EwoudVV/calculator/images/arithmetic-branch-gates.png

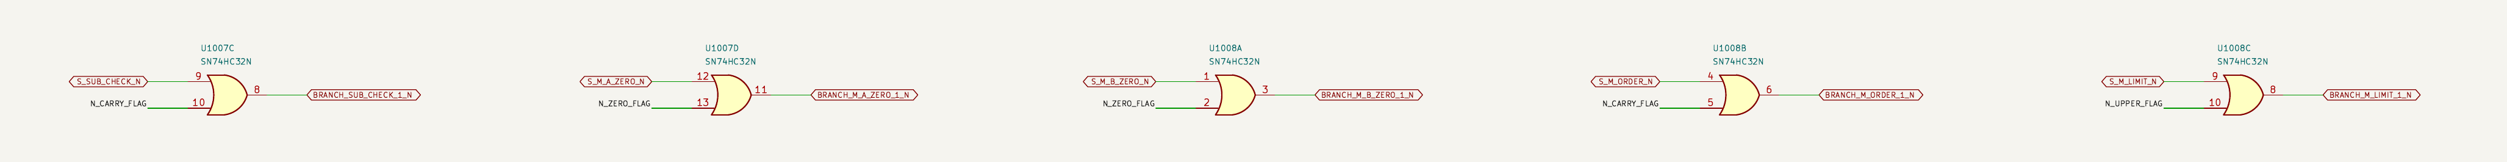
images/arithmetic-branch-gates.png
