EwoudVV/calculator/images/arithmetic-flags.png

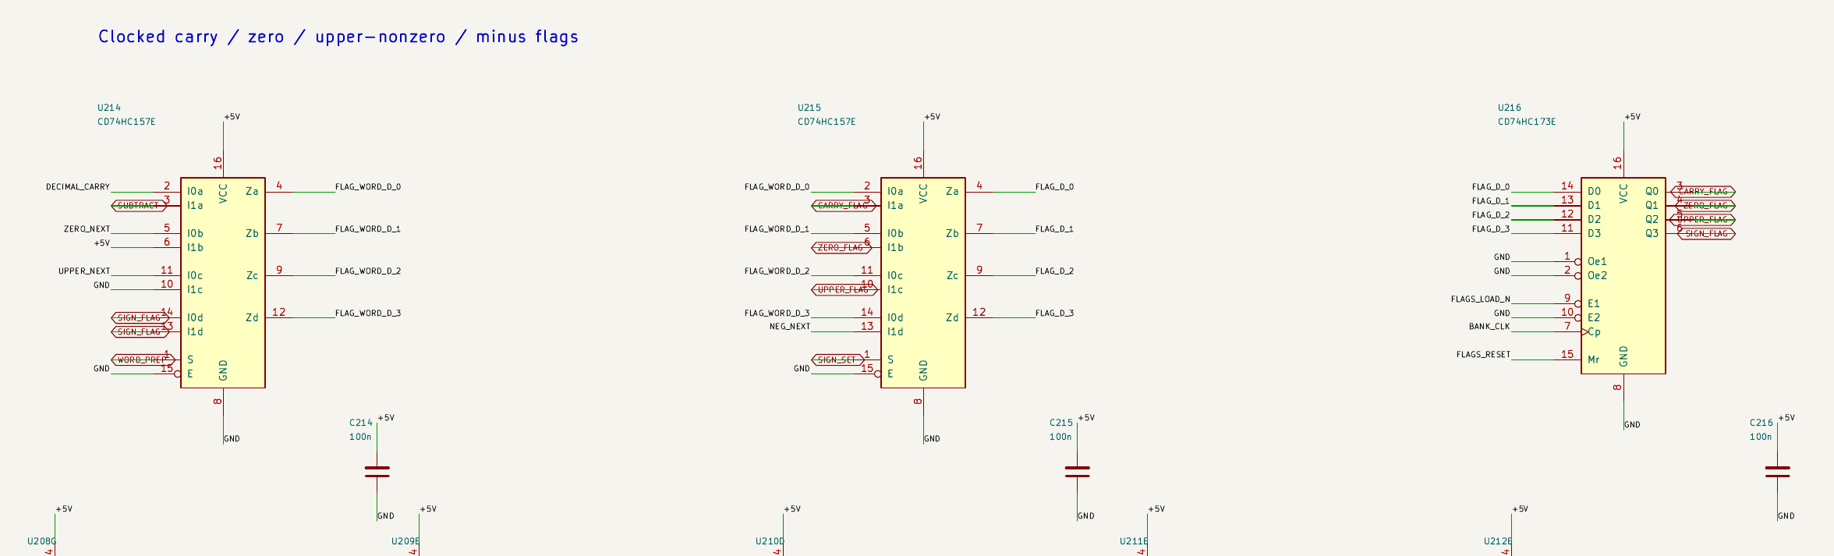
images/arithmetic-flags.png
