EwoudVV/calculator/images/clocked-bank-reset.png

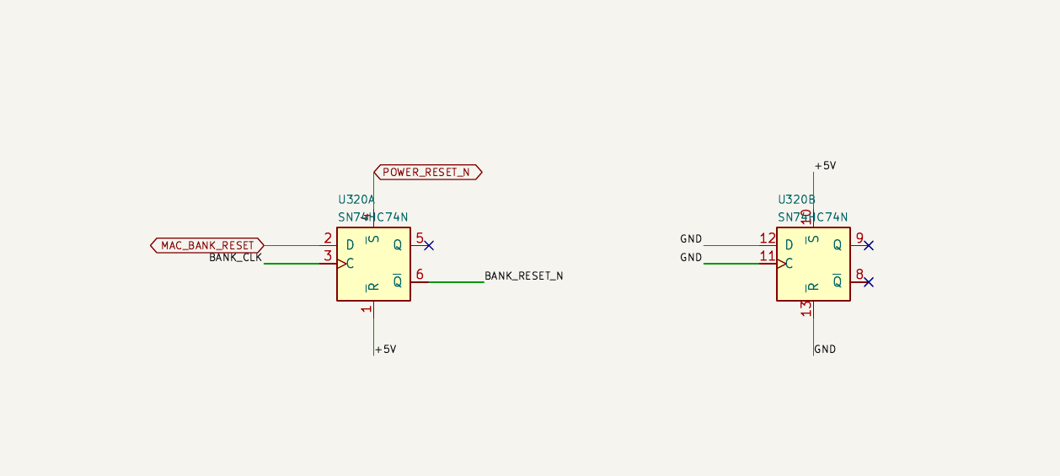
images/clocked-bank-reset.png
