EwoudVV/calculator/images/controller-branches.png

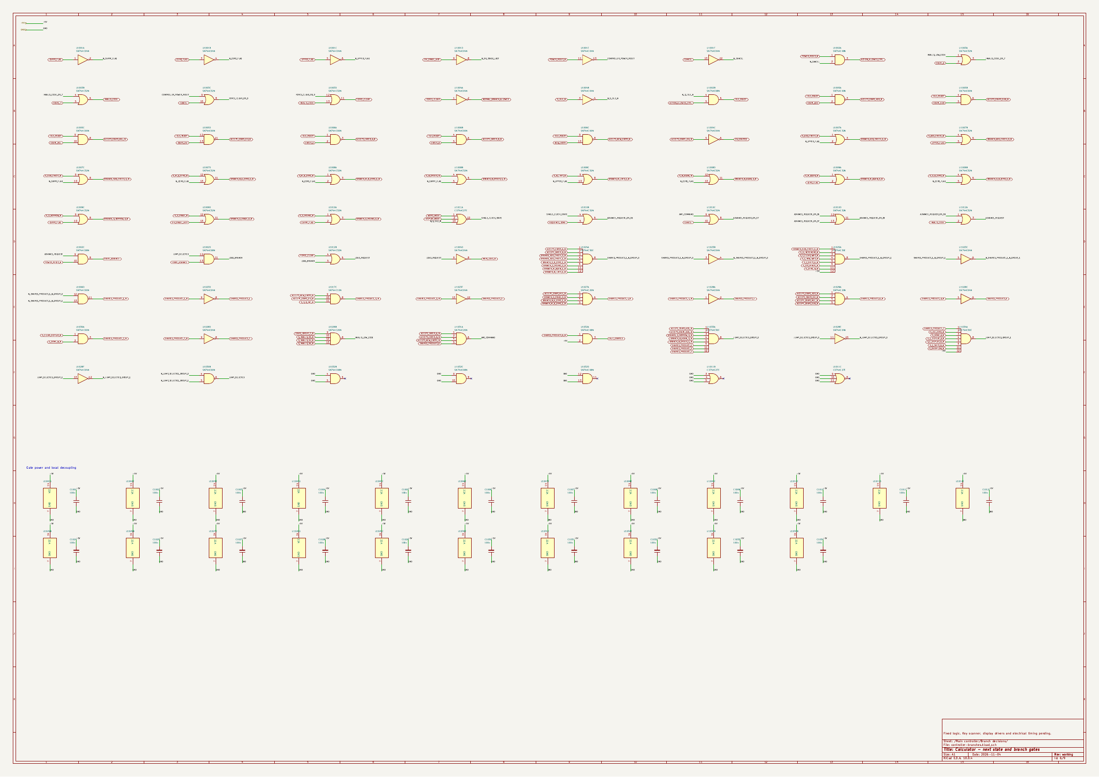
images/controller-branches.png
