EwoudVV/calculator/images/controller-outputs.png

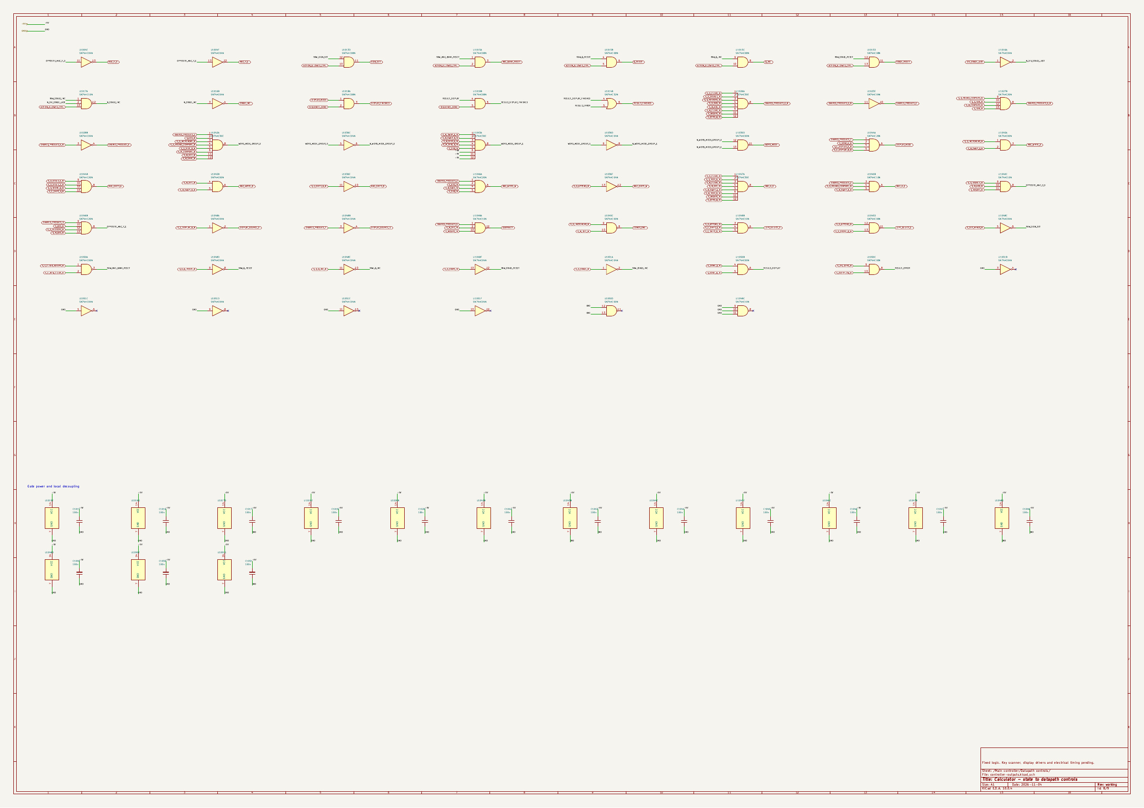
images/controller-outputs.png
