EwoudVV/calculator/images/controller-targets.png

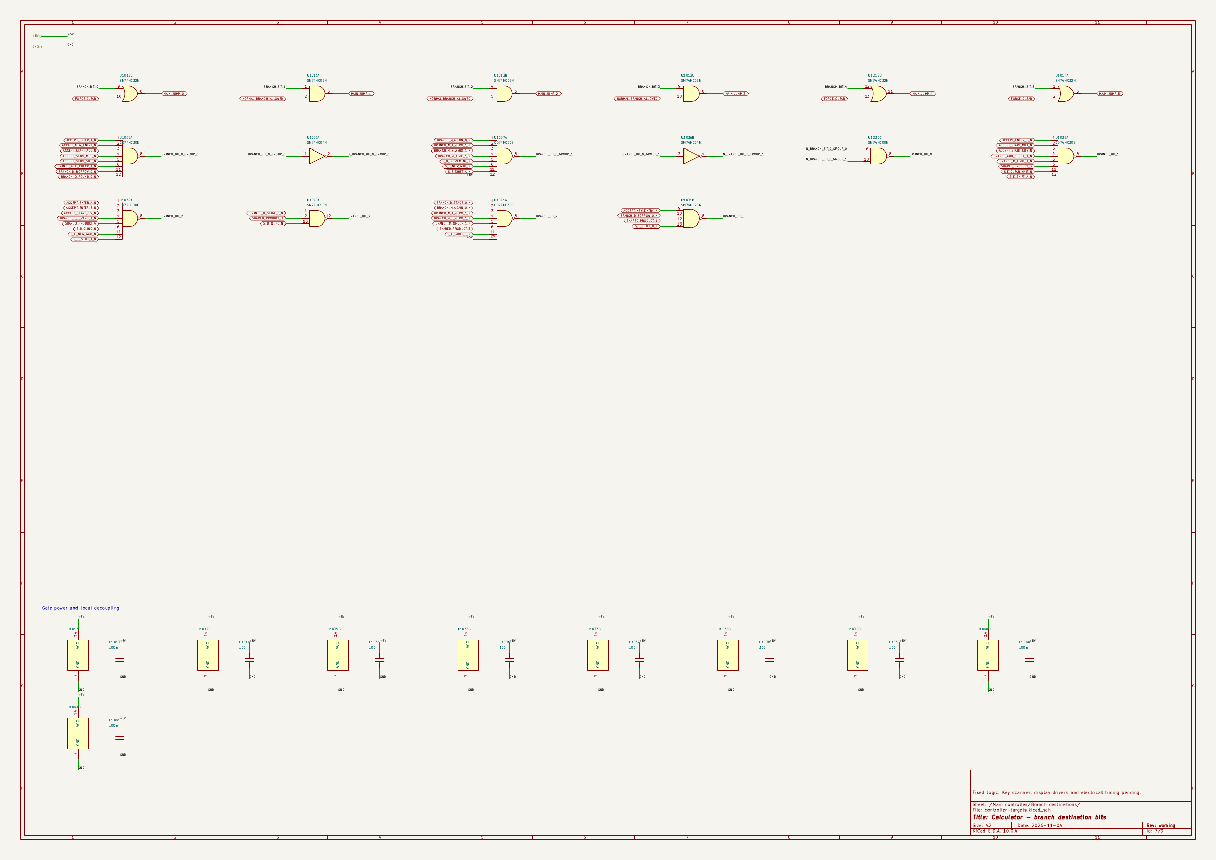
images/controller-targets.png
