EwoudVV/calculator/images/digit-input-selectors.png

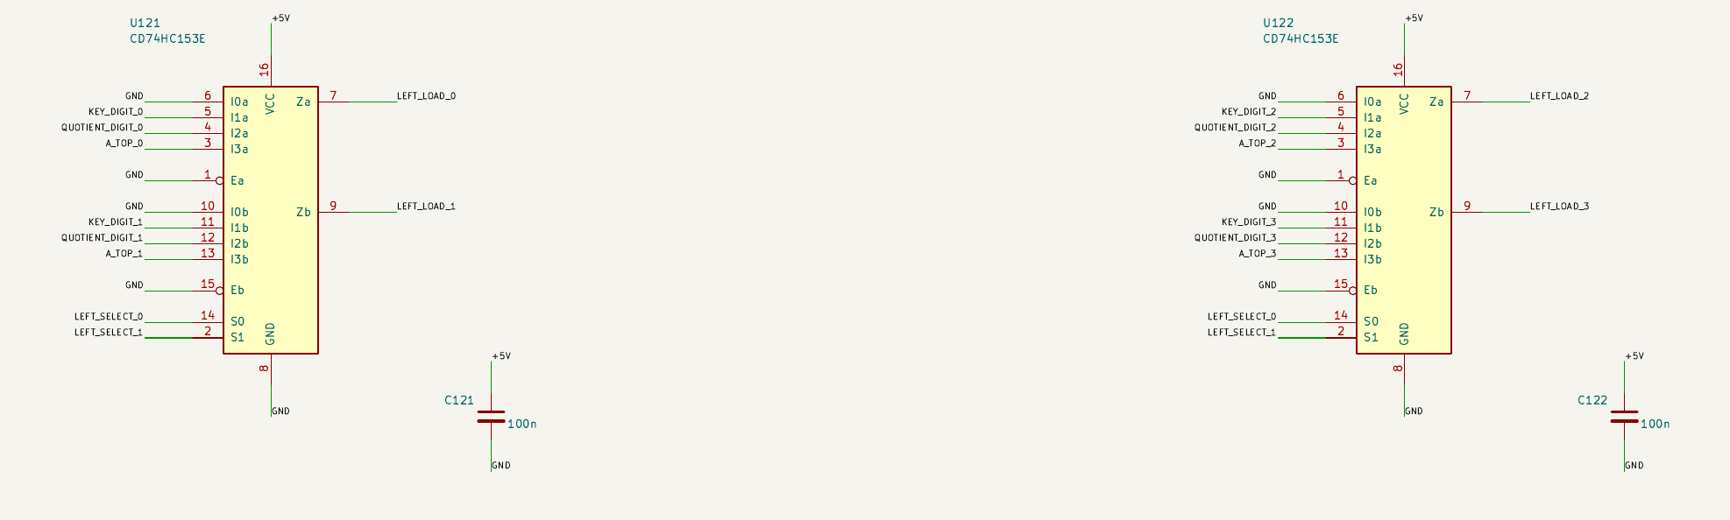
images/digit-input-selectors.png
