EwoudVV/calculator/images/display-latch-register.png

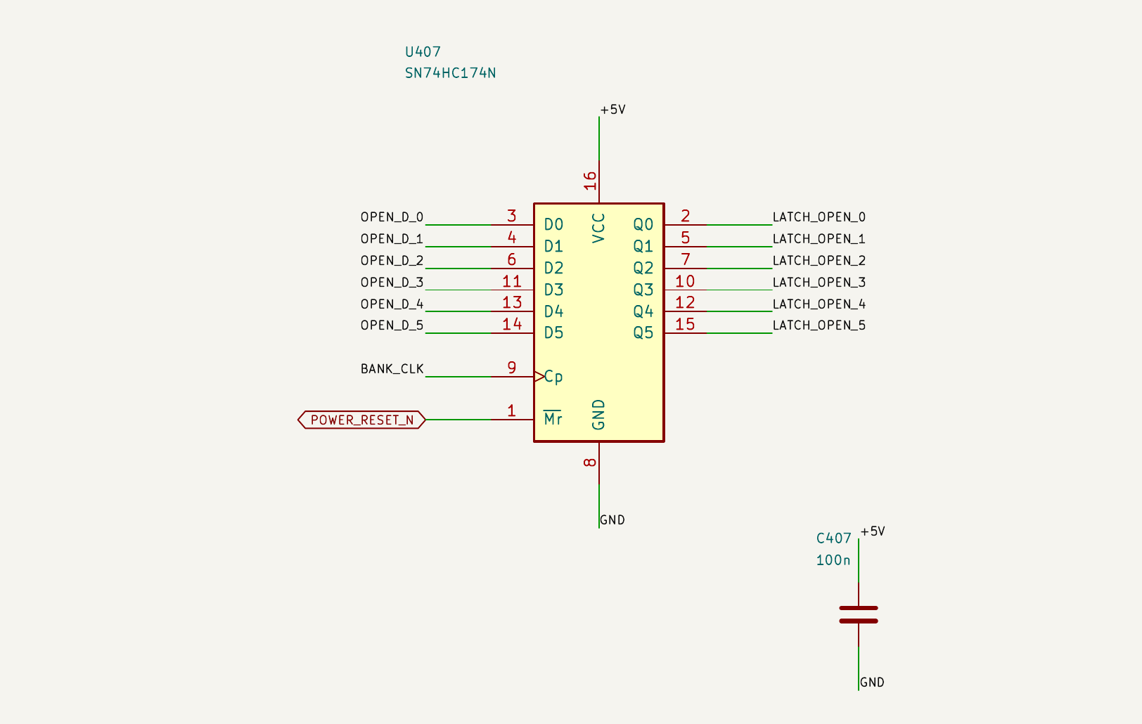
images/display-latch-register.png
