EwoudVV/calculator/images/display-transfer.png

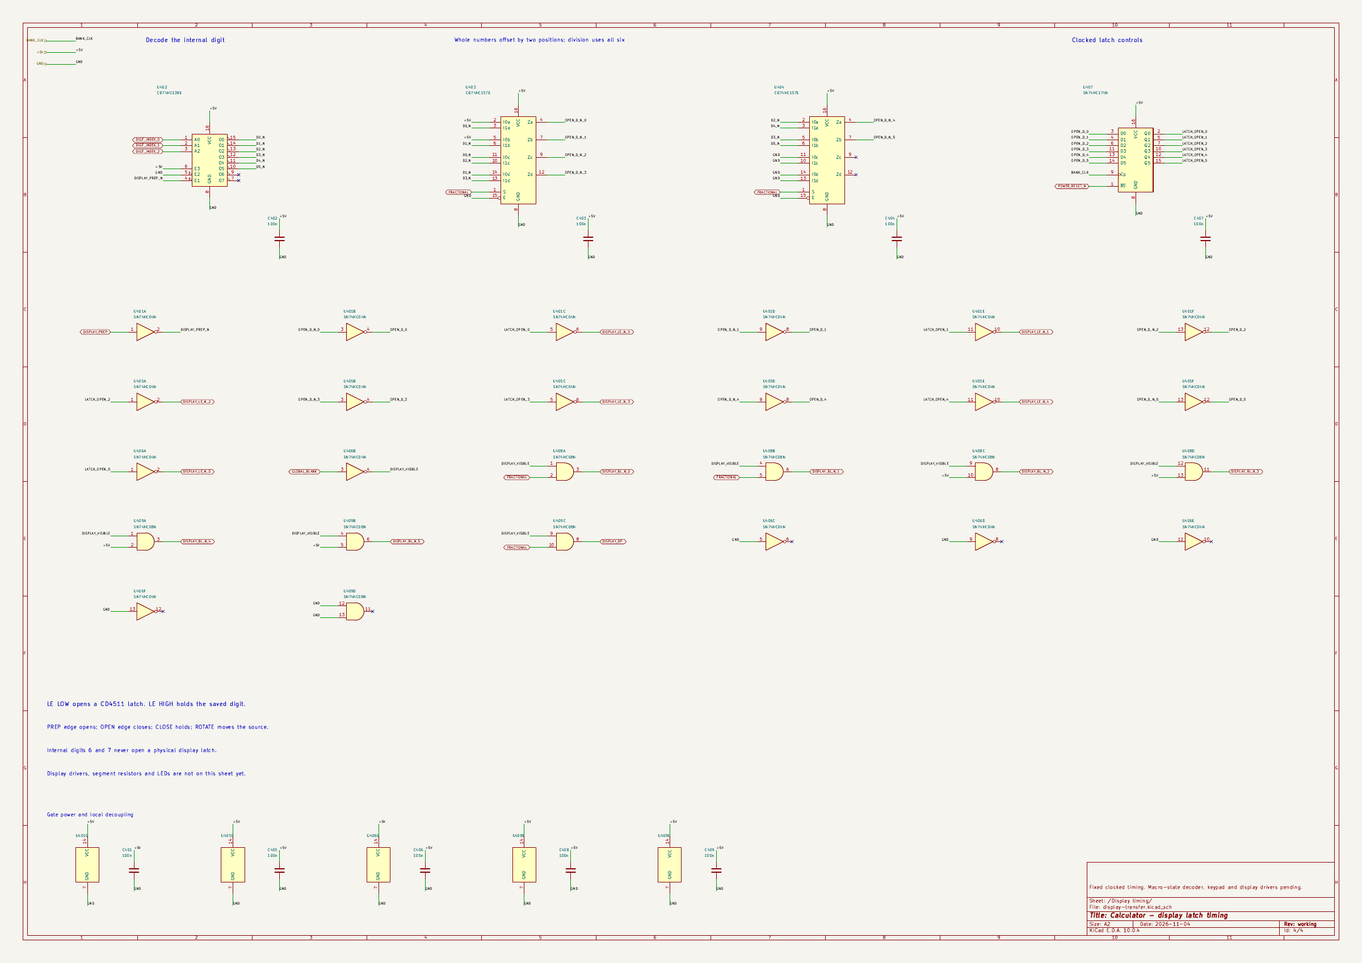
images/display-transfer.png
