EwoudVV/calculator/images/division-counters-status.png

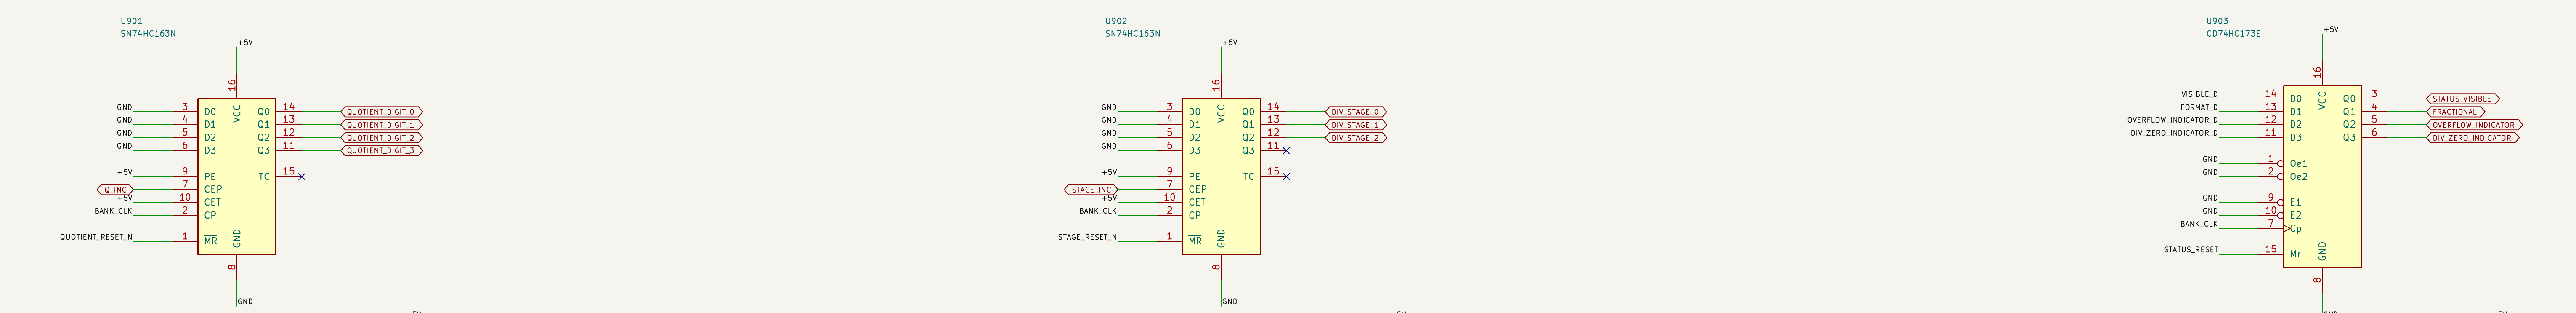
images/division-counters-status.png
