EwoudVV/calculator/images/division-status.png

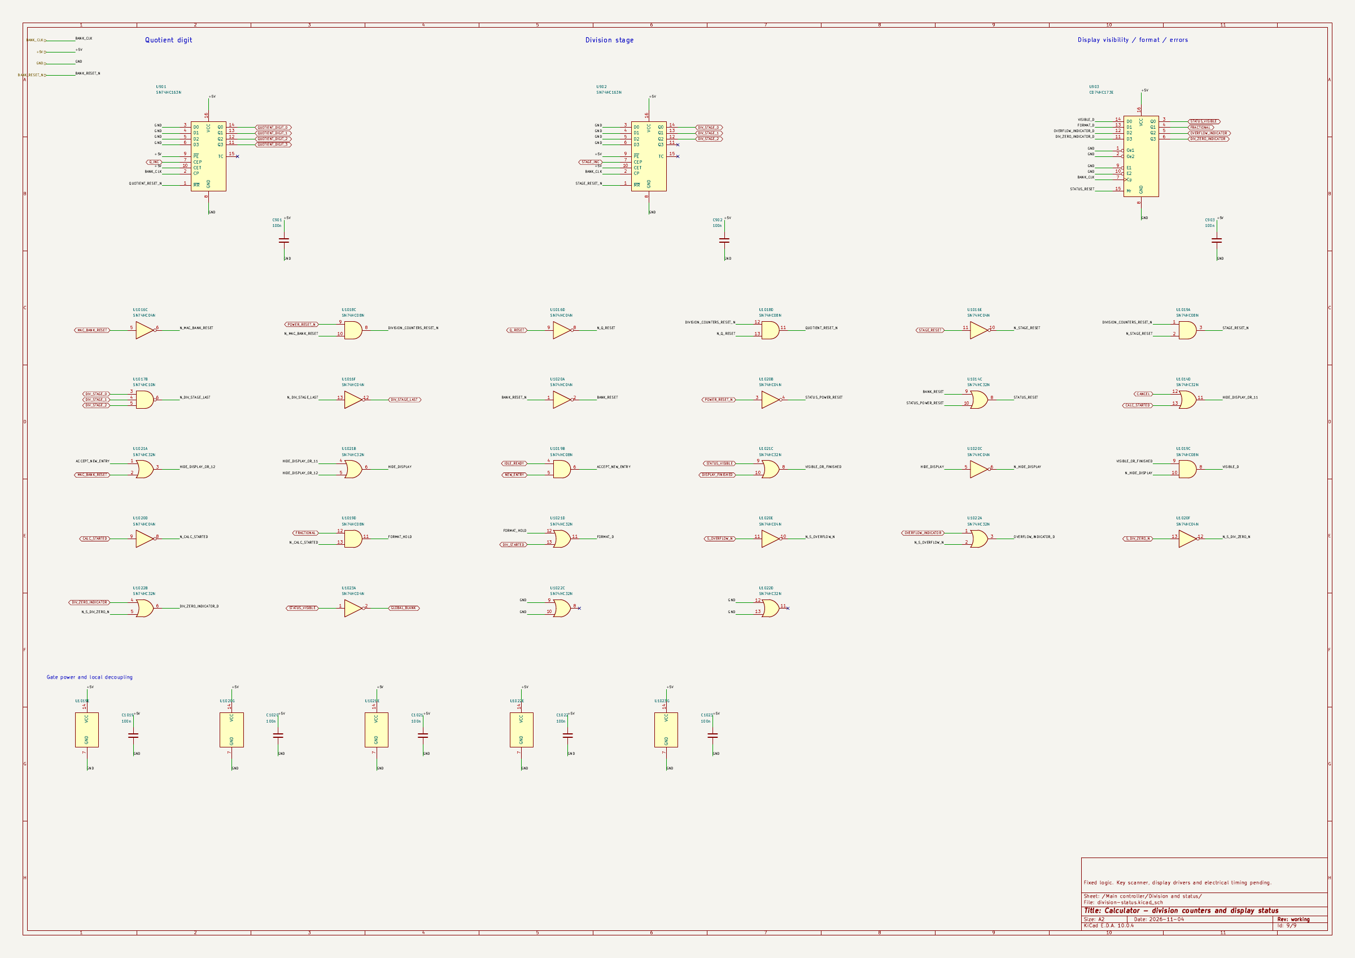
images/division-status.png
