EwoudVV/calculator/images/main-controller.png

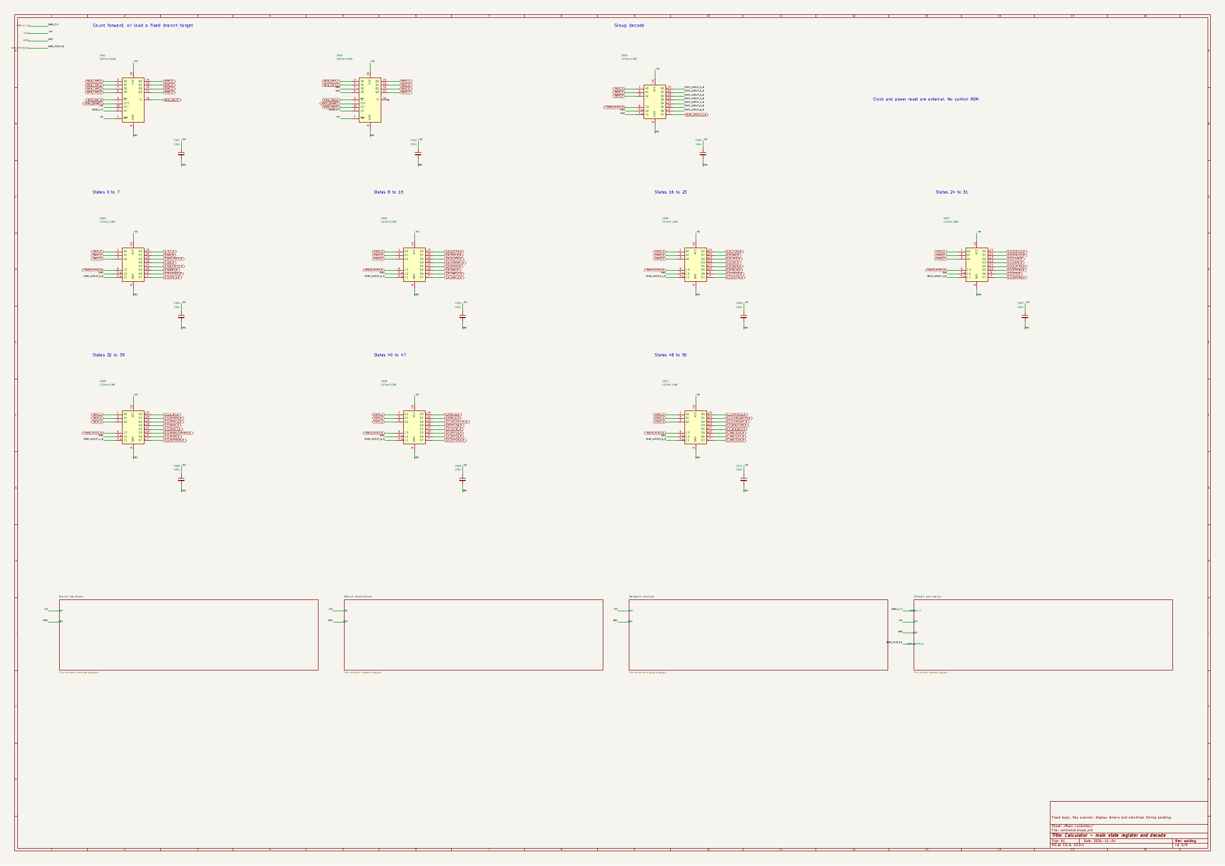
images/main-controller.png
