EwoudVV/calculator/images/main-state-counters.png

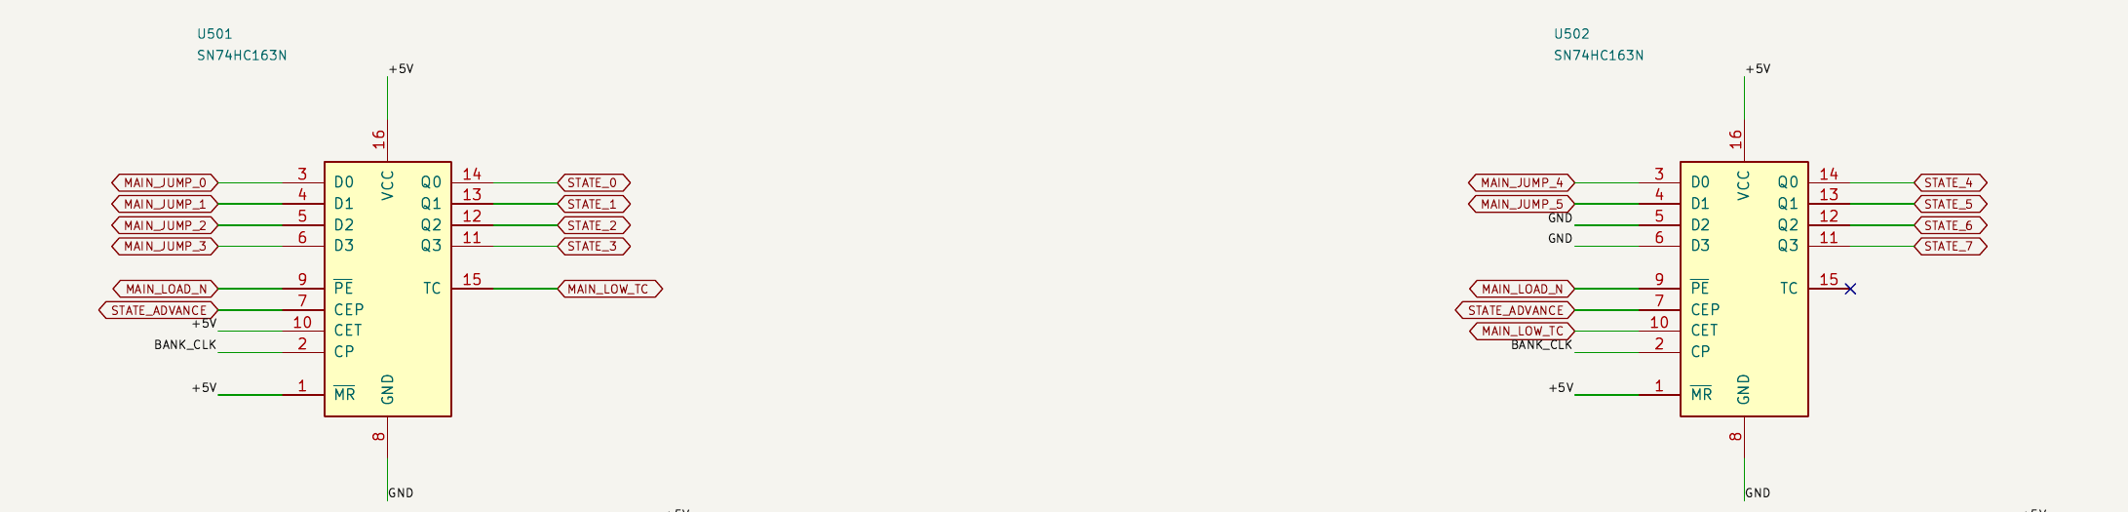
images/main-state-counters.png
