EwoudVV/calculator/images/number-register-bank.png

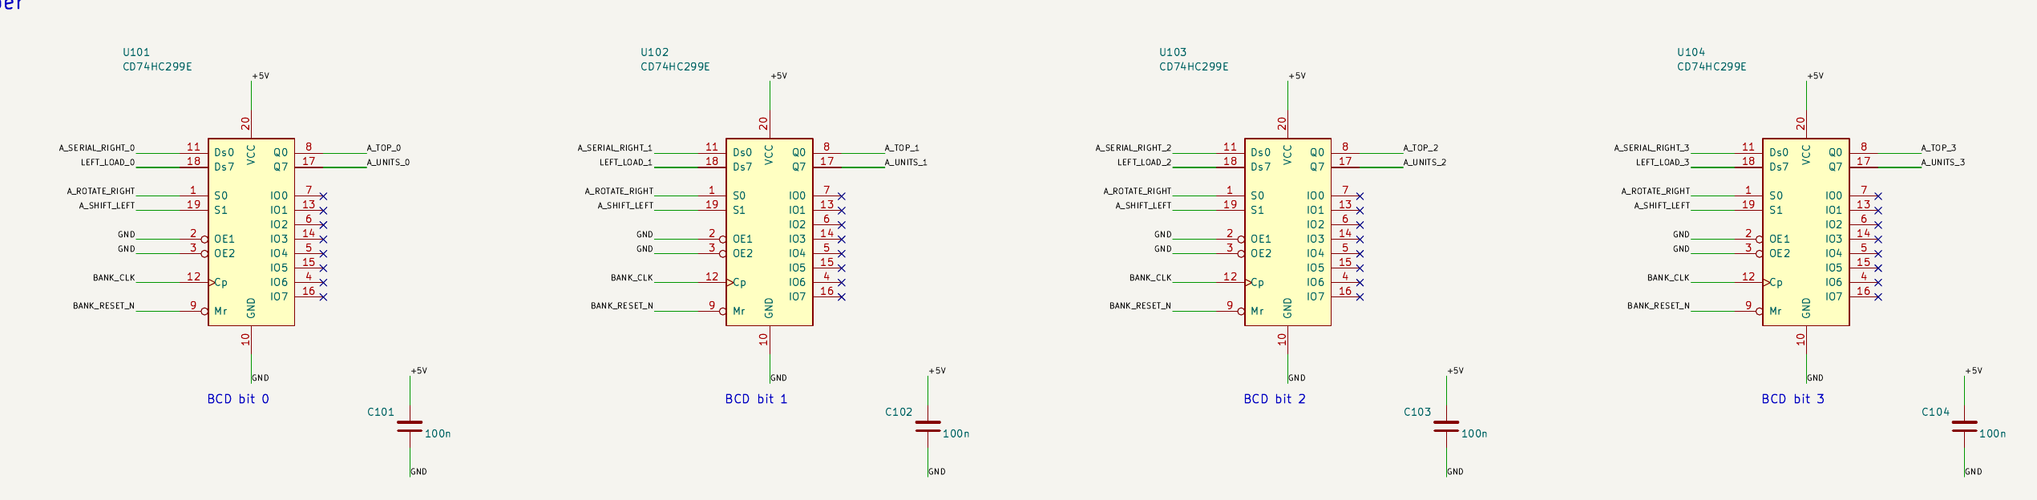
images/number-register-bank.png
