EwoudVV/calculator/images/number-registers.png

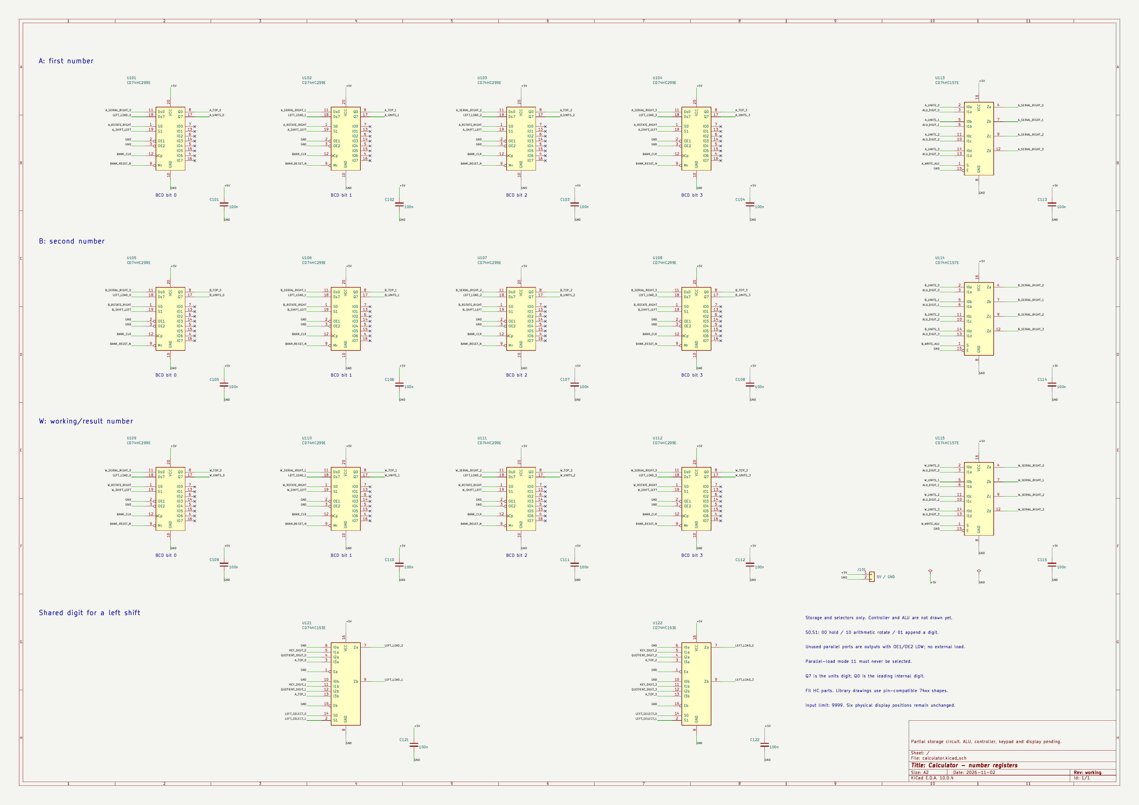
images/number-registers.png
