EwoudVV/calculator/images/pcb-3d-back.png

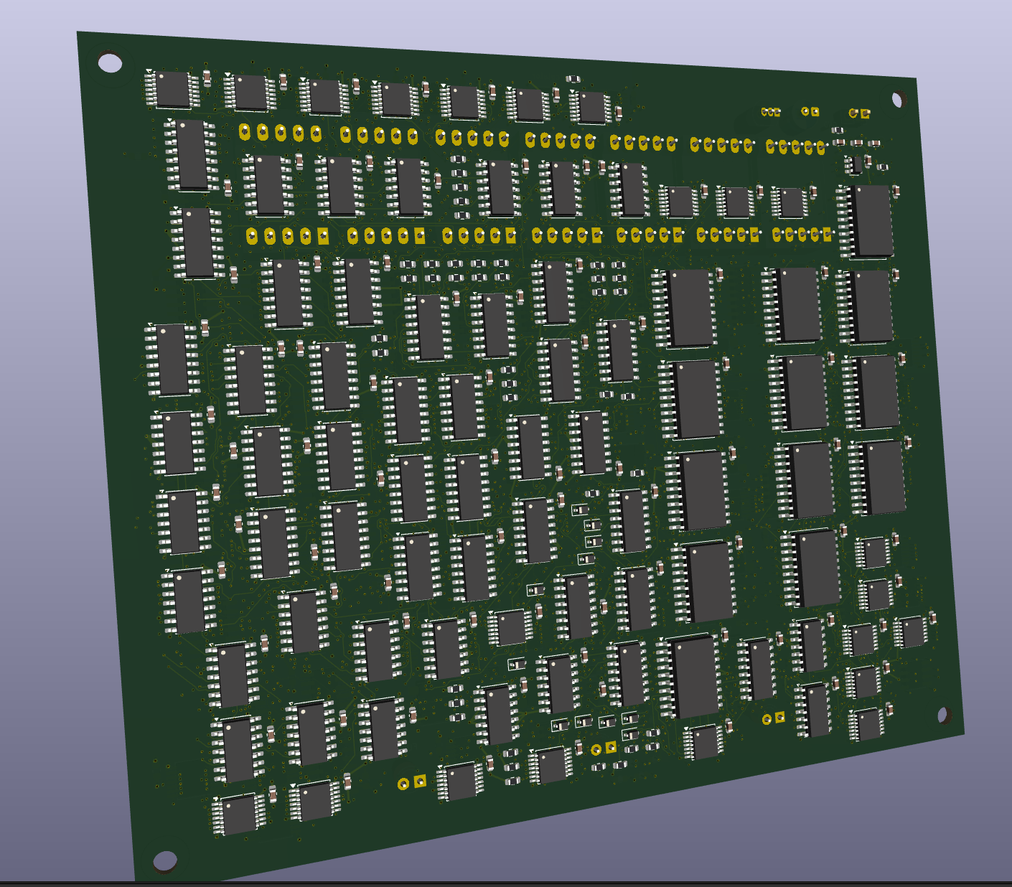
images/pcb-3d-back.png
