EwoudVV/calculator/images/pcb-3d-front.png

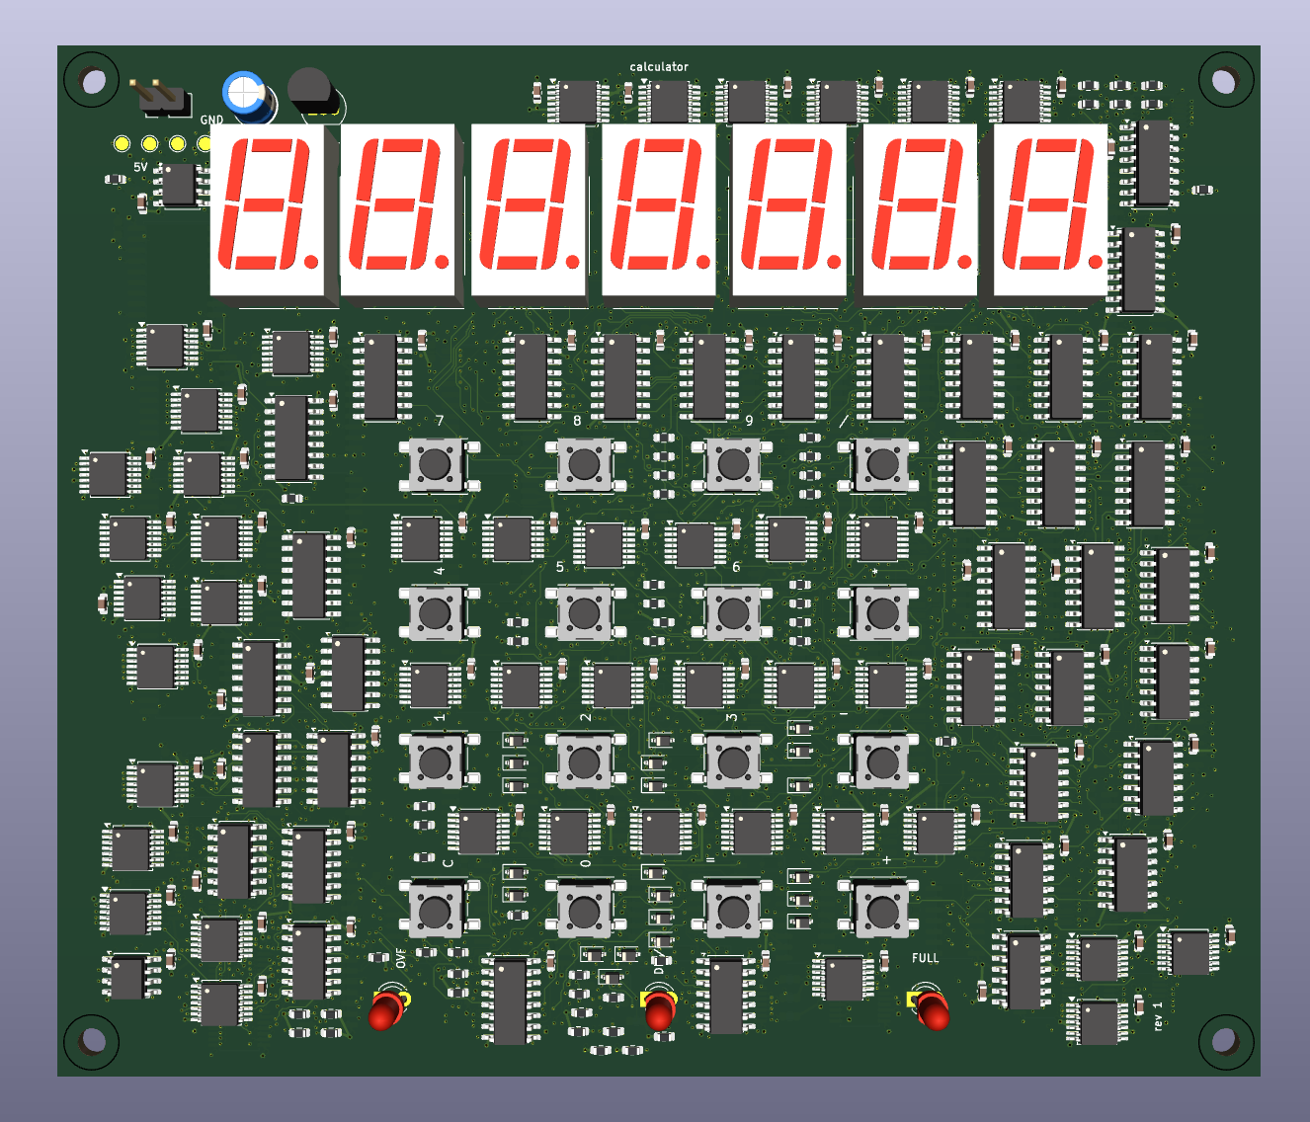
images/pcb-3d-front.png
