EwoudVV/calculator/images/pcb-back.png

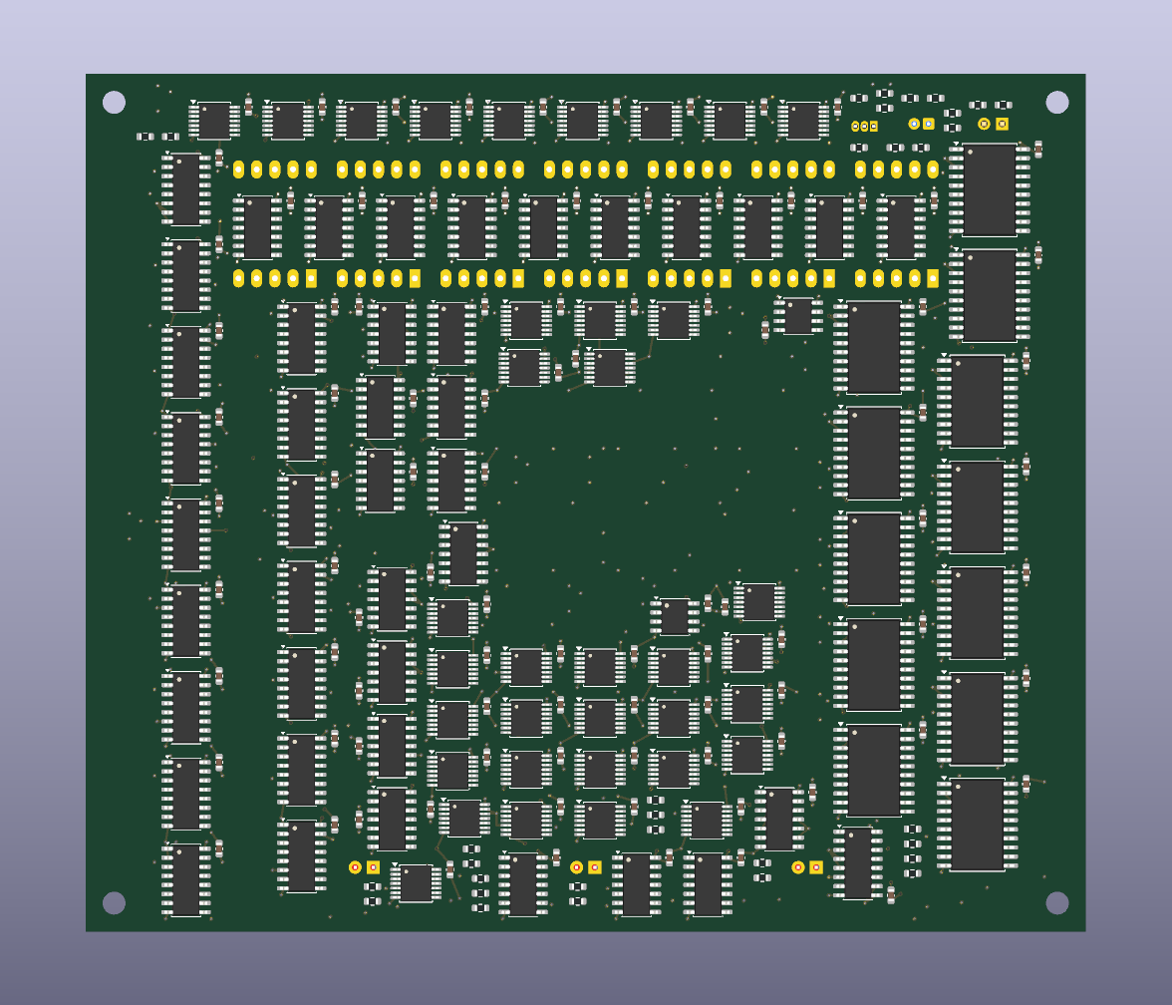
images/pcb-back.png
