EwoudVV/calculator/images/register-bit-lane.png

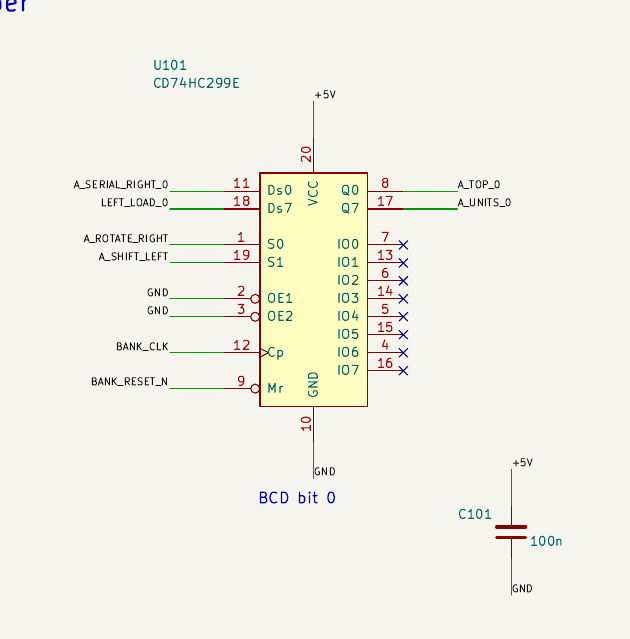
images/register-bit-lane.png
