EwoudVV/calculator/images/register-feedback-selector.png

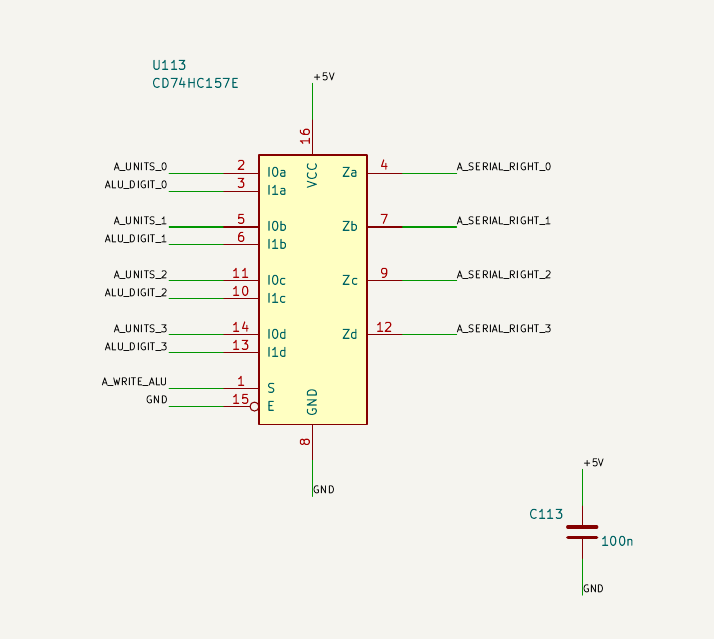
images/register-feedback-selector.png
