EwoudVV/calculator/images/registers-linked.png

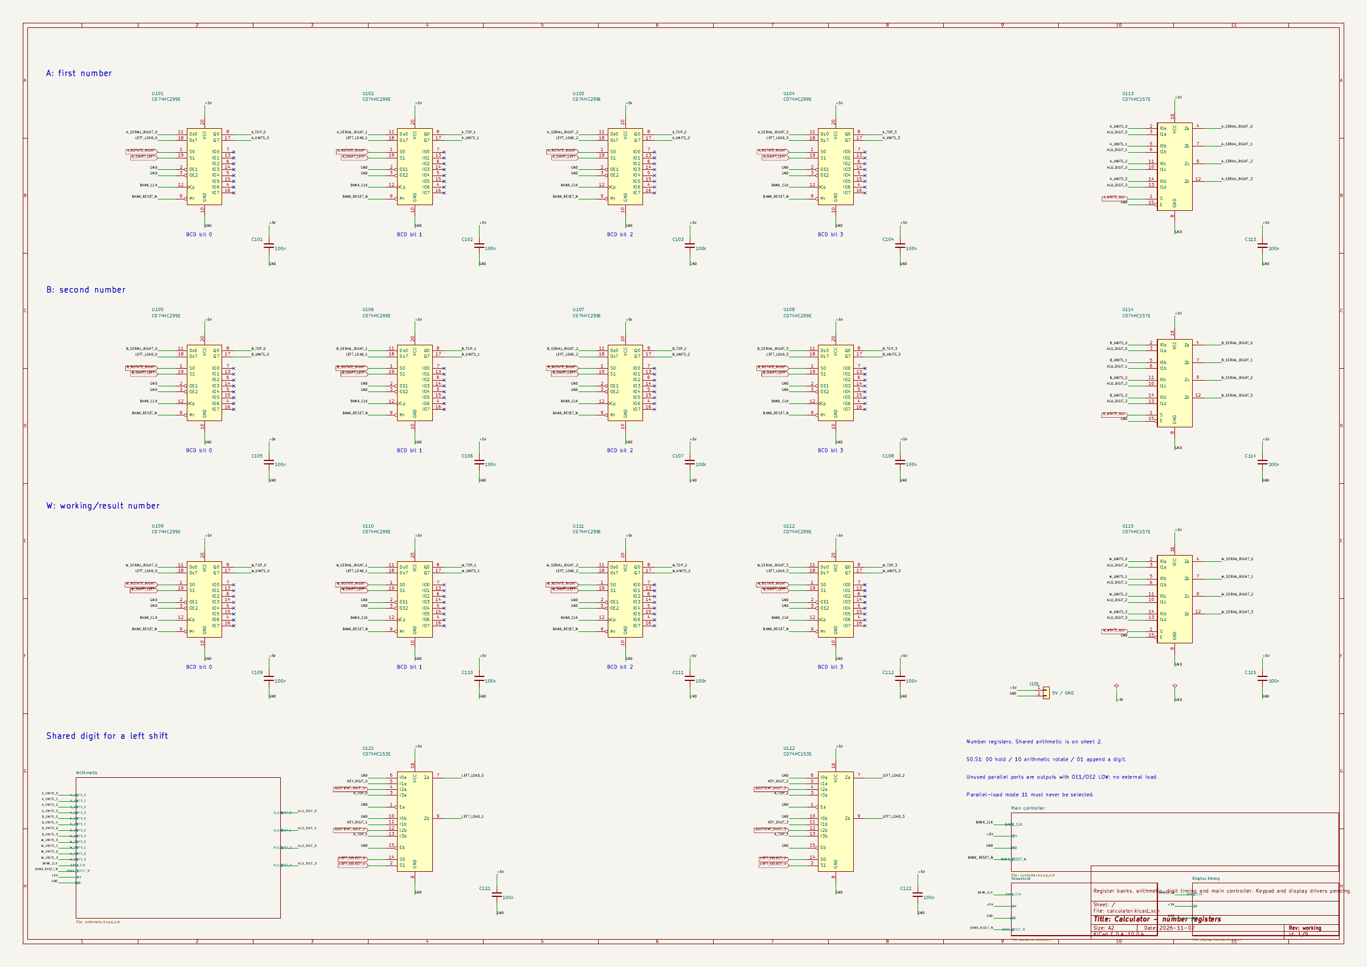
images/registers-linked.png
