EwoudVV/calculator/images/routed-back.png

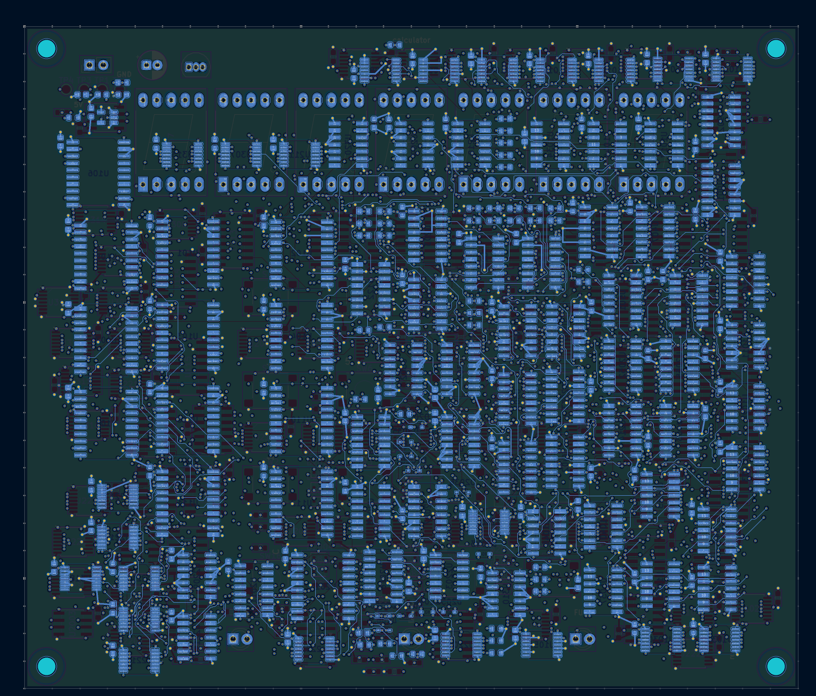
images/routed-back.png
