EwoudVV/calculator/images/routed-front.png

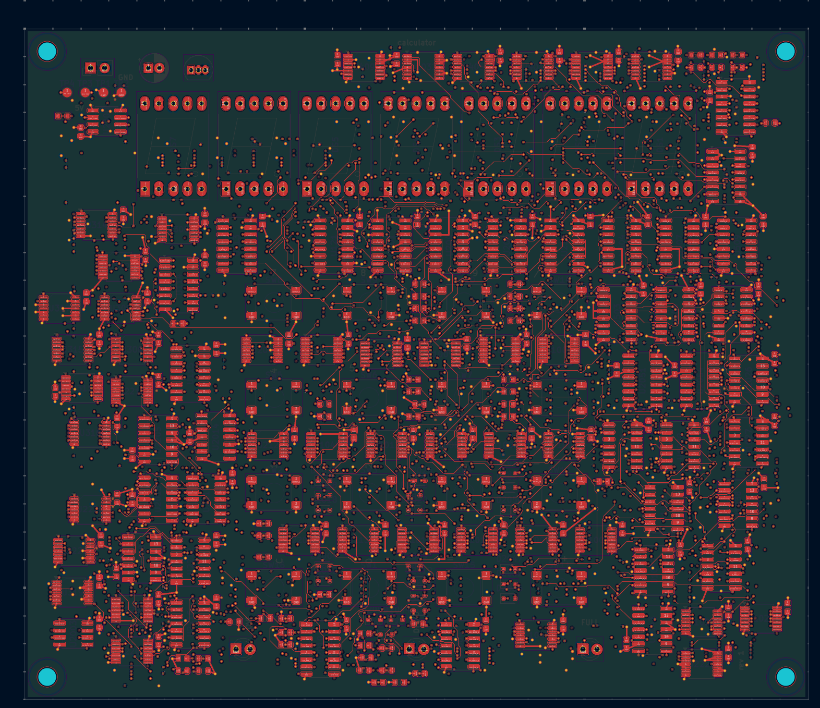
images/routed-front.png
