EwoudVV/calculator/images/routed-inner-1-ground.png

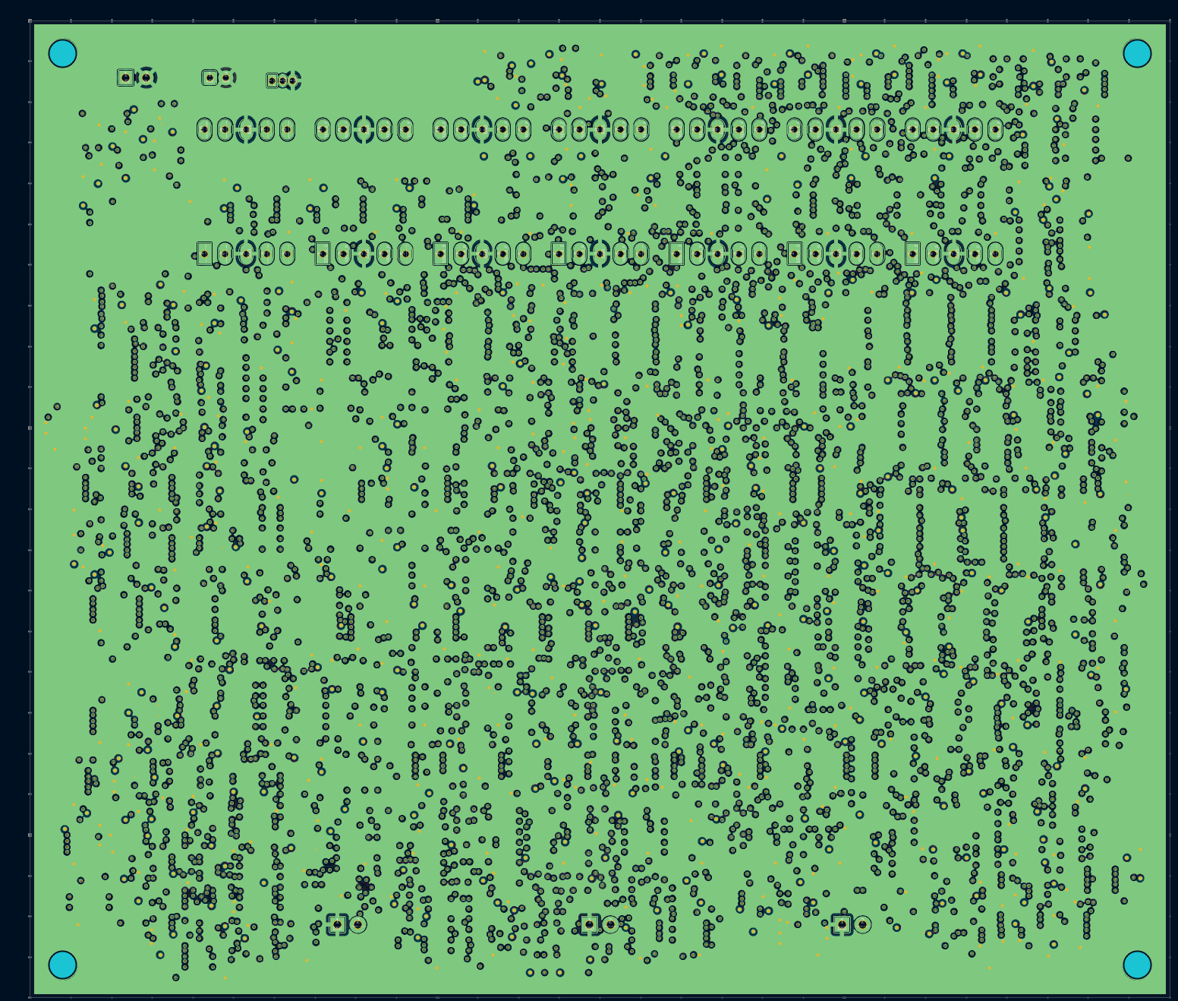
images/routed-inner-1-ground.png
