EwoudVV/calculator/images/routed-inner-2.png

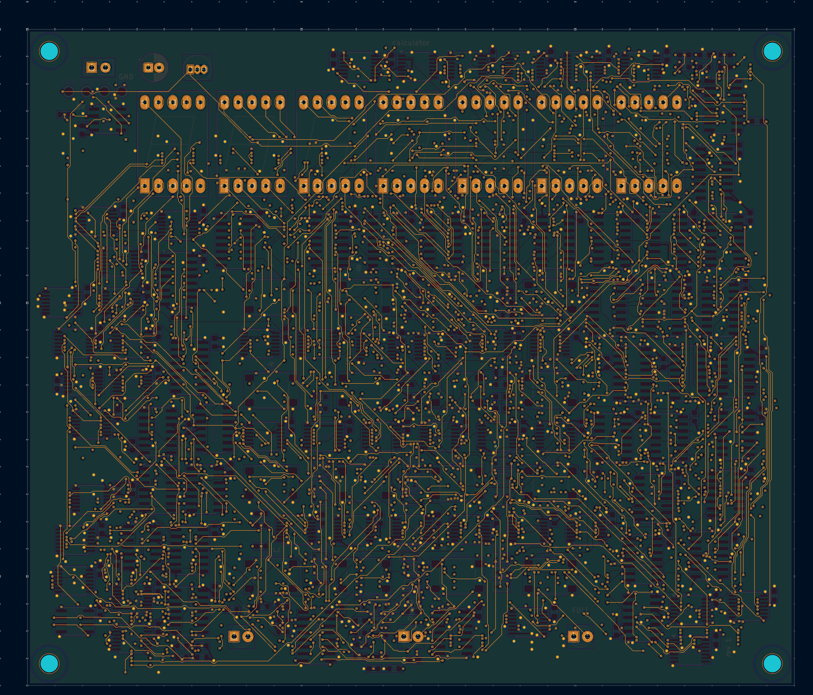
images/routed-inner-2.png
