EwoudVV/calculator/images/routed-inner-3.png

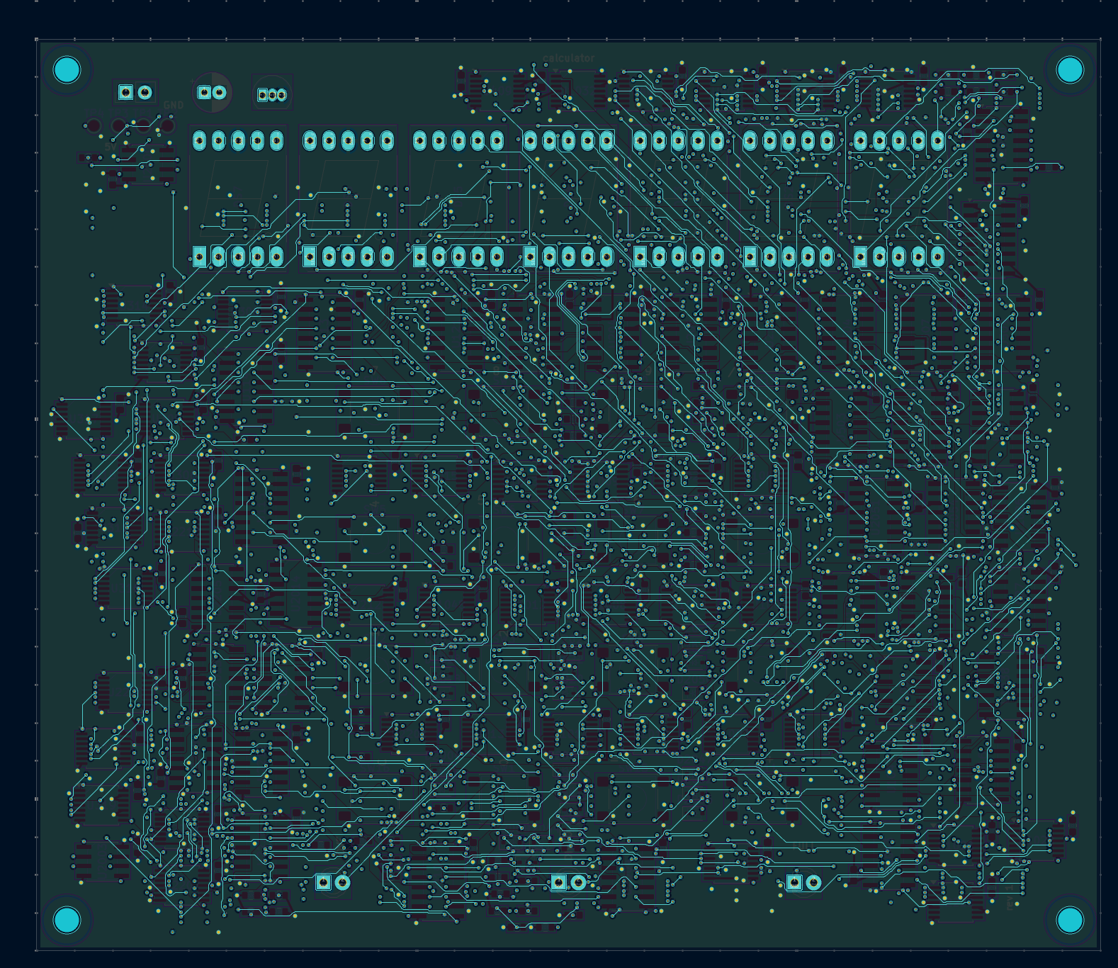
images/routed-inner-3.png
