EwoudVV/calculator/images/routed-inner-4.png

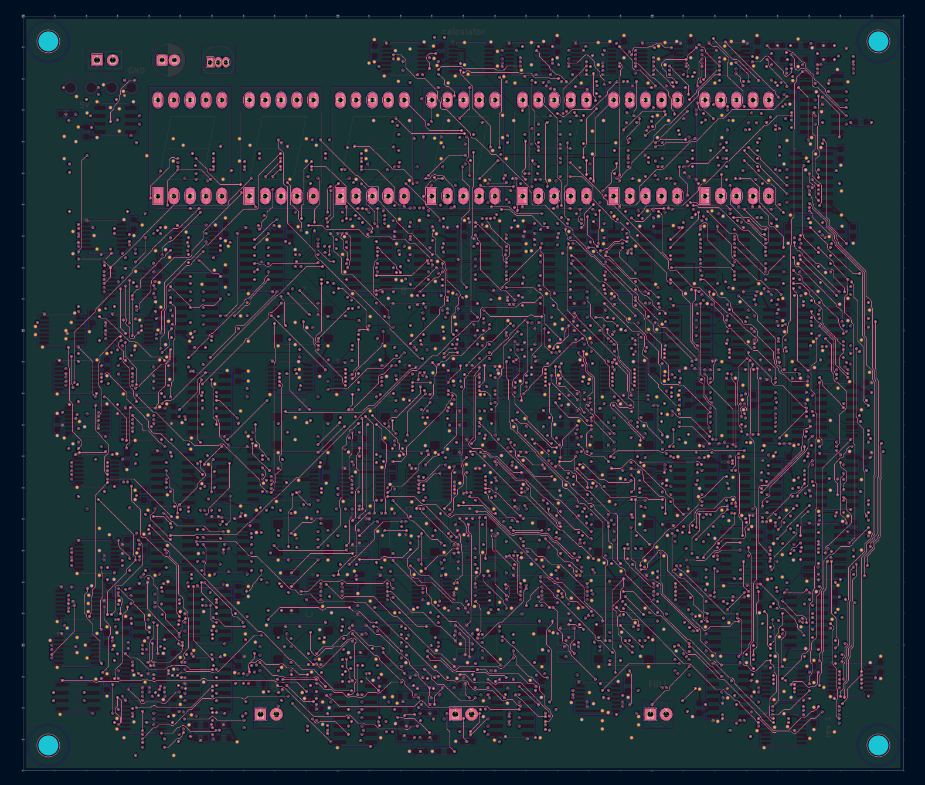
images/routed-inner-4.png
