EwoudVV/calculator/images/routed-inner-5.png

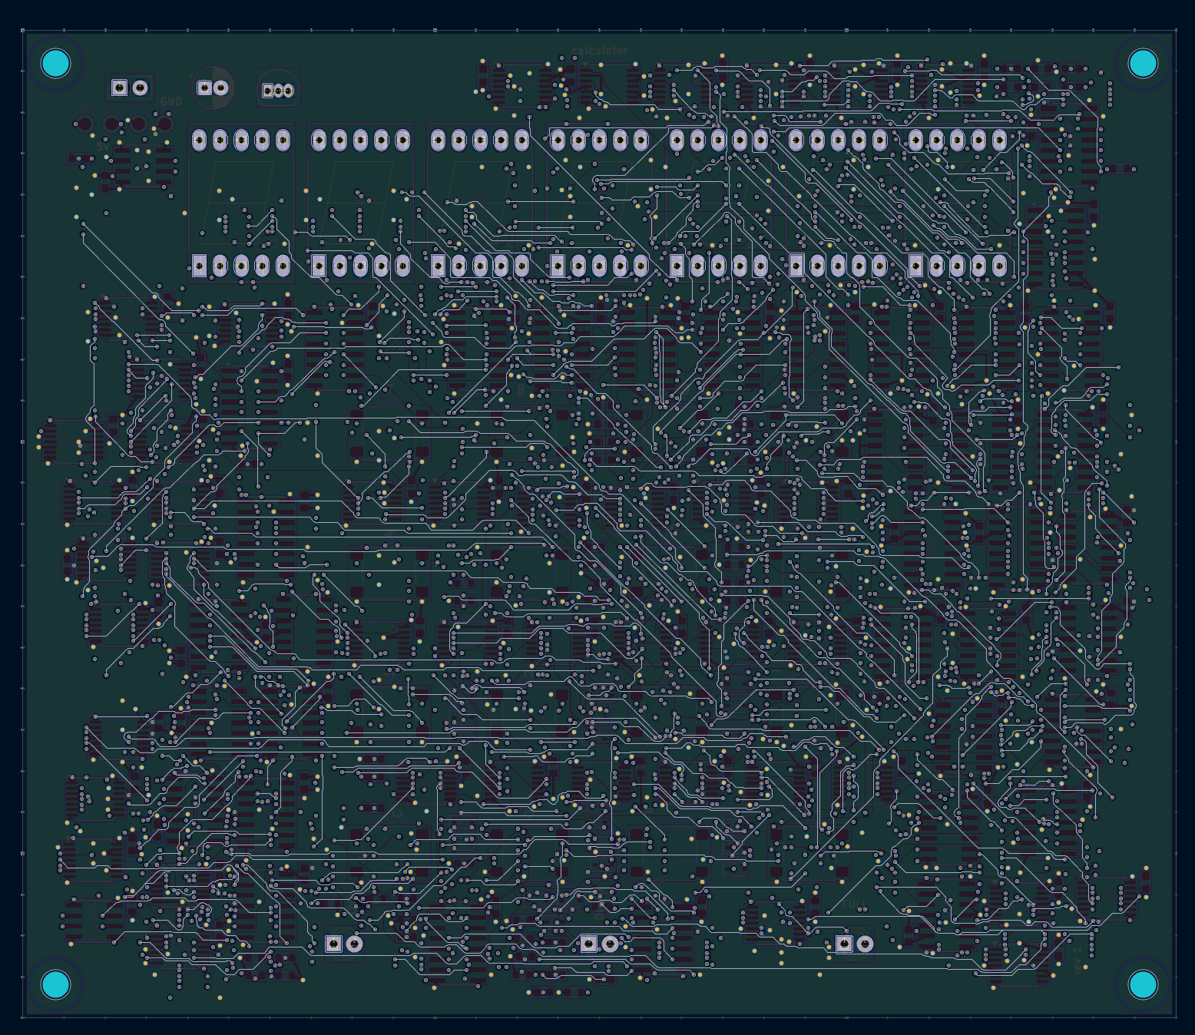
images/routed-inner-5.png
