EwoudVV/calculator/images/routed-inner-7.png

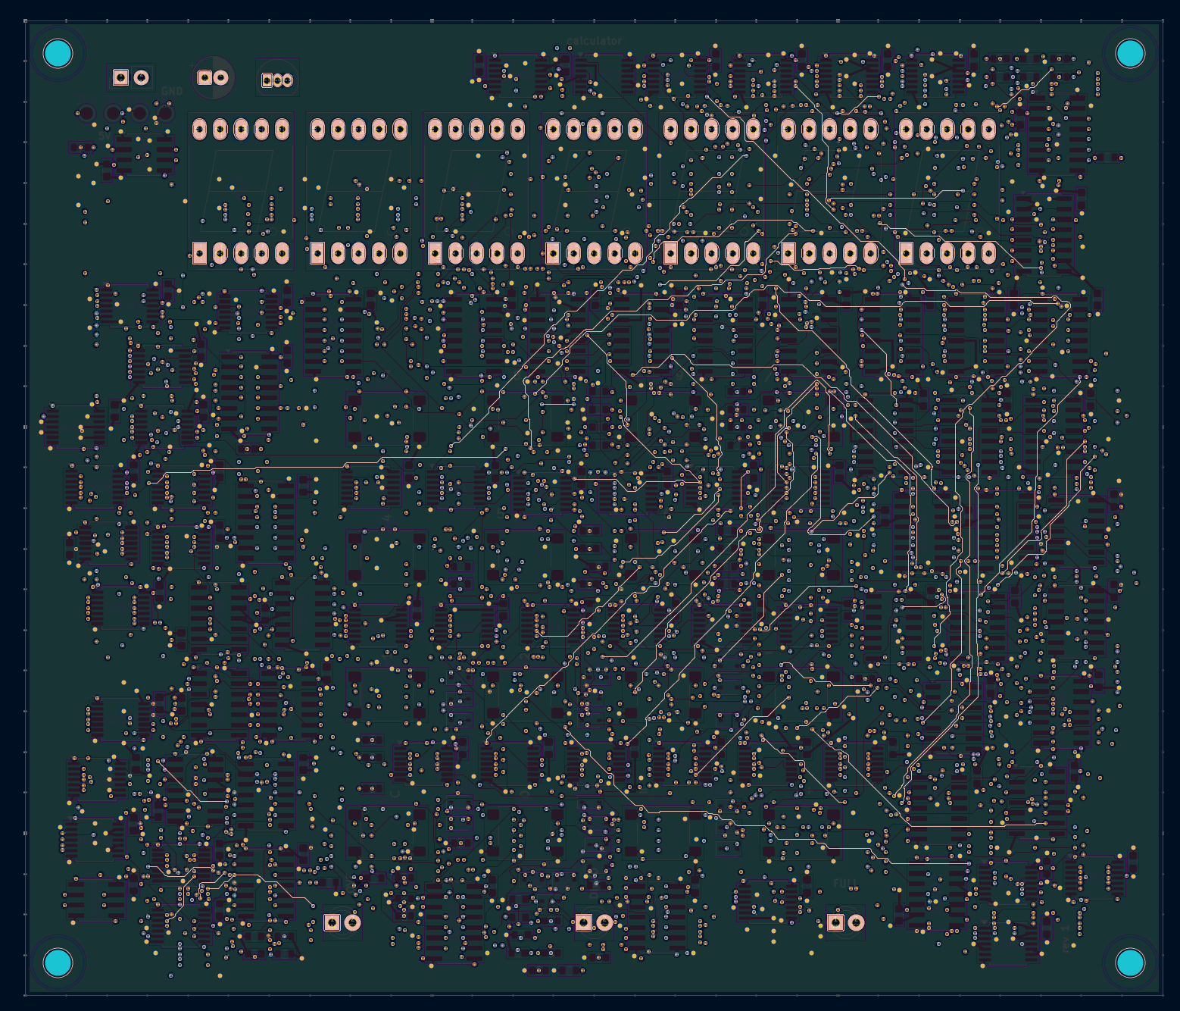
images/routed-inner-7.png
