EwoudVV/calculator/images/routed-inner-8.png

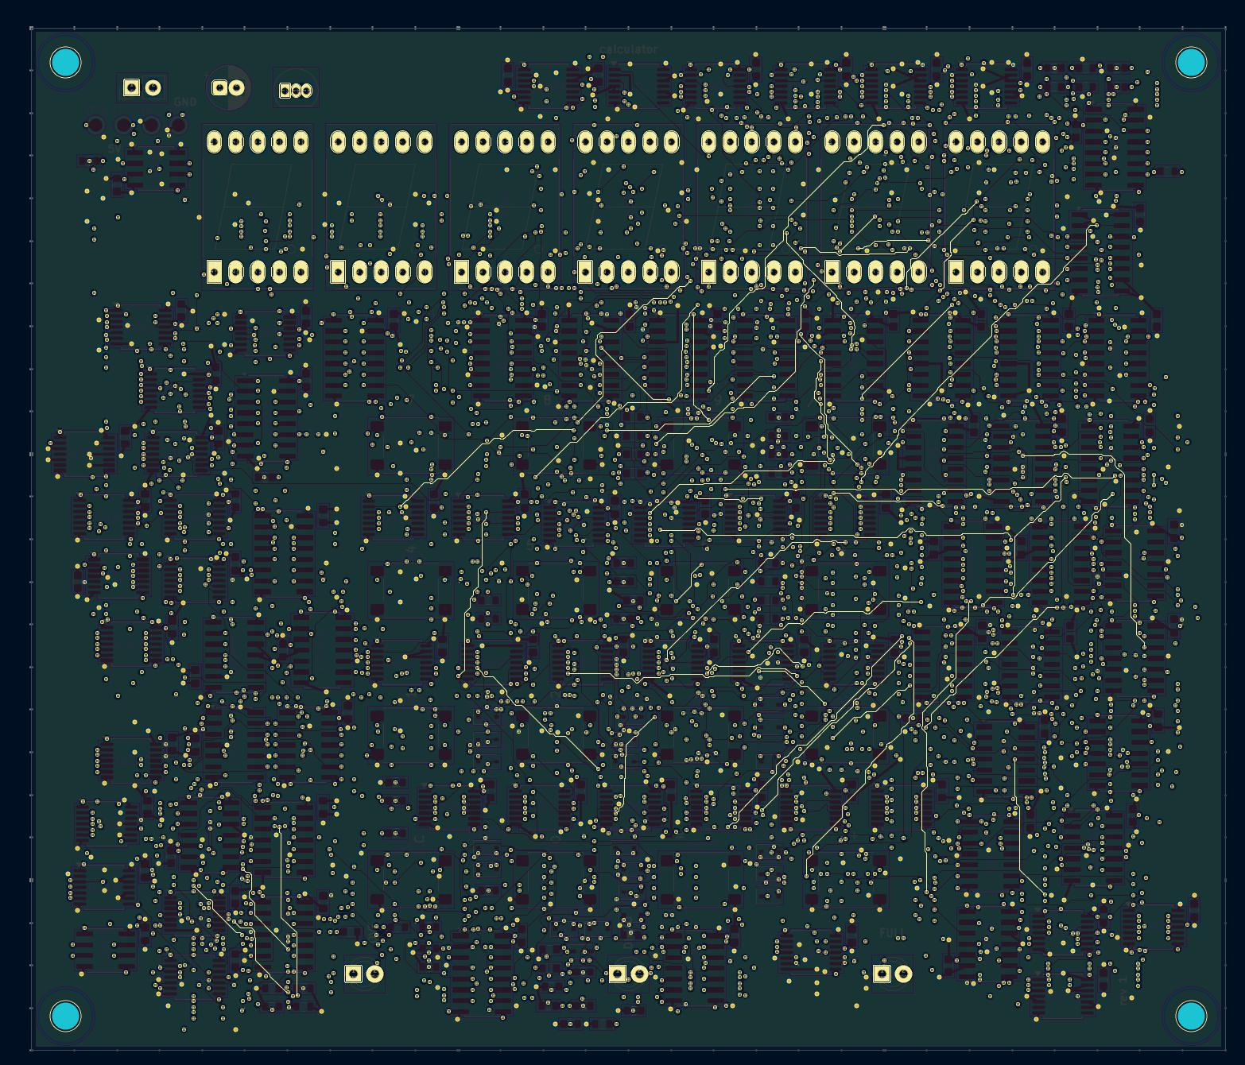
images/routed-inner-8.png
