EwoudVV/calculator/images/routed-inner-9.png

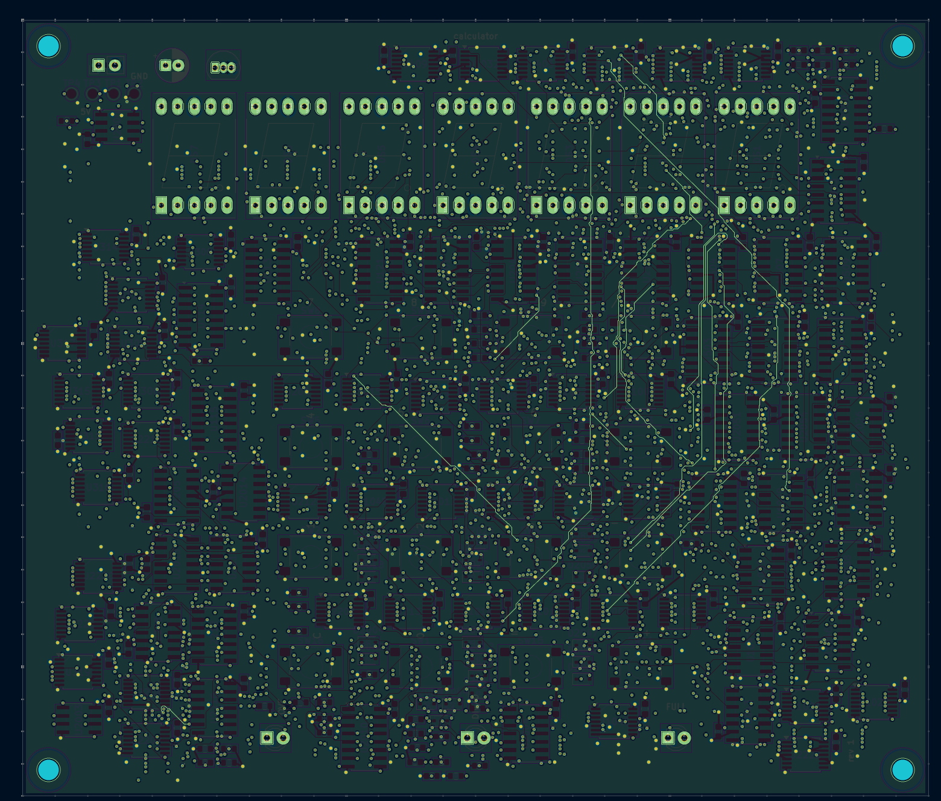
images/routed-inner-9.png
