EwoudVV/calculator/images/routed-inner-10.png

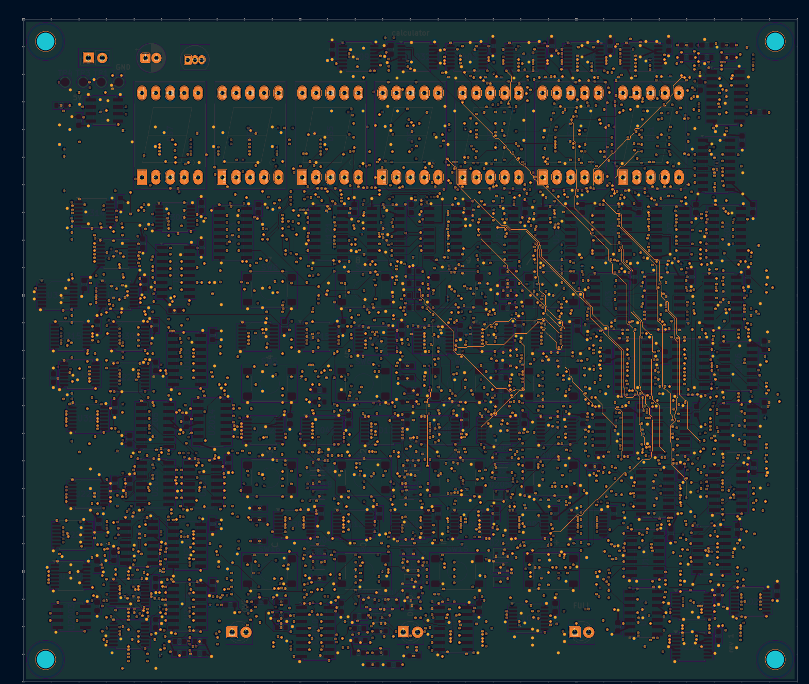
images/routed-inner-10.png
