EwoudVV/calculator/images/routed-inner-11.png

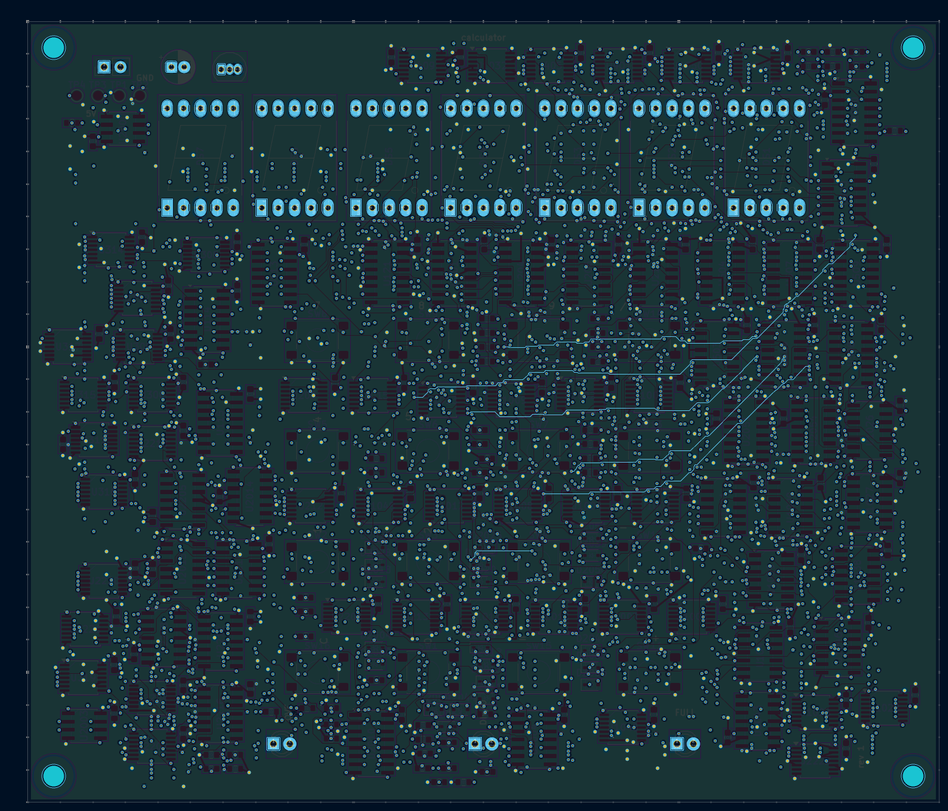
images/routed-inner-11.png
