EwoudVV/calculator/images/routed-inner-12.png

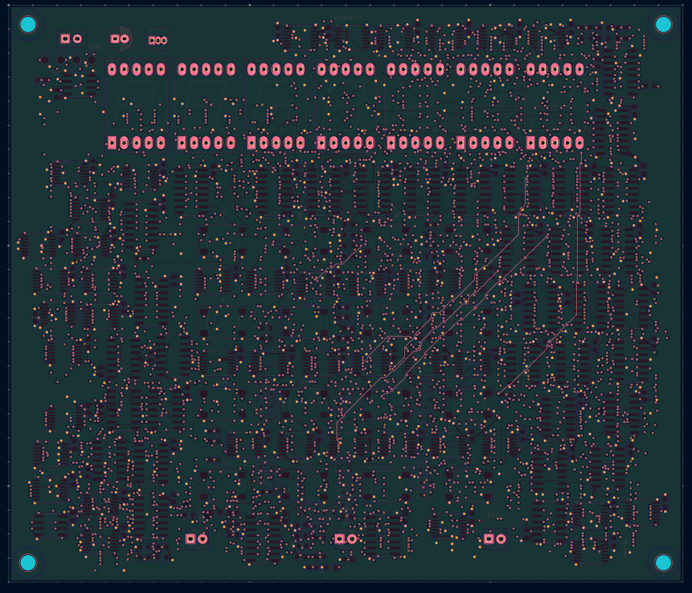
images/routed-inner-12.png
