EwoudVV/calculator/images/routed-inner-13.png

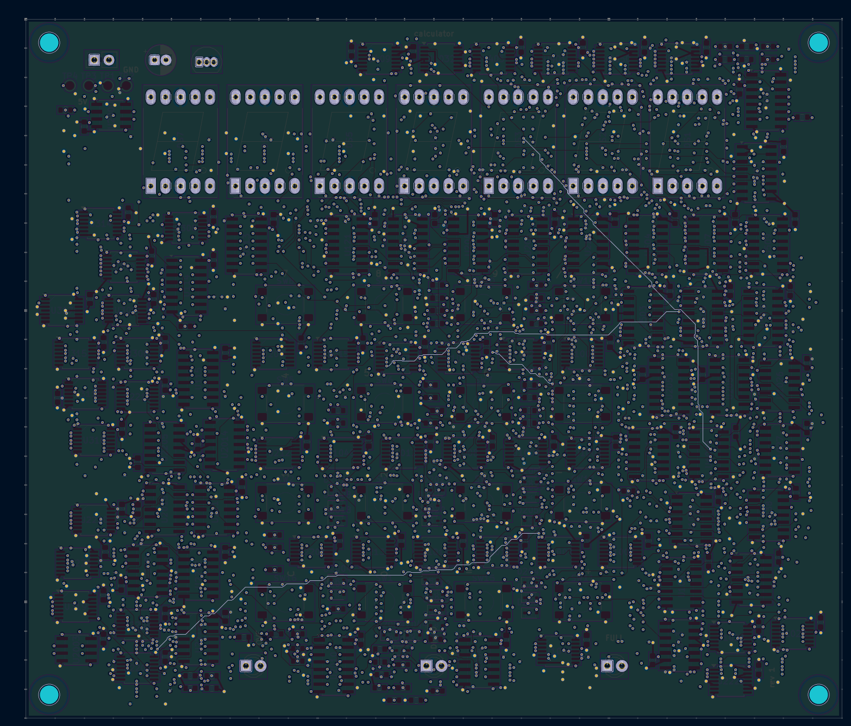
images/routed-inner-13.png
