EwoudVV/calculator/images/routed-inner-14.png

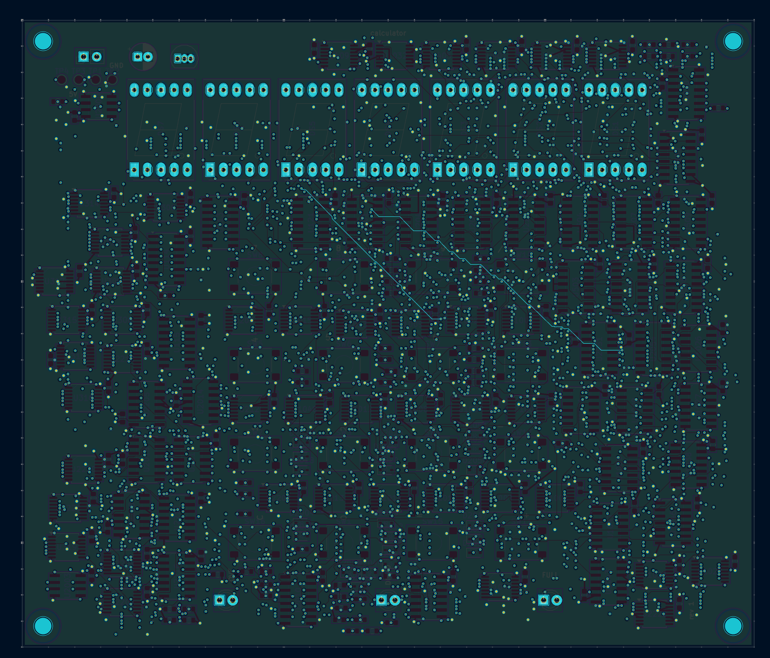
images/routed-inner-14.png
