EwoudVV/calculator/images/routing-back.jpg

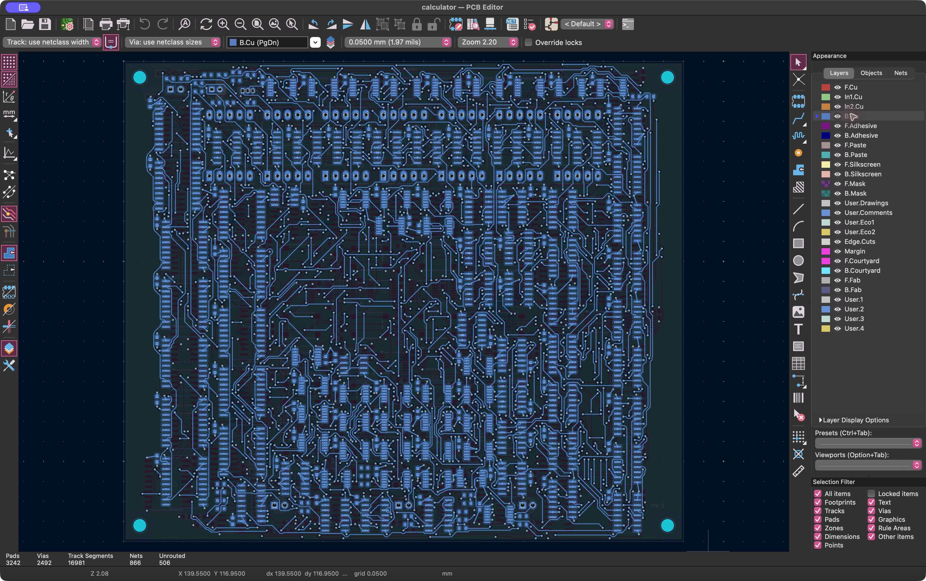
images/routing-back.jpg
