EwoudVV/calculator/images/routing-front.jpg

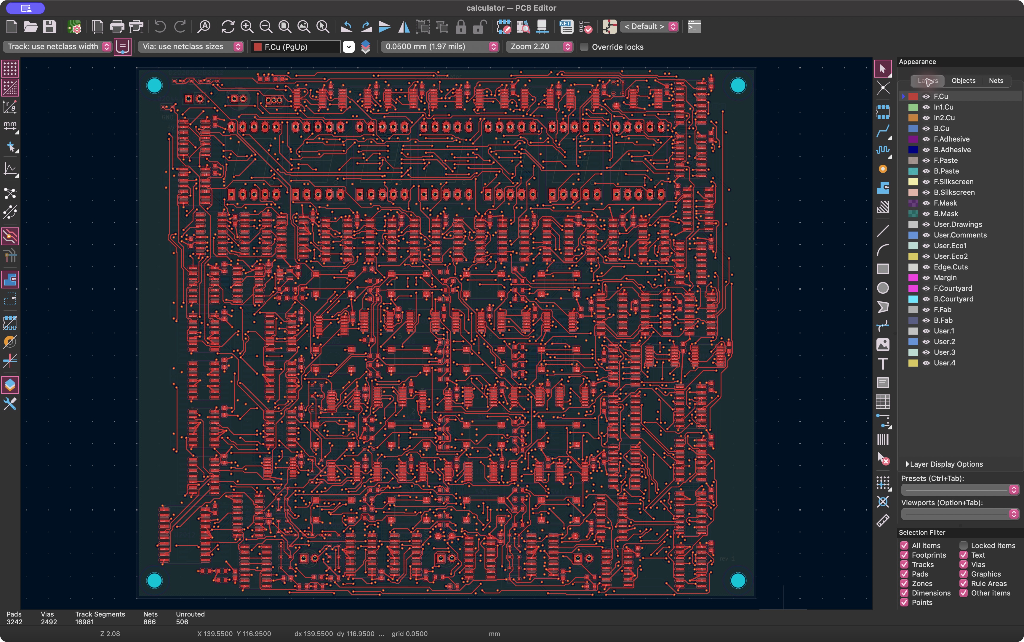
images/routing-front.jpg
