EwoudVV/calculator/images/sequencer-counters.png

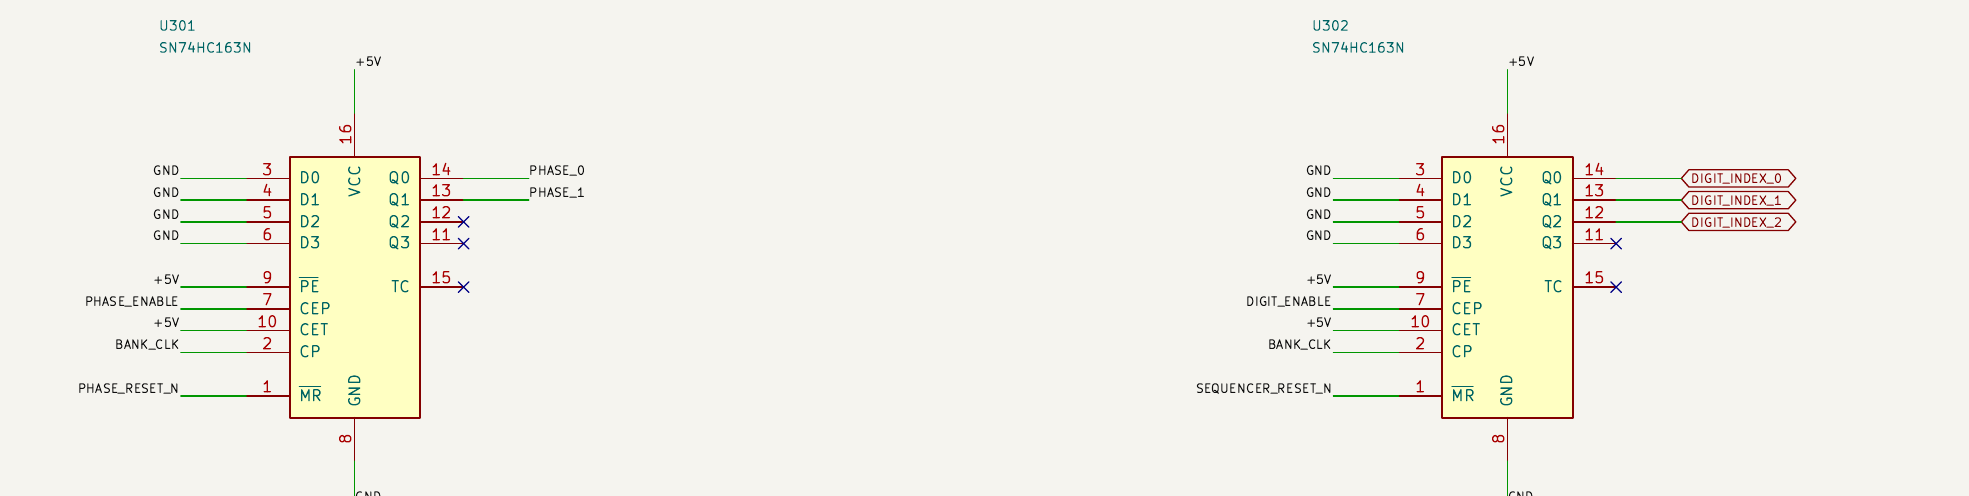
images/sequencer-counters.png
