EwoudVV/calculator/images/shared-decimal-adder.png

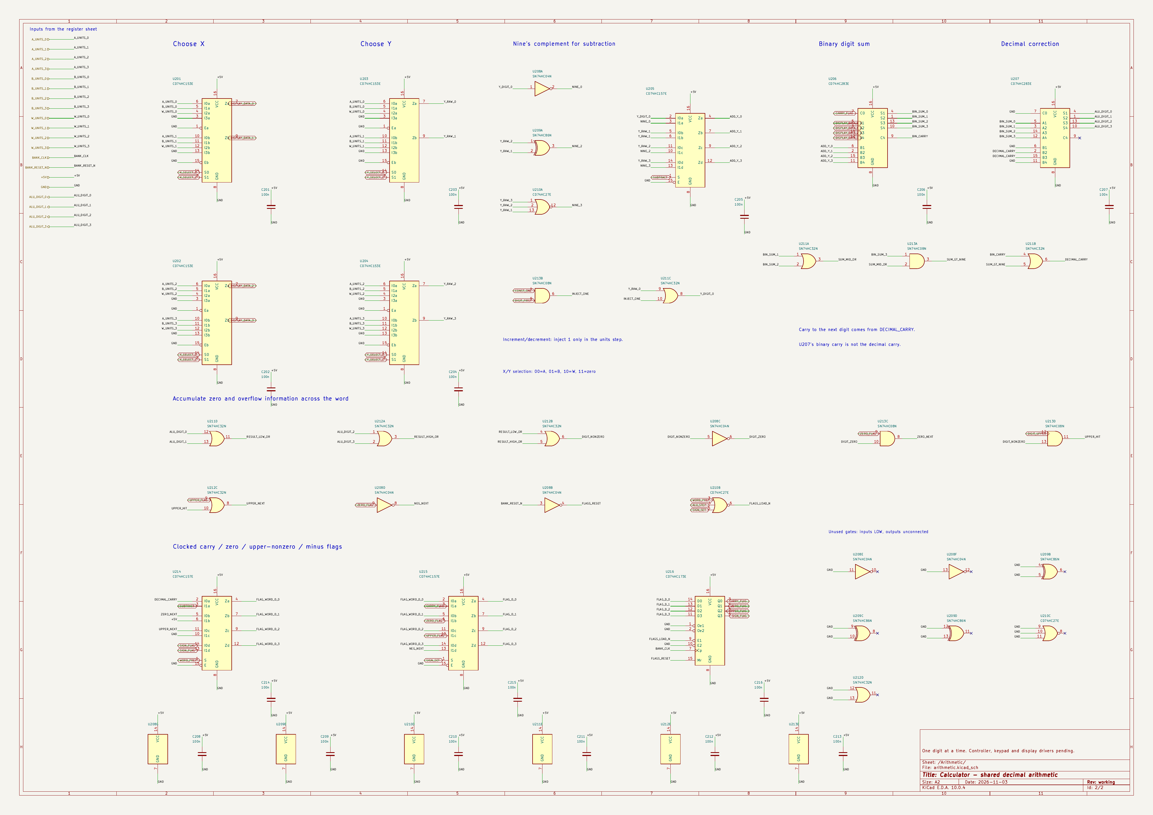
images/shared-decimal-adder.png
