EwoudVV/calculator/images/word-sequencer.png

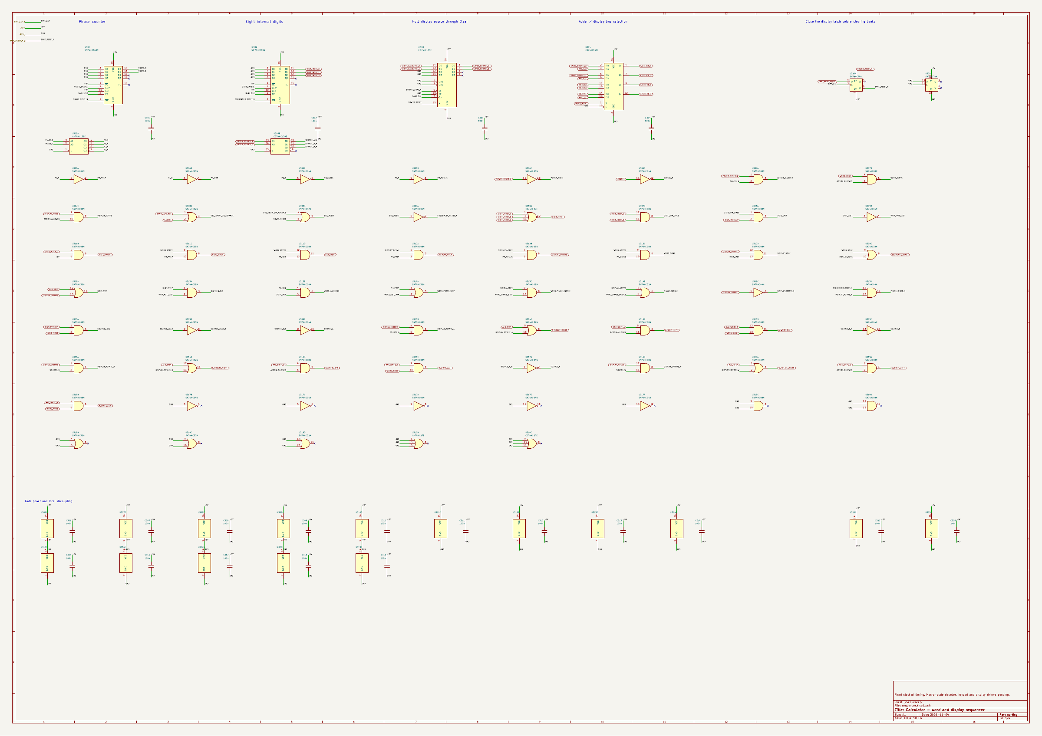
images/word-sequencer.png
