EwoudVV/calculator/pcb-bom.csv

value | quantity | references | footprint | listing_order_qty | listing_unit_usd | listing_line_usd | source
100k 1% | 2 | R2057 R2058 | Resistor_SMD:R_0603_1608Metric
100n | 168 | C101 C102 C103 C104 C105 C106 C107 C108 C109 C110 C111 C112 C113 C114 C115 C121 C122 C201 C202 C203 C204 C205 C206 C207 C208 C209 C210 C211 C212 C213 C214 C215 C216 C301 C302 C303 C304 C305 C306 C307 C308 C309 C310 C311 C312 C313 C314 C315 C316 C317 C318 C319 C320 C401 C402 C403 C404 C405 C406 C407 C408 C409 C501 C502 C503 C504 C505 C506 C507 C508 C509 C510 C1001 C1002 C1003 C1004 C1005 C1006 C1007 C1008 C1009 C1010 C1011 C1012 C1024 C1025 C1027 C1028 C1029 C1030 C1031 C1032 C1033 C1034 C1013 C1014 C1035 C1036 C1037 C1038 C1039 C1040 C1041 C1015 C1016 C1017 C1018 C1026 C1042 C1043 C1044 C1045 C1046 C1047 C1048 C1049 C1050 C1051 C901 C902 C903 C1019 C1020 C1021 C1022 C1023 C2000 C2001 C2002 C2003 C2004 C2010 C2011 C2012 C2013 C2014 C2015 C2016 C2017 C2018 C2201 C2202 C2203 C2204 C2205 C2206 C2207 C2208 C2209 C2210 C2211 C2212 C2213 C2214 C2215 C2216 C2217 C2218 C2219 C2220 C2221 C2222 C2050 C2051 C2052 C2053 C2054 C2055 | Capacitor_SMD:C_0603_1608Metric
10k | 6 | R2052 R2053 R2054 R2055 R2063 R2064 | Resistor_SMD:R_0603_1608Metric
10k 1% | 2 | R2060 R2061 | Resistor_SMD:R_0603_1608Metric
10n | 1 | C2091 | Capacitor_SMD:C_0603_1608Metric
12k 1% | 1 | R2059 | Resistor_SMD:R_0603_1608Metric
1k | 47 | R2100 R2101 R2102 R2103 R2104 R2105 R2106 R2107 R2108 R2109 R2110 R2111 R2112 R2113 R2114 R2115 R2116 R2117 R2118 R2119 R2120 R2121 R2122 R2123 R2124 R2125 R2126 R2127 R2128 R2129 R2130 R2131 R2132 R2133 R2134 R2135 R2136 R2137 R2138 R2139 R2140 R2141 R2142 R2143 R2144 R2145 R2146 | Resistor_SMD:R_0603_1608Metric
1k 1% | 17 | R2021 R2023 R2025 R2027 R2029 R2031 R2033 R2035 R2037 R2039 R2041 R2043 R2045 R2047 R2049 R2051 R2056 | Resistor_SMD:R_0603_1608Metric
1n C0G | 1 | C2090 | Capacitor_SMD:C_0603_1608Metric
3.3k 1% | 16 | R2020 R2022 R2024 R2026 R2028 R2030 R2032 R2034 R2036 R2038 R2040 R2042 R2044 R2046 R2048 R2050 | Resistor_SMD:R_0603_1608Metric
4.99k | 2 | R2000 R2001 | Resistor_SMD:R_0603_1608Metric
47R | 1 | R2002 | Resistor_SMD:R_0603_1608Metric
47u 16V | 1 | C2092 | Capacitor_THT:CP_Radial_D5.0mm_P2.00mm
5V / GND | 1 | J101 | Connector_PinHeader_2.54mm:PinHeader_1x02_P2.54mm_Vertical
6.2k 1% | 1 | R2062 | Resistor_SMD:R_0603_1608Metric
BAT54HGWX | 32 | D2004 D2009 D2012 D2013 D2018 D2020 D2022 D2025 D2026 D2028 D2029 D2030 D2035 D2036 D2039 D2041 D2043 D2044 D2045 D2047 D2050 D2051 D2052 D2054 D2055 D2057 D2058 D2059 D2060 D2061 D2062 D2063 | Diode_SMD:D_SOD-323 |  |  |  | https://www.nexperia.com/product/BAT54HGW
CD74HC138M96 | 9 | U402 U503 U504 U505 U506 U507 U508 U509 U510 | Package_SO:SOIC-16_3.9x9.9mm_P1.27mm | 10 | 0.354 | 3.540 | https://www.digikey.com/en/products/detail/texas-instruments/CD74HC138M96/555779
CD74HC139M96 | 1 | U305 | Package_SO:SOIC-16_3.9x9.9mm_P1.27mm | 1 | 0.44 | 0.44 | https://www.digikey.com/en/products/detail/texas-instruments/CD74HC139M96/555753
CD74HC153M96 | 6 | U121 U122 U201 U202 U203 U204 | Package_SO:SOIC-16_3.9x9.9mm_P1.27mm | 6 | 0.86 | 5.16 | https://www.digikey.com/en/products/detail/texas-instruments/CD74HC153M96/3505015
CD74HC157M96 | 9 | U113 U114 U115 U205 U214 U215 U304 U403 U404 | Package_SO:SOIC-16_3.9x9.9mm_P1.27mm | 10 | 0.304 | 3.040 | https://www.digikey.com/en/products/detail/texas-instruments/CD74HC157M96/3505017
CD74HC173M96 | 5 | U216 U303 U903 U2017 U2018 | Package_SO:SOIC-16_3.9x9.9mm_P1.27mm | 5 | 0.67 | 3.35 | https://www.digikey.com/en/products/detail/texas-instruments/CD74HC173M96/3505021
CD74HC27M96 | 4 | U210 U310 U1011 U2209 | Package_SO:SOIC-14_3.9x8.7mm_P1.27mm | 4 | 0.35 | 1.40 | https://www.digikey.com/en/products/detail/texas-instruments/CD74HC27M96/2754248
CD74HC283M96 | 2 | U206 U207 | Package_SO:SOIC-16_3.9x9.9mm_P1.27mm | 2 | 0.71 | 1.42 | https://www.digikey.com/en/products/detail/texas-instruments/CD74HC283M96/3505037
CD74HC299M96 | 12 | U101 U102 U103 U104 U105 U106 U107 U108 U109 U110 U111 U112 | Package_SO:SOIC-20W_7.5x12.8mm_P1.27mm | 12 | 0.808 | 9.696 | https://www.digikey.com/en/products/detail/texas-instruments/CD74HC299M96/555541
CD74HC30M96 | 15 | U1024 U1025 U1033 U1034 U1035 U1037 U1038 U1039 U1041 U1026 U1042 U1043 U1047 U2205 U2208 | Package_SO:SOIC-14_3.9x8.7mm_P1.27mm | 15 | 0.453 | 6.795 | https://www.digikey.com/en/products/detail/texas-instruments/CD74HC30M96/555806
CD74HC4511M96 | 6 | U2050 U2051 U2052 U2053 U2054 U2055 | Package_SO:SOIC-16_3.9x9.9mm_P1.27mm | 6 | 1.03 | 6.18 | https://www.digikey.com/en/products/detail/texas-instruments/CD74HC4511M96/1507302
FJ5161AH | 7 | DS1 DS2 DS3 DS4 DS5 DS6 DS7 | Display_7Segment:7SegmentLED_LTS6760_LTS6780 |  |  |  | https://www.lcsc.com/product-detail/C8093.html
LM393BDR | 1 | U2003 | Package_SO:SOIC-8_3.9x4.9mm_P1.27mm |  |  |  | https://www.ti.com/product/LM393B
MCP100-450DI/TO | 1 | U2002 | Package_TO_SOT_THT:TO-92_Inline |  |  |  | https://www.digikey.com/en/products/detail/microchip-technology/MCP100-450DI-TO/275215
PTS645SM43SMTR92 LFS | 16 | SW1 SW2 SW3 SW4 SW5 SW6 SW7 SW8 SW9 SW10 SW11 SW12 SW13 SW14 SW15 SW16 | Button_Switch_SMD:SW_SPST_PTS645Sx43SMTR92 | 16 | 0.313 | 5.008 | https://www.digikey.com/en/products/detail/c-k/PTS645SM43SMTR92-LFS/1146840
Red 3mm | 3 | D2200 D2201 D2202 | LED_THT:LED_D3.0mm
SN74HC00PWR | 6 | U1005 U1006 U1030 U1045 U1050 U2222 | Package_SO:TSSOP-14_4.4x5mm_P0.65mm | 6 | 0.42 | 2.52 | https://www.digikey.com/en/products/detail/texas-instruments/SN74HC00PWR/377066
SN74HC04PWR | 22 | U208 U306 U309 U317 U401 U405 U406 U1001 U1004 U1023 U1028 U1036 U1016 U1048 U1051 U1020 U2201 U2206 U2210 U2215 U2218 U2221 | Package_SO:TSSOP-14_4.4x5mm_P0.65mm | 22 | 0.321 | 7.062 | https://www.digikey.com/en/products/detail/texas-instruments/SN74HC04PWR/376665
SN74HC08PWR | 19 | U213 U307 U311 U312 U313 U315 U316 U319 U408 U409 U1002 U1032 U1013 U1015 U1018 U1019 U2204 U2213 U2217 | Package_SO:TSSOP-14_4.4x5mm_P0.65mm | 19 | 0.353 | 6.707 | https://www.digikey.com/en/products/detail/texas-instruments/SN74HC08PWR/377030
SN74HC10DR | 7 | U1017 U1040 U1049 U2203 U2211 U2216 U2219 | Package_SO:SOIC-14_3.9x8.7mm_P1.27mm | 10 | 0.283 | 2.830 | https://www.digikey.com/en/products/detail/texas-instruments/SN74HC10DR/562728
SN74HC14DR | 1 | U2004 | Package_SO:SOIC-14_3.9x8.7mm_P1.27mm |  |  |  | https://www.ti.com/product/SN74HC14/part-details/SN74HC14DR
SN74HC163DR | 7 | U301 U302 U501 U502 U901 U902 U2016 | Package_SO:SOIC-16_3.9x9.9mm_P1.27mm | 10 | 0.348 | 3.480 | https://www.digikey.com/en/products/detail/texas-instruments/SN74HC163DR/1570729
SN74HC174DR | 3 | U407 U2010 U2011 | Package_SO:SOIC-16_3.9x9.9mm_P1.27mm | 3 | 0.6 | 1.8 | https://www.digikey.com/en/products/detail/texas-instruments/SN74HC174DR/276463
SN74HC20DR | 6 | U1027 U1029 U1031 U1044 U1046 U2212 | Package_SO:SOIC-14_3.9x8.7mm_P1.27mm | 6 | 0.43 | 2.58 | https://www.digikey.com/en/products/detail/texas-instruments/SN74HC20DR/377013
SN74HC32PWR | 18 | U211 U212 U308 U314 U318 U1003 U1007 U1008 U1009 U1010 U1012 U1014 U1021 U1022 U2202 U2207 U2214 U2220 | Package_SO:TSSOP-14_4.4x5mm_P0.65mm | 18 | 0.27 | 4.86 | https://www.digikey.com/en/products/detail/texas-instruments/SN74HC32PWR/376656
SN74HC4040DR | 1 | U2013 | Package_SO:SOIC-16_3.9x9.9mm_P1.27mm | 1 | 0.72 | 0.72 | https://www.digikey.com/en/products/detail/texas-instruments/SN74HC4040DR/562923
SN74HC688DWR | 1 | U2012 | Package_SO:SOIC-20W_7.5x12.8mm_P1.27mm | 1 | 1.04 | 1.04 | https://www.digikey.com/en/products/base-product/texas-instruments/296/74HC688/692
SN74HC74DR | 3 | U320 U2014 U2015 | Package_SO:SOIC-14_3.9x8.7mm_P1.27mm | 3 | 0.49 | 1.47 | https://www.digikey.com/en/products/detail/texas-instruments/SN74HC74DR/276847
SN74HC86DR | 1 | U209 | Package_SO:SOIC-14_3.9x8.7mm_P1.27mm | 1 | 0.42 | 0.42 | https://www.digikey.com/en/products/detail/texas-instruments/SN74HC86DR/562916
SN74LVC1G125DBVR | 1 | U2001 | Package_TO_SOT_SMD:SOT-23-5 |  |  |  | https://www.lcsc.com/product-detail/C23654.html
TLC555IDR | 1 | U2000 | Package_SO:SOIC-8_3.9x4.9mm_P1.27mm | 1 | 0.95 | 0.95 | https://www.digikey.com/en/products/detail/texas-instruments/TLC555IDR/276605
