EwoudVV/calculator/parts-estimate.csv

part | drawn | known_total | suggested_order_qty | listed_IC_cost_USD | source
CD4511BE | 0 | 6 | 6 | 6.24 | https://www.digikey.com/en/products/detail/texas-instruments/CD4511BE/67341
CD74HC138E | 9 | 9 | 10 | 9.420 | https://www.digikey.com/en/products/detail/texas-instruments/CD74HC138E/475905
CD74HC139E | 1 | 2 | 2 | 2.12 | https://www.digikey.com/en/products/detail/texas-instruments/CD74HC139E/1506637
CD74HC151E | 0 | 1 | 1 | 1.07 | https://www.digikey.com/en/products/detail/texas-instruments/CD74HC151E/1506669
CD74HC153E | 6 | 6 | 6 | 7.56 | https://www.digikey.com/en/products/detail/texas-instruments/CD74HC153E/1506676
CD74HC157E | 9 | 9 | 10 | 7.470 | https://www.digikey.com/en/products/detail/texas-instruments/CD74HC157E/1506689
CD74HC173E | 3 | 8 | 10 | 9.130 | https://www.digikey.com/en/products/detail/texas-instruments/CD74HC173E/1506733
CD74HC27E | 3 | 3 | 3 | 2.73 | https://www.digikey.com/en/products/detail/texas-instruments/CD74HC27E/475929
CD74HC283E | 2 | 2 | 2 | 2.82 | https://www.digikey.com/en/products/detail/texas-instruments/CD74HC283E/555829
CD74HC299E | 12 | 12 | 12 | 12.36 | https://www.mouser.com/en/c/semiconductors/?mounting+style=Through+Hole&output+type=3-State
CD74HC30E | 13 | 13 | 13 | 9.334 | https://www.mouser.com/ProductDetail/Texas-Instruments/CD74HC30E?qs=tJ5HNKWh3OVq%2F4Pt68gHgg%3D%3D
CD74HC85E | 0 | 1 | 1 | 1.43 | https://www.digikey.com/en/products/detail/texas-instruments/CD74HC85E/475950
SN74HC00N | 5 | 5 | 5 | 3.90 | https://www.digikey.com/en/products/detail/texas-instruments/SN74HC00N/277209
SN74HC04N | 16 | 16 | 16 | 8.736 | https://www.digikey.com/en/products/detail/texas-instruments/SN74HC04N/277212
SN74HC08N | 16 | 16 | 16 | 8.992 | https://www.digikey.com/en/products/detail/texas-instruments/SN74HC08N/296-1570-5-ND/277216
SN74HC10N | 3 | 3 | 3 | 2.52 | https://www.digikey.com/en/products/detail/texas-instruments/SN74HC10N/376902
SN74HC14N | 0 | 1 | 1 | 1.15 | https://www.digikey.com/en/products/detail/texas-instruments/SN74HC14N/296-1577-5-ND/277223
SN74HC163N | 6 | 11 | 11 | 10.131 | https://www.digikey.com/en/products/detail/texas-instruments/SN74HC163N/376948
SN74HC174N | 1 | 1 | 1 | 1.81 | https://www.digikey.com/en/products/detail/texas-instruments/SN74HC174N/277225
SN74HC20N | 5 | 5 | 5 | 3.45 | https://www.digikey.com/en/products/detail/texas-instruments/SN74HC20N/476048
SN74HC244N | 0 | 1 | 1 | 1.04 | https://www.digikey.com/en/products/detail/texas-instruments/SN74HC244N/277228
SN74HC32N | 14 | 14 | 14 | 6.958 | https://www.newark.com/texas-instruments/sn74hc32n/ic-quad-2-input-or-74hc32-dip14/dp/33AH4865
SN74HC74N | 1 | 2 | 2 | 2.26 | https://www.digikey.com/en/products/detail/texas-instruments/SN74HC74N/277248
SN74HC86N | 1 | 1 | 1 | 1.2 | https://www.digikey.com/en/products/detail/texas-instruments/SN74HC86N/376842
