EwoudVV/calculator/BUILD.md

# pcb build

the calculator is going on one 140 by 120 mm board. there are four copper layers. the inner layers have 5V and ground pours with some signal traces. the keys and display are on the front. the surface mount parts use both sides.

J101 takes regulated 5V. pin 1 is 5V and pin 2 is ground. TP1 and TP2 are the supply test points, TP3 is the clock, and TP4 is power-on reset. the clock is about 96 kHz. the displays and power connector are through-hole.

[pcb-bom.csv](pcb-bom.csv) lists the parts on the board. the prices filled in so far add up to $82.47. that leaves the other parts, the board, assembly, shipping and tax to price. the total target is still $100.

the full schematic passed the KiCad error check. i tested 188 calculations from key samples through the display latches. that included rounding, negative results, overflow and divide-by-zero. i also ran the key timer for a complete calculation and Clear.

the 5V, ground, clock, power-on reset and Clear nets are connected. i routed more of the keypad, display and control signals using 0.16 mm traces and 0.55 mm vias with 0.30 mm drills where space was tight. i added short links to reconnect parts of the power planes that the new traces cut off.

KiCad shows 426 open connections, down from 506 before this pass. the board matches the schematic. the copper check found two sliver warnings, and there is still signal routing left before ordering.

[parts-estimate.csv](parts-estimate.csv) is the earlier breadboard price check.
