EwoudVV/calculator/JOURNAL.md

# Calculator: devlog

<!-- Generated by Half Life from project am6hqneuxp7wtbwjeo4x3zg8. Edits here are overwritten on the next sync. -->
<!-- Generated: 2026-11-08T16:45:53.178Z -->

> [!NOTE]
> This devlog is mirrored from [Half Life](https://halflife.hackclub.com) ([open the project](https://halflife.hackclub.com/projects/am6hqneuxp7wtbwjeo4x3zg8)). Editing it here will not change the platform's copy, and the next sync overwrites this file.

> a breadboard calculator made from logic chips, with no microcontroller. it will do addition, subtraction, multiplication and division, with four-digit whole-number inputs and a six-digit display for division to two decimal places. i'm planning to reuse the breadboards and 5V supply from my Ben Eater computer and make a printed front panel for the buttons and display.

| Week | Tier | Hours logged | Entries |
| --- | --- | --- | --- |
| Week 5 | Tier 3 | 62h | 9 |

## Contents

1. [2026-11-02: ## Planning the calculator](#2026-11-02-planning-the-calculator)
2. [2026-11-02: ## Drew the number registers](#2026-11-02-drew-the-number-registers)
3. [2026-11-03: ## Drew the shared decimal adder](#2026-11-03-drew-the-shared-decimal-adder)
4. [2026-11-04: ## Drew the digit sequencer](#2026-11-04-drew-the-digit-sequencer)
5. [2026-11-04: ## Drew the main controller](#2026-11-04-drew-the-main-controller)
6. [2026-11-05: ## Moved the calculator to a PCB](#2026-11-05-moved-the-calculator-to-a-pcb)
7. [2026-11-06: ## Routed power and control on the PCB](#2026-11-06-routed-power-and-control-on-the-pcb)
8. [2026-11-08: ## Finished routing the PCB](#2026-11-08-finished-routing-the-pcb)
9. [2026-11-08: ## Priced the parts and posted progress reels](#2026-11-08-priced-the-parts-and-posted-progress-reels)

## Design

### 2026-11-02: ## Planning the calculator

**2h**

## Planning the calculator

i’m making a breadboard calculator from logic chips, with no microcontroller or firmware. it will take whole-number inputs from 0 to 9999 and do addition, subtraction, multiplication and division. division results will show two decimal places.

i worked through an arithmetic plan using three number registers and one shared decimal adder. multiplication reuses addition, and division works through the digits like long division. i checked those arithmetic steps in a Python simulation and started looking at parts.

i’ll reuse my Ben Eater breadboards and 5V supply, with a printed front panel for the buttons and display. the controller, complete parts cost and actual schematic still need working out.

project-created

devlog-01-plan

### 2026-11-02: ## Drew the number registers

**5h**

## Drew the number registers

i drew the number-storage section in KiCad. A holds the first number, B holds the second, and W holds the working result. the chips can store and shift digits, which removes some extra selector circuitry.

i connected the keypad, arithmetic and display in the control simulation. it now takes button presses through to a displayed answer. i checked held and bouncing keys, rejecting a fifth digit, arithmetic errors and starting another calculation after a result.

Clear exposed a display timing problem: the digit data could change while a display latch was closing. i changed the sequence to close the latch, hold the data, then reset the registers.

the storage schematic includes the selectors, decoupling capacitors and power connection. its exported connections match the intended wiring. the arithmetic unit, controller gates and display circuit still need drawing. nothing has been built yet.

number-registers

number-register-bank

register-feedback-selector

digit-input-selectors

register-bit-lane

### 2026-11-03: ## Drew the shared decimal adder

**4h**

## Drew the shared decimal adder

i drew the arithmetic section and connected it to the three number registers. two HC283 adders handle the binary sum and decimal correction. for 9+9, the circuit stores 8 in the current digit and carries 1 into the next.

subtraction uses the same adder by selecting the nine’s complement of the second digit and starting with carry set to 1. i added a register to keep the carry and track zero, negative results and numbers that are too large.

i checked the arithmetic using KiCad’s exported connections, including carries across digits, negative subtraction and Clear/reset. these checks use simulated control signals. the controller, keypad and display-driver circuits still need drawing, and nothing has been built yet.

shared-decimal-adder

decimal-adder-detail

arithmetic-flags

registers-linked

### 2026-11-04: ## Drew the digit sequencer

**6h**

## Drew the digit sequencer

i drew the timing section that moves the calculator through each digit. two counters track the current step and digit position, so the adder gets eight digit steps before the controller moves on.

i added the display latch controls too. they select one display position, let it take the digit, then close it before the number register shifts. whole-number results leave the two decimal positions blank, while division uses all six.

connecting the gates exposed another Clear timing problem. resetting straight from the controller state could clear the number registers as a display latch closed. i added a flip-flop to delay reset by one clock and keep the digit data steady.

i checked the exported circuit through calculations, clearing partway through and starting again. the main state decoder, keypad electronics, display drivers, clock source and power-on reset circuit still need drawing. nothing has been built yet.

sequencer-counters

display-latch-register

clocked-bank-reset

display-transfer

word-sequencer

registers-linked

### 2026-11-04: ## Drew the main controller

**5h**

## Drew the main controller

i drew the main controller that chooses what happens next. it waits for each eight-digit pass to finish, then uses carry, zero and overflow flags to choose the next step.

multiplication loops through addition under that control circuit. division has counters for the quotient digit and current position, with branches to subtract, restore the remainder and round the answer. i also drew the display-format and error registers.

i checked the controller using KiCad's exported connections, including full calculations, Clear partway through and starting again. the tests supply accepted keypad commands, and the drawn gates run the sequence after that.

the keypad scanner, entry controls, display drivers, clock and power-on reset still need drawing. the design has grown a lot, so i need to check the full parts cost and breadboard space before building it.

main-state-counters

arithmetic-branch-gates

division-counters-status

controller-outputs

main-controller

### 2026-11-05: ## Moved the calculator to a PCB

**8h**

## Moved the calculator to a PCB

the breadboard version was going to take too long to wire, so i switched to a pcb. i picked surface mount versions of the logic chips and added the keypad circuit, display drivers, clock and power-on reset to the schematic.

the board is 140 x 120 mm. the buttons and display are on the front, and i put parts on both sides to fit the circuit. i placed all the parts and started connecting them to 5v and ground on the inner layers.

i ran 188 calculations in the circuit simulation with the new keypad logic and display latches. i checked negative results, division rounding and Clear. i still need to finish the routing and price out the full build before ordering a board.

pcb-front

pcb-back

power-and-clock

keypad

key-control

display-drivers

ground-plane

5v-plane

### 2026-11-06: ## Routed power and control on the PCB

**15h**

## Routed power and control on the PCB

i finished connecting 5V and ground across the board and routed the clock, power-on reset and Clear. the clock reaches the registers and control logic, and the reset and Clear signals reach the circuits they need to reset.

i also routed a lot of the signals between chips. some traces run on the inner layers alongside the power and ground pours. KiCad went from 1,319 open connections to 506.

the board still matches the schematic. KiCad flagged two spots where the copper pour gets very narrow. i still have signal traces left to route before i can order the board.

front copper in KiCad

back copper in KiCad

inner ground plane

inner 5V plane and traces

5V connections

ground connections

bank clock route

power-on reset route

Clear route

display latch route

display data route

controller branch route

keypad sense route

keypad code route

adder output route

### 2026-11-08: ## Finished routing the PCB

**15h**

## Finished routing the PCB

i kept routing signals on the 4-layer board, using 0.16 mm traces and smaller vias where space was tight. i added short links where new traces cut the power planes apart. KiCad went from 506 open connections to 426, but the middle of the board was full.

i checked how much wiring the board needs against how much it can fit. the chips for each section are spread across the whole board, so most signals have to cross the middle. it needs about twice what 4 layers can hold, and even 6 layers left 301 connections unrouted.

i moved to a 16-layer board with finer rules: 0.105 mm spacing, 0.11 mm traces and 0.45 mm vias with 0.2 mm holes. the autorouter connected everything, and i cleaned up 172 leftover traces and vias that didn't connect to anything.

KiCad now shows 0 open connections and no errors, and the board still matches the schematic. 5 small warnings are left: silkscreen overlaps and one copper sliver. i also worked out calculation times at a 96 kHz clock. addition takes 0.45 ms and 99 × 99 takes 23 ms.

16 layers will cost a lot more than my budget, so i need a quote and to check the manufacturer can make the finer spacing before ordering. grouping each section's chips closer together could get it back to fewer layers.

3D view of the front

3D view of the back

front copper

back copper

inner layer 1, ground

inner layer 2

inner layer 3

inner layer 4

inner layer 5

inner layer 6, 5V

inner layer 7

inner layer 8

inner layer 9

inner layer 10

inner layer 11

inner layer 12

inner layer 13

inner layer 14

### 2026-11-08: ## Priced the parts and posted progress reels

**2h**

## Priced the parts and posted progress reels

i added every part from the schematic to the parts list on Half Life. most prices came from my DigiKey list. for the parts it was missing i used LCSC and Mouser. the LM393BDR isn't sold anywhere, so i listed the LM393BIDR, which is TI's orderable name for the same comparator. the displays only come in packs of 5, so i listed 10 to get the 7 i need.

the resistors, capacitors, LEDs and power header are one combined line for $6.58. the 10 nF and 1 nF capacitors and the 47 µF capacitor are rough estimates. the parts come to $99.12 of the $100 budget, which leaves nothing for the 16-layer board or shipping.

i also found that the Half Life sync had overwritten JOURNAL.md in the repo, so my last entry only showed up there and not on the site. i posted it on the site instead.

i made the 35h and 45h progress reels the same way as my earlier ones, with three slides each. the 35h reel covers the finished routing and why it needed 16 layers. the 45h reel covers the front of the board, the power planes and the parts cost.

next i need a quote for the 16-layer board. with the budget already spent on parts, i might need to move parts around to get back to fewer layers.

parts list on Half Life

parts total, $99.12 of $100
