EwoudVV/calculator/calculator.kicad_pcb

## KiCad design calculator.kicad_pcb (2026-11-08)

Schematic: calculator.kicad_sch, Calculator - number registers

Parts:
C101, C102, C103, C104, C105, C106, C107, C108, C109, C110, C111, C112, C113, C114, C115, C121, C122: 100n; C_0603_1608Metric
J101: 5V / GND; PinHeader_1x02_P2.54mm_Vertical
U101, U102, U103, U104, U105, U106, U107, U108, U109, U110, U111, U112: CD74HC299M96; SOIC-20W_7.5x12.8mm_P1.27mm
U113, U114, U115: CD74HC157M96; SOIC-16_3.9x9.9mm_P1.27mm
U121, U122: CD74HC153M96; SOIC-16_3.9x9.9mm_P1.27mm

Connections:
+5V: C101.1, C102.1, C103.1, C104.1, C105.1, C106.1, C107.1, C108.1, C109.1, C110.1, C111.1, C112.1, C113.1, C114.1, C115.1, C121.1, C122.1, J101.1, U101.20 (VCC), U102.20 (VCC), U103.20 (VCC), U104.20 (VCC), U105.20 (VCC), U106.20 (VCC), U107.20 (VCC), U108.20 (VCC), U109.20 (VCC), U110.20 (VCC), U111.20 (VCC), U112.20 (VCC), U113.16 (VCC), U114.16 (VCC), U115.16 (VCC), U121.16 (VCC), U122.16 (VCC); also elsewhere on the board
/ALU_DIGIT_0: U113.3 (I1a), U114.3 (I1a), U115.3 (I1a); also elsewhere on the board
/ALU_DIGIT_1: U113.6 (I1b), U114.6 (I1b), U115.6 (I1b); also elsewhere on the board
/ALU_DIGIT_2: U113.10 (I1c), U114.10 (I1c), U115.10 (I1c); also elsewhere on the board
/ALU_DIGIT_3: U113.13 (I1d), U114.13 (I1d), U115.13 (I1d); also elsewhere on the board
/A_SERIAL_RIGHT_0: U101.11 (Ds0), U113.4 (Za)
/A_SERIAL_RIGHT_1: U102.11 (Ds0), U113.7 (Zb)
/A_SERIAL_RIGHT_2: U103.11 (Ds0), U113.9 (Zc)
/A_SERIAL_RIGHT_3: U104.11 (Ds0), U113.12 (Zd)
/A_TOP_0: U101.8 (Q0), U121.3 (I3a)
/A_TOP_1: U102.8 (Q0), U121.13 (I3b)
/A_TOP_2: U103.8 (Q0), U122.3 (I3a)
/A_TOP_3: U104.8 (Q0), U122.13 (I3b)
/A_UNITS_0: U101.17 (Q7), U113.2 (I0a); also elsewhere on the board
/A_UNITS_1: U102.17 (Q7), U113.5 (I0b); also elsewhere on the board
/A_UNITS_2: U103.17 (Q7), U113.11 (I0c); also elsewhere on the board
/A_UNITS_3: U104.17 (Q7), U113.14 (I0d); also elsewhere on the board
/BANK_RESET_N: U101.9 (Mr), U102.9 (Mr), U103.9 (Mr), U104.9 (Mr), U105.9 (Mr), U106.9 (Mr), U107.9 (Mr), U108.9 (Mr), U109.9 (Mr), U110.9 (Mr), U111.9 (Mr), U112.9 (Mr); also elsewhere on the board
/B_SERIAL_RIGHT_0: U105.11 (Ds0), U114.4 (Za)
/B_SERIAL_RIGHT_1: U106.11 (Ds0), U114.7 (Zb)
/B_SERIAL_RIGHT_2: U107.11 (Ds0), U114.9 (Zc)
/B_SERIAL_RIGHT_3: U108.11 (Ds0), U114.12 (Zd)
/B_TOP_0: U105.8 (Q0)
/B_TOP_1: U106.8 (Q0)
/B_TOP_2: U107.8 (Q0)
/B_TOP_3: U108.8 (Q0)
/B_UNITS_0: U105.17 (Q7), U114.2 (I0a); also elsewhere on the board
/B_UNITS_1: U106.17 (Q7), U114.5 (I0b); also elsewhere on the board
/B_UNITS_2: U107.17 (Q7), U114.11 (I0c); also elsewhere on the board
/B_UNITS_3: U108.17 (Q7), U114.14 (I0d); also elsewhere on the board
/LEFT_LOAD_0: U101.18 (Ds7), U105.18 (Ds7), U109.18 (Ds7), U121.7 (Za)
/LEFT_LOAD_1: U102.18 (Ds7), U106.18 (Ds7), U110.18 (Ds7), U121.9 (Zb)
/LEFT_LOAD_2: U103.18 (Ds7), U107.18 (Ds7), U111.18 (Ds7), U122.7 (Za)
/LEFT_LOAD_3: U104.18 (Ds7), U108.18 (Ds7), U112.18 (Ds7), U122.9 (Zb)
/W_SERIAL_RIGHT_0: U109.11 (Ds0), U115.4 (Za)
/W_SERIAL_RIGHT_1: U110.11 (Ds0), U115.7 (Zb)
/W_SERIAL_RIGHT_2: U111.11 (Ds0), U115.9 (Zc)
/W_SERIAL_RIGHT_3: U112.11 (Ds0), U115.12 (Zd)
/W_TOP_0: U109.8 (Q0)
/W_TOP_1: U110.8 (Q0)
/W_TOP_2: U111.8 (Q0)
/W_TOP_3: U112.8 (Q0)
/W_UNITS_0: U109.17 (Q7), U115.2 (I0a); also elsewhere on the board
/W_UNITS_1: U110.17 (Q7), U115.5 (I0b); also elsewhere on the board
/W_UNITS_2: U111.17 (Q7), U115.11 (I0c); also elsewhere on the board
/W_UNITS_3: U112.17 (Q7), U115.14 (I0d); also elsewhere on the board
A_ROTATE_RIGHT: U101.1 (S0), U102.1 (S0), U103.1 (S0), U104.1 (S0); also elsewhere on the board
A_SHIFT_LEFT: U101.19 (S1), U102.19 (S1), U103.19 (S1), U104.19 (S1); also elsewhere on the board
A_WRITE_ALU: U113.1 (S); also elsewhere on the board
BANK_CLK: U101.12 (Cp), U102.12 (Cp), U103.12 (Cp), U104.12 (Cp), U105.12 (Cp), U106.12 (Cp), U107.12 (Cp), U108.12 (Cp), U109.12 (Cp), U110.12 (Cp), U111.12 (Cp), U112.12 (Cp); also elsewhere on the board
B_ROTATE_RIGHT: U105.1 (S0), U106.1 (S0), U107.1 (S0), U108.1 (S0); also elsewhere on the board
B_SHIFT_LEFT: U105.19 (S1), U106.19 (S1), U107.19 (S1), U108.19 (S1); also elsewhere on the board
B_WRITE_ALU: U114.1 (S); also elsewhere on the board
GND: C101.2, C102.2, C103.2, C104.2, C105.2, C106.2, C107.2, C108.2, C109.2, C110.2, C111.2, C112.2, C113.2, C114.2, C115.2, C121.2, C122.2, J101.2, U101.2 (OE1), U101.3 (OE2), U101.10 (GND), U102.2 (OE1), U102.3 (OE2), U102.10 (GND), U103.2 (OE1), U103.3 (OE2), U103.10 (GND), U104.2 (OE1), U104.3 (OE2), U104.10 (GND), U105.2 (OE1), U105.3 (OE2), U105.10 (GND), U106.2 (OE1), U106.3 (OE2), U106.10 (GND), U107.2 (OE1), U107.3 (OE2), U107.10 (GND), U108.2 (OE1), U108.3 (OE2), U108.10 (GND), U109.2 (OE1), U109.3 (OE2), U109.10 (GND), U110.2 (OE1), U110.3 (OE2), U110.10 (GND), U111.2 (OE1), U111.3 (OE2), U111.10 (GND), U112.2 (OE1), U112.3 (OE2), U112.10 (GND), U113.8 (GND), U113.15 (E), U114.8 (GND), U114.15 (E), U115.8 (GND), U115.15 (E), U121.1 (Ea), U121.6 (I0a), U121.8 (GND), U121.10 (I0b), U121.15 (Eb), U122.1 (Ea), U122.6 (I0a), U122.8 (GND), U122.10 (I0b), U122.15 (Eb); also elsewhere on the board
KEY_DIGIT_0: U121.5 (I1a); also elsewhere on the board
KEY_DIGIT_1: U121.11 (I1b); also elsewhere on the board
KEY_DIGIT_2: U122.5 (I1a); also elsewhere on the board
KEY_DIGIT_3: U122.11 (I1b); also elsewhere on the board
LEFT_SELECT_0: U121.14 (S0), U122.14 (S0); also elsewhere on the board
LEFT_SELECT_1: U121.2 (S1), U122.2 (S1); also elsewhere on the board
QUOTIENT_DIGIT_0: U121.4 (I2a); also elsewhere on the board
QUOTIENT_DIGIT_1: U121.12 (I2b); also elsewhere on the board
QUOTIENT_DIGIT_2: U122.4 (I2a); also elsewhere on the board
QUOTIENT_DIGIT_3: U122.12 (I2b); also elsewhere on the board
W_ROTATE_RIGHT: U109.1 (S0), U110.1 (S0), U111.1 (S0), U112.1 (S0); also elsewhere on the board
W_SHIFT_LEFT: U109.19 (S1), U110.19 (S1), U111.19 (S1), U112.19 (S1); also elsewhere on the board
W_WRITE_ALU: U115.1 (S); also elsewhere on the board

Notes on the sheet:
A: first number
BCD bit 0
BCD bit 1
BCD bit 2
BCD bit 3
B: second number
W: working/result number
Shared digit for a left shift
Number registers. Shared arithmetic is on sheet 2.
S0,S1: 00 hold / 10 arithmetic rotate / 01 append a digit.
Unused parallel ports are outputs with OE1/OE2 LOW; no external load.
Parallel-load mode 11 must never be selected.

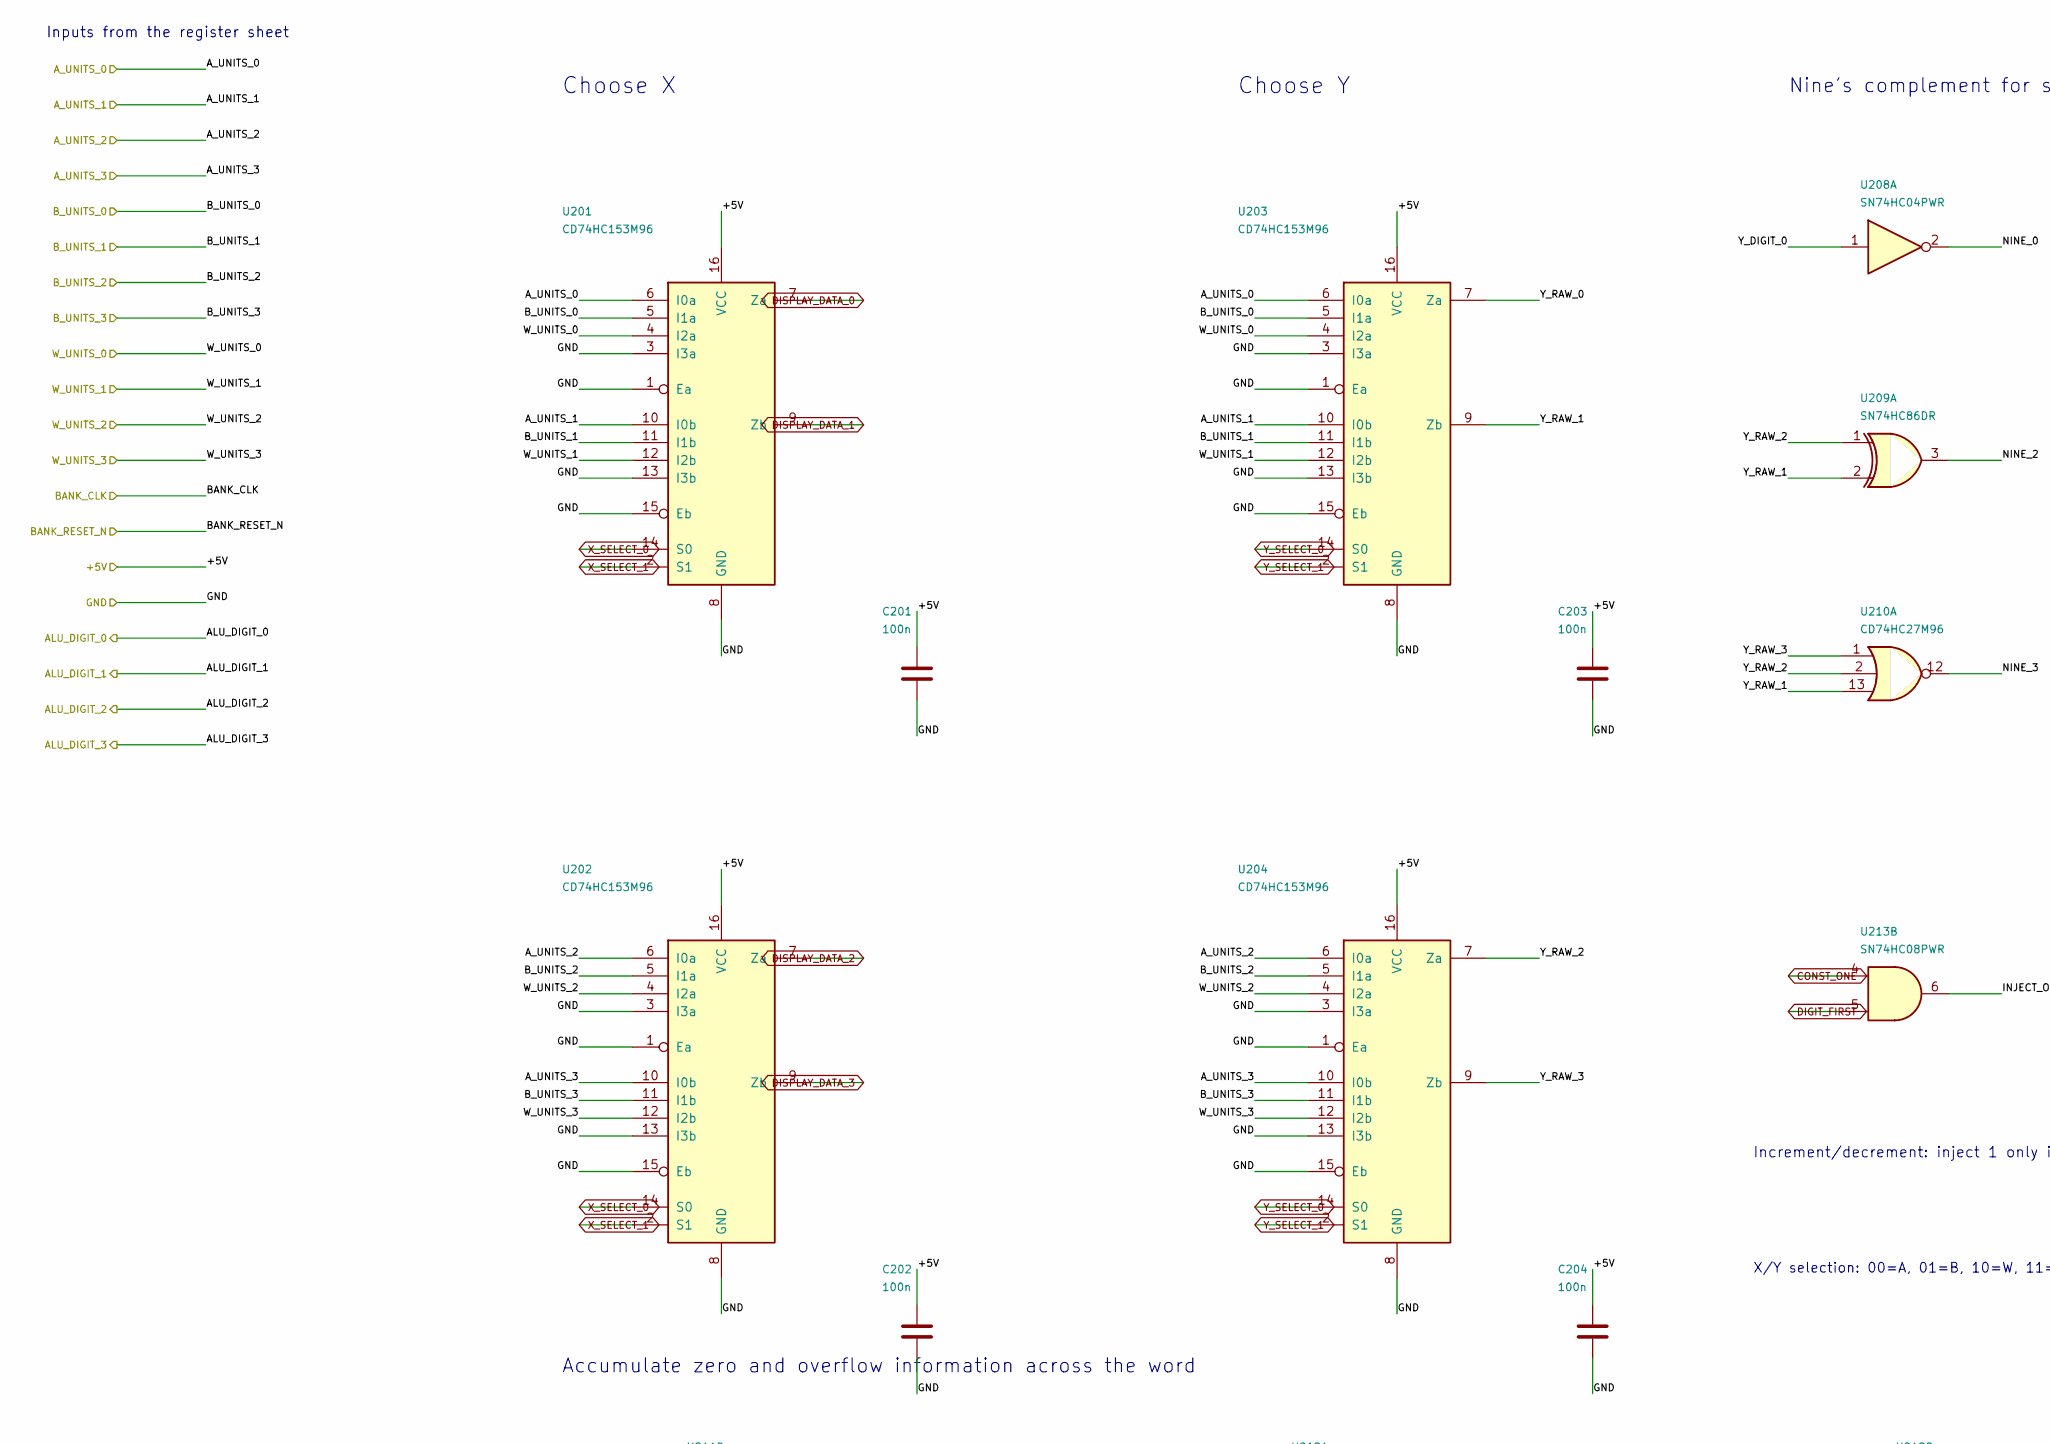
[picture p44: schematic arithmetic.kicad_sch, Calculator - shared decimal arithmetic, part in row 1, column 1]

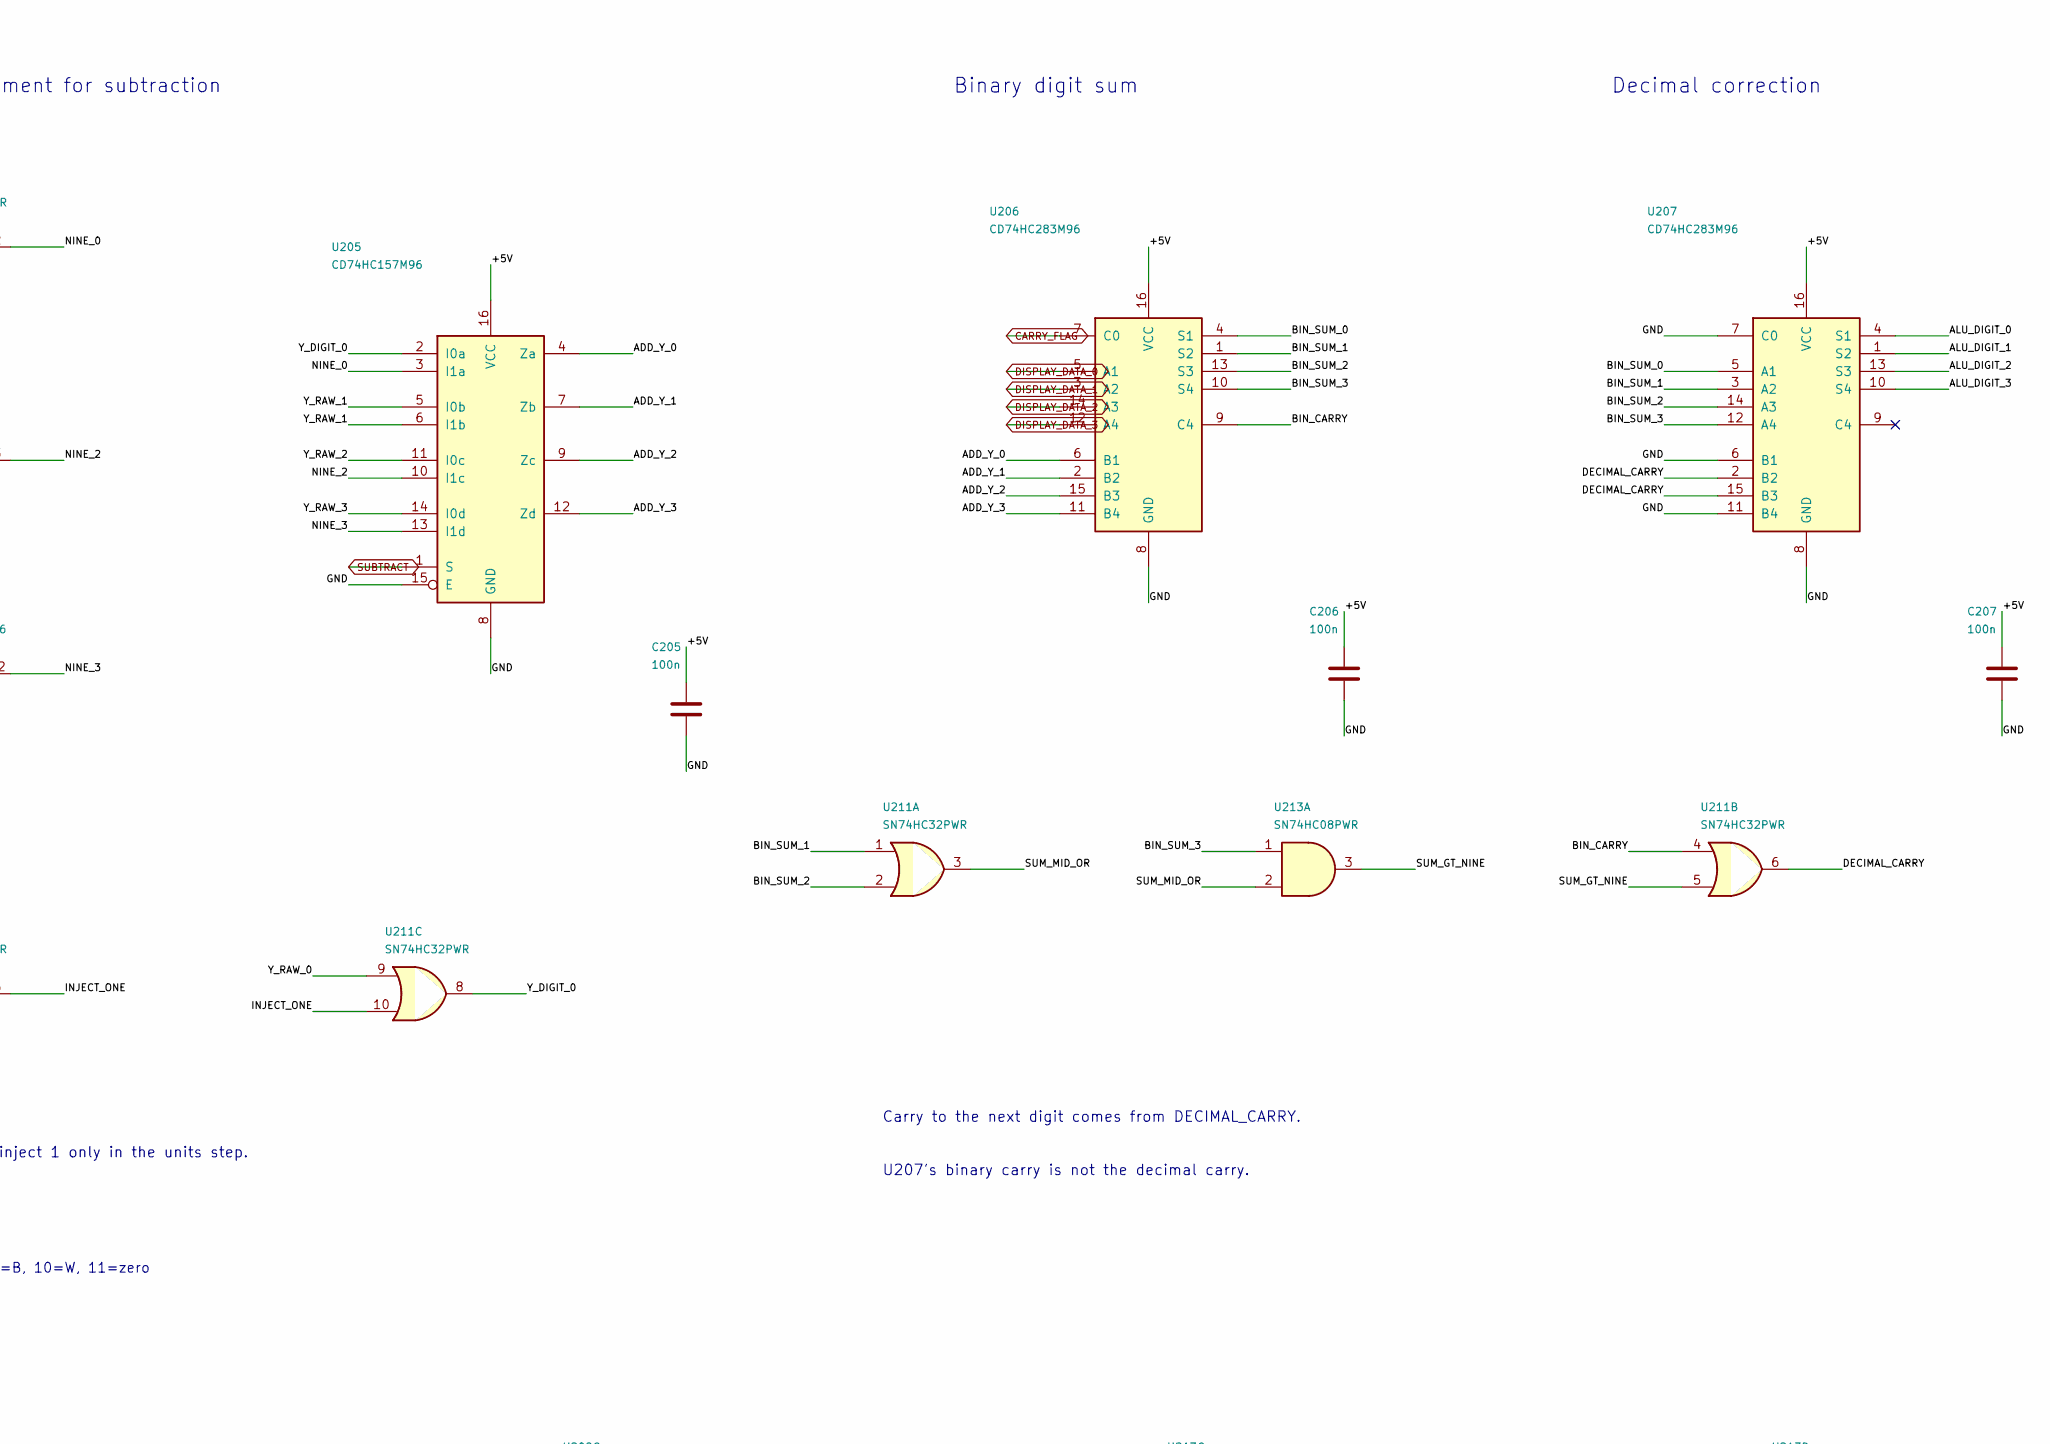
[picture p45: schematic arithmetic.kicad_sch, Calculator - shared decimal arithmetic, part in row 1, column 2]

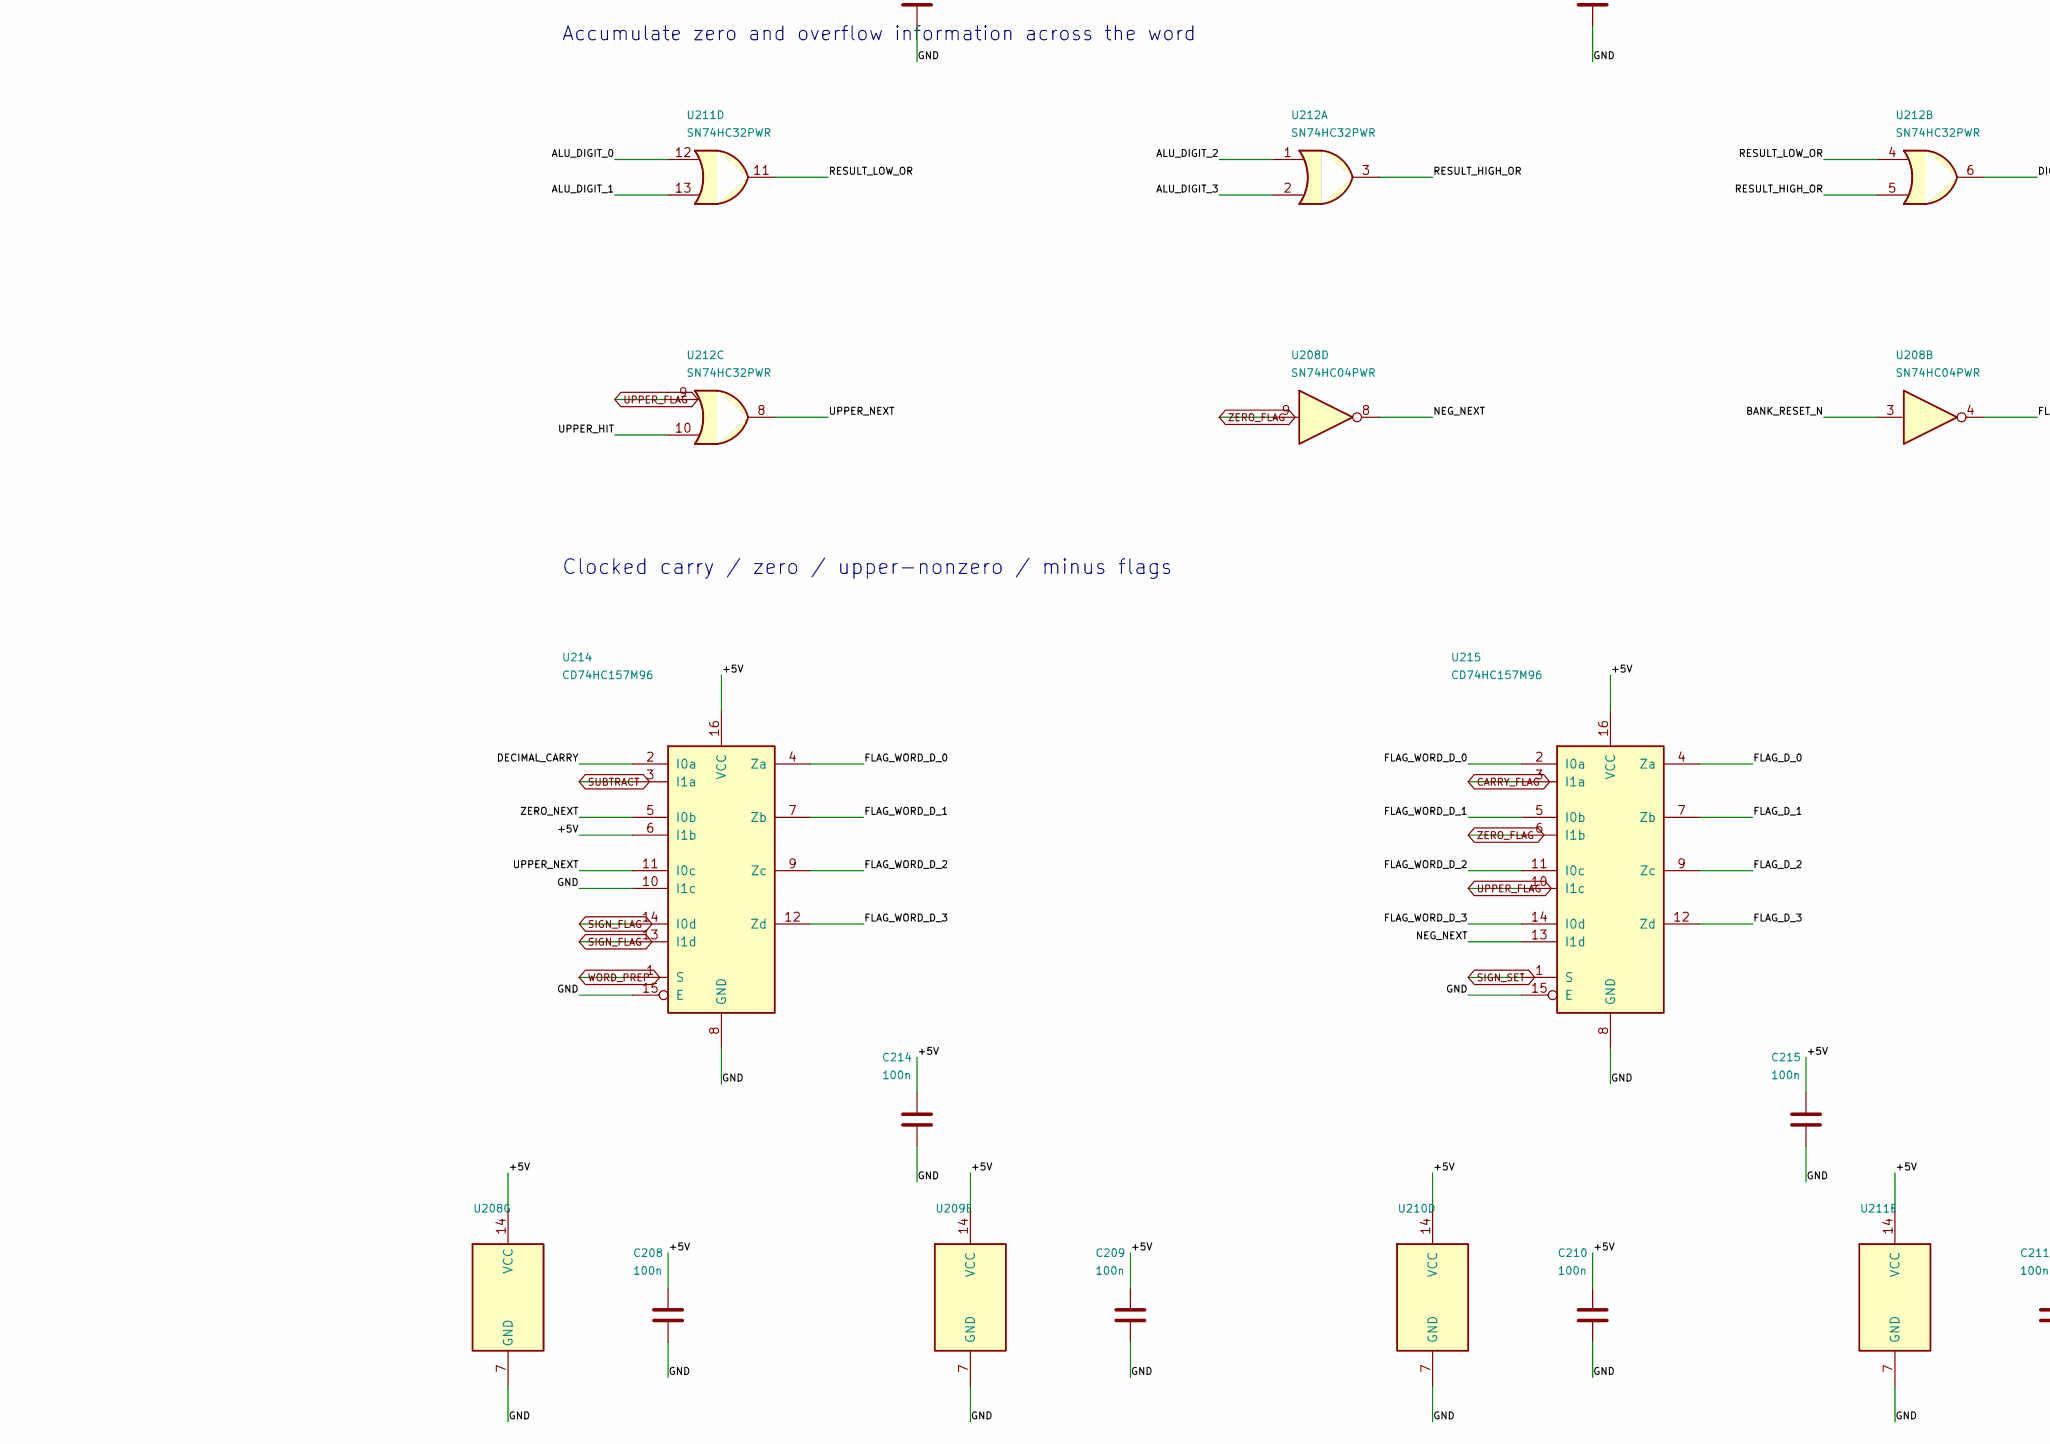
[picture p46: schematic arithmetic.kicad_sch, Calculator - shared decimal arithmetic, part in row 2, column 1]

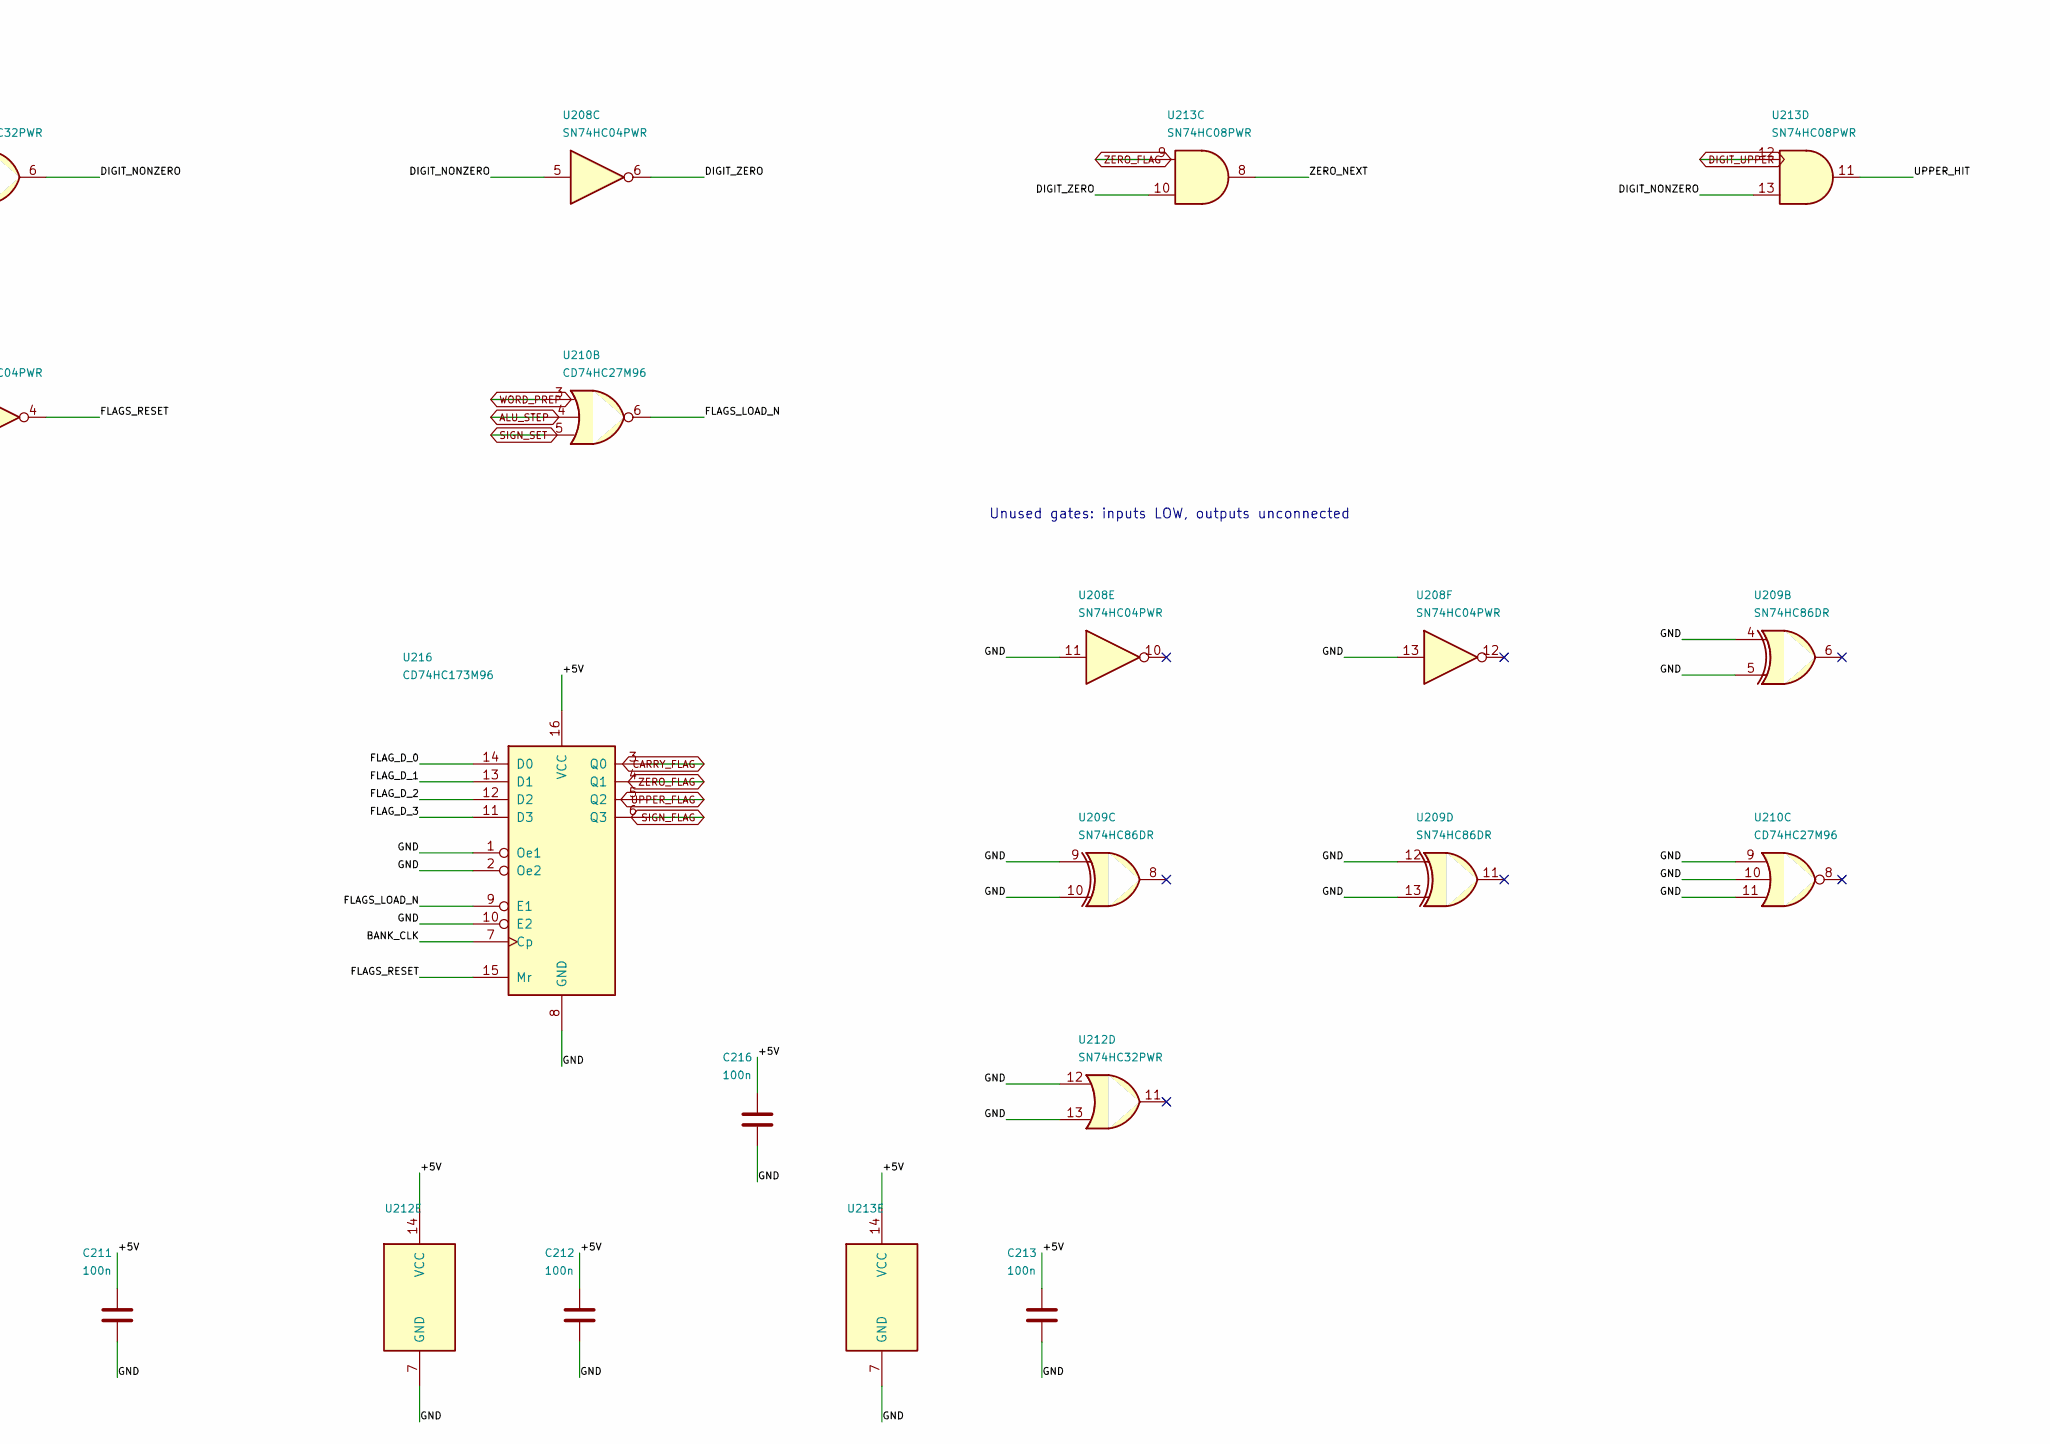
[picture p47: schematic arithmetic.kicad_sch, Calculator - shared decimal arithmetic, part in row 2, column 2]

Parts:
C201, C202, C203, C204, C205, C206, C207, C208, C209, C210, C211, C212, C213, C214, C215, C216: 100n; C_0603_1608Metric
U201, U202, U203, U204: CD74HC153M96; SOIC-16_3.9x9.9mm_P1.27mm
U205, U214, U215: CD74HC157M96; SOIC-16_3.9x9.9mm_P1.27mm
U206, U207: CD74HC283M96; SOIC-16_3.9x9.9mm_P1.27mm
U208: SN74HC04PWR; TSSOP-14_4.4x5mm_P0.65mm
U209: SN74HC86DR; SOIC-14_3.9x8.7mm_P1.27mm
U210: CD74HC27M96; SOIC-14_3.9x8.7mm_P1.27mm
U211, U212: SN74HC32PWR; TSSOP-14_4.4x5mm_P0.65mm
U213: SN74HC08PWR; TSSOP-14_4.4x5mm_P0.65mm
U216: CD74HC173M96; SOIC-16_3.9x9.9mm_P1.27mm

Connections:
+5V: C201.1, C202.1, C203.1, C204.1, C205.1, C206.1, C207.1, C208.1, C209.1, C210.1, C211.1, C212.1, C213.1, C214.1, C215.1, C216.1, U201.16 (VCC), U202.16 (VCC), U203.16 (VCC), U204.16 (VCC), U205.16 (VCC), U206.16 (VCC), U207.16 (VCC), U208.14 (VCC), U209.14 (VCC), U210.14 (VCC), U211.14 (VCC), U212.14 (VCC), U213.14 (VCC), U214.6 (I1b), U214.16 (VCC), U215.16 (VCC), U216.16 (VCC); also elsewhere on the board
/ALU_DIGIT_0: U207.4 (S1), U211.12; also elsewhere on the board
/ALU_DIGIT_1: U207.1 (S2), U211.13; also elsewhere on the board
/ALU_DIGIT_2: U207.13 (S3), U212.1; also elsewhere on the board
/ALU_DIGIT_3: U207.10 (S4), U212.2; also elsewhere on the board
/A_UNITS_0: U201.6 (I0a), U203.6 (I0a); also elsewhere on the board
/A_UNITS_1: U201.10 (I0b), U203.10 (I0b); also elsewhere on the board
/A_UNITS_2: U202.6 (I0a), U204.6 (I0a); also elsewhere on the board
/A_UNITS_3: U202.10 (I0b), U204.10 (I0b); also elsewhere on the board
/Arithmetic/ADD_Y_0: U205.4 (Za), U206.6 (B1)
/Arithmetic/ADD_Y_1: U205.7 (Zb), U206.2 (B2)
/Arithmetic/ADD_Y_2: U205.9 (Zc), U206.15 (B3)
/Arithmetic/ADD_Y_3: U205.12 (Zd), U206.11 (B4)
/Arithmetic/BIN_CARRY: U206.9 (C4), U211.4
/Arithmetic/BIN_SUM_0: U206.4 (S1), U207.5 (A1)
/Arithmetic/BIN_SUM_1: U206.1 (S2), U207.3 (A2), U211.1
/Arithmetic/BIN_SUM_2: U206.13 (S3), U207.14 (A3), U211.2
/Arithmetic/BIN_SUM_3: U206.10 (S4), U207.12 (A4), U213.1
/Arithmetic/DECIMAL_CARRY: U207.2 (B2), U207.15 (B3), U211.6, U214.2 (I0a)
/Arithmetic/DIGIT_NONZERO: U208.5, U212.6, U213.13
/Arithmetic/DIGIT_ZERO: U208.6, U213.10
/Arithmetic/FLAGS_LOAD_N: U210.6, U216.9 (E1)
/Arithmetic/FLAGS_RESET: U208.4, U216.15 (Mr)
/Arithmetic/FLAG_D_0: U215.4 (Za), U216.14 (D0)
/Arithmetic/FLAG_D_1: U215.7 (Zb), U216.13 (D1)
/Arithmetic/FLAG_D_2: U215.9 (Zc), U216.12 (D2)
/Arithmetic/FLAG_D_3: U215.12 (Zd), U216.11 (D3)
/Arithmetic/FLAG_WORD_D_0: U214.4 (Za), U215.2 (I0a)
/Arithmetic/FLAG_WORD_D_1: U214.7 (Zb), U215.5 (I0b)
/Arithmetic/FLAG_WORD_D_2: U214.9 (Zc), U215.11 (I0c)
/Arithmetic/FLAG_WORD_D_3: U214.12 (Zd), U215.14 (I0d)
/Arithmetic/INJECT_ONE: U211.10, U213.6
/Arithmetic/NEG_NEXT: U208.8, U215.13 (I1d)
/Arithmetic/NINE_0: U205.3 (I1a), U208.2
/Arithmetic/NINE_2: U205.10 (I1c), U209.3
/Arithmetic/NINE_3: U205.13 (I1d), U210.12
/Arithmetic/RESULT_HIGH_OR: U212.3, U212.5
/Arithmetic/RESULT_LOW_OR: U211.11, U212.4
/Arithmetic/SUM_GT_NINE: U211.5, U213.3
/Arithmetic/SUM_MID_OR: U211.3, U213.2
/Arithmetic/UPPER_HIT: U212.10, U213.11
/Arithmetic/UPPER_NEXT: U212.8, U214.11 (I0c)
/Arithmetic/Y_DIGIT_0: U205.2 (I0a), U208.1, U211.8
/Arithmetic/Y_RAW_0: U203.7 (Za), U211.9
/Arithmetic/Y_RAW_1: U203.9 (Zb), U205.5 (I0b), U205.6 (I1b), U209.2, U210.13
/Arithmetic/Y_RAW_2: U204.7 (Za), U205.11 (I0c), U209.1, U210.2
/Arithmetic/Y_RAW_3: U204.9 (Zb), U205.14 (I0d), U210.1
/Arithmetic/ZERO_NEXT: U213.8, U214.5 (I0b)
/BANK_RESET_N: U208.3; also elsewhere on the board
/B_UNITS_0: U201.5 (I1a), U203.5 (I1a); also elsewhere on the board
/B_UNITS_1: U201.11 (I1b), U203.11 (I1b); also elsewhere on the board
/B_UNITS_2: U202.5 (I1a), U204.5 (I1a); also elsewhere on the board
/B_UNITS_3: U202.11 (I1b), U204.11 (I1b); also elsewhere on the board
/W_UNITS_0: U201.4 (I2a), U203.4 (I2a); also elsewhere on the board
/W_UNITS_1: U201.12 (I2b), U203.12 (I2b); also elsewhere on the board
/W_UNITS_2: U202.4 (I2a), U204.4 (I2a); also elsewhere on the board
/W_UNITS_3: U202.12 (I2b), U204.12 (I2b); also elsewhere on the board
ALU_STEP: U210.4; also elsewhere on the board
BANK_CLK: U216.7 (Cp); also elsewhere on the board
CARRY_FLAG: U206.7 (C0), U215.3 (I1a), U216.3 (Q0); also elsewhere on the board
CONST_ONE: U213.4; also elsewhere on the board
DIGIT_FIRST: U213.5; also elsewhere on the board
DIGIT_UPPER: U213.12; also elsewhere on the board
DISPLAY_DATA_0: U201.7 (Za), U206.5 (A1); also elsewhere on the board
DISPLAY_DATA_1: U201.9 (Zb), U206.3 (A2); also elsewhere on the board
DISPLAY_DATA_2: U202.7 (Za), U206.14 (A3); also elsewhere on the board
DISPLAY_DATA_3: U202.9 (Zb), U206.12 (A4); also elsewhere on the board
GND: C201.2, C202.2, C203.2, C204.2, C205.2, C206.2, C207.2, C208.2, C209.2, C210.2, C211.2, C212.2, C213.2, C214.2, C215.2, C216.2, U201.1 (Ea), U201.3 (I3a), U201.8 (GND), U201.13 (I3b), U201.15 (Eb), U202.1 (Ea), U202.3 (I3a), U202.8 (GND), U202.13 (I3b), U202.15 (Eb), U203.1 (Ea), U203.3 (I3a), U203.8 (GND), U203.13 (I3b), U203.15 (Eb), U204.1 (Ea), U204.3 (I3a), U204.8 (GND), U204.13 (I3b), U204.15 (Eb), U205.8 (GND), U205.15 (E), U206.8 (GND), U207.6 (B1), U207.7 (C0), U207.8 (GND), U207.11 (B4), U208.7 (GND), U208.11, U208.13, U209.4, U209.5, U209.7 (GND), U209.9, U209.10, U209.12, U209.13, U210.7 (GND), U210.9, U210.10, U210.11, U211.7 (GND), U212.7 (GND), U212.12, U212.13, U213.7 (GND), U214.8 (GND), U214.10 (I1c), U214.15 (E), U215.8 (GND), U215.15 (E), U216.1 (Oe1), U216.2 (Oe2), U216.8 (GND), U216.10 (E2); also elsewhere on the board
SIGN_FLAG: U214.13 (I1d), U214.14 (I0d), U216.6 (Q3); also elsewhere on the board
SIGN_SET: U210.5, U215.1 (S); also elsewhere on the board
SUBTRACT: U205.1 (S), U214.3 (I1a); also elsewhere on the board
UPPER_FLAG: U212.9, U215.10 (I1c), U216.5 (Q2); also elsewhere on the board
WORD_PREP: U210.3, U214.1 (S); also elsewhere on the board
X_SELECT_0: U201.14 (S0), U202.14 (S0); also elsewhere on the board
X_SELECT_1: U201.2 (S1), U202.2 (S1); also elsewhere on the board
Y_SELECT_0: U203.14 (S0), U204.14 (S0); also elsewhere on the board
Y_SELECT_1: U203.2 (S1), U204.2 (S1); also elsewhere on the board
ZERO_FLAG: U208.9, U213.9, U215.6 (I1b), U216.4 (Q1); also elsewhere on the board

Notes on the sheet:
Inputs from the register sheet
Choose X
Choose Y
X/Y selection: 00=A, 01=B, 10=W, 11=zero
Nine's complement for subtraction
Increment/decrement: inject 1 only in the units step.
Binary digit sum
Decimal correction
Carry to the next digit comes from DECIMAL_CARRY.
U207's binary carry is not the decimal carry.
Accumulate zero and overflow information across the word
Clocked carry / zero / upper-nonzero / minus flags
Unused gates: inputs LOW, outputs unconnected
