EwoudVV/calculator/calculator.kicad_pcb

## KiCad design calculator.kicad_pcb (continued)

Schematic: sequencer.kicad_sch, Calculator - word and display sequencer

Parts:
C301, C302, C303, C304, C305, C306, C307, C308, C309, C310, C311, C312, C313, C314, C315, C316, C317, C318, C319, C320: 100n; C_0603_1608Metric
U301, U302: SN74HC163DR; SOIC-16_3.9x9.9mm_P1.27mm
U303: CD74HC173M96; SOIC-16_3.9x9.9mm_P1.27mm
U304: CD74HC157M96; SOIC-16_3.9x9.9mm_P1.27mm
U305: CD74HC139M96; SOIC-16_3.9x9.9mm_P1.27mm
U306, U309, U317: SN74HC04PWR; TSSOP-14_4.4x5mm_P0.65mm
U307, U311, U312, U313, U315, U316, U319: SN74HC08PWR; TSSOP-14_4.4x5mm_P0.65mm
U308, U314, U318: SN74HC32PWR; TSSOP-14_4.4x5mm_P0.65mm
U310: CD74HC27M96; SOIC-14_3.9x8.7mm_P1.27mm
U320: SN74HC74DR; SOIC-14_3.9x8.7mm_P1.27mm

Connections:
+5V: C301.1, C302.1, C303.1, C304.1, C305.1, C306.1, C307.1, C308.1, C309.1, C310.1, C311.1, C312.1, C313.1, C314.1, C315.1, C316.1, C317.1, C318.1, C319.1, C320.1, U301.9 (~PE), U301.10 (CET), U301.16 (VCC), U302.9 (~PE), U302.10 (CET), U302.16 (VCC), U303.16 (VCC), U304.16 (VCC), U305.16 (VCC), U306.14 (VCC), U307.14 (VCC), U308.14 (VCC), U309.14 (VCC), U310.14 (VCC), U311.5, U311.14 (VCC), U312.14 (VCC), U313.14 (VCC), U314.14 (VCC), U315.14 (VCC), U316.14 (VCC), U317.14 (VCC), U318.14 (VCC), U319.14 (VCC), U320.1 (~R), U320.10 (~S), U320.14 (VCC); also elsewhere on the board
/BANK_RESET_N: U320.6 (~Q); also elsewhere on the board
/Sequencer/ACTION_ALLOWED: U307.3, U307.5, U307.10, U315.10, U316.5, U319.2
/Sequencer/CANCEL_N: U306.12, U307.2
/Sequencer/DIGIT_ENABLE: U302.7 (CEP), U313.3
/Sequencer/DIGIT_LAST: U309.3, U311.3, U312.13, U313.5
/Sequencer/DIGIT_LOW_ONES: U307.11, U311.1
/Sequencer/DIGIT_NOT_LAST: U309.4, U313.2
/Sequencer/DIGIT_STEP: U308.11, U313.1
/Sequencer/DISPLAY_ACTIVE: U307.8, U312.1, U312.4, U314.4
/Sequencer/DISPLAY_DONE: U308.10, U312.11
/Sequencer/DISPLAY_ROTATE_A: U314.10, U315.6
/Sequencer/DISPLAY_ROTATE_B: U314.13, U316.3
/Sequencer/DISPLAY_ROTATE_N: U309.6, U313.13
/Sequencer/DISPLAY_ROTATE_W: U316.11, U318.2
/Sequencer/P0_N: U305.4 (O0), U306.1
/Sequencer/P1_N: U305.5 (O1), U306.3
/Sequencer/P2_N: U305.6 (O2), U306.5
/Sequencer/P3_N: U305.7 (O3), U306.9
/Sequencer/PHASE_0: U301.14 (Q0), U305.2 (A0)
/Sequencer/PHASE_1: U301.13 (Q1), U305.3 (A1)
/Sequencer/PHASE_ENABLE: U301.7 (CEP), U314.6
/Sequencer/PHASE_RESET_N: U301.1 (~MR), U313.11
/Sequencer/PH_CLOSE: U306.6, U312.10
/Sequencer/PH_PREP: U306.2, U311.10, U312.2, U314.1
/Sequencer/PH_ROTATE: U306.8, U312.5
/Sequencer/PH_RUN: U306.4, U311.13, U313.4
/Sequencer/POWER_RESET: U303.15 (Mr), U306.10, U308.5
/Sequencer/SEQUENCER_RESET_N: U302.1 (~MR), U309.2, U313.12
/Sequencer/SEQ_ABORT_OR_ADVANCE: U308.3, U308.4
/Sequencer/SEQ_RESET: U308.6, U309.1
/Sequencer/SOURCE_A: U309.10, U315.5
/Sequencer/SOURCE_A_N: U305.12 (O0), U309.11
/Sequencer/SOURCE_B: U309.12, U316.2
/Sequencer/SOURCE_B_N: U305.11 (O1), U309.13
/Sequencer/SOURCE_LOAD: U309.9, U315.3
/Sequencer/SOURCE_LOAD_N: U303.9 (E1), U309.8
/Sequencer/SOURCE_W: U316.13, U317.2
/Sequencer/SOURCE_W_N: U305.10 (O2), U317.1
/Sequencer/WORD_ACTIVE: U307.6, U311.9, U311.12, U312.9, U313.9
/Sequencer/WORD_DONE: U308.9, U312.8
/Sequencer/WORD_LAST_RUN: U313.6, U314.2
/Sequencer/WORD_PHASE_ENABLE: U313.8, U314.5
/Sequencer/WORD_PHASE_STEP: U313.10, U314.3
ALU_STEP: U308.12, U311.11, U314.9, U314.12, U318.1; also elsewhere on the board
A_ROTATE_RIGHT: U314.8; also elsewhere on the board
A_SHIFT_LEFT: U315.8; also elsewhere on the board
A_WRITE_ALU: U315.11; also elsewhere on the board
BANK_CLK: U301.2 (CP), U302.2 (CP), U303.7 (Cp), U320.3 (C); also elsewhere on the board
B_ROTATE_RIGHT: U314.11; also elsewhere on the board
B_SHIFT_LEFT: U316.6; also elsewhere on the board
B_WRITE_ALU: U316.8; also elsewhere on the board
CANCEL: U306.13, U308.2; also elsewhere on the board
DIGIT_FIRST: U310.12, U315.2; also elsewhere on the board
DIGIT_INDEX_0: U302.14 (Q0), U307.12, U310.1; also elsewhere on the board
DIGIT_INDEX_1: U302.13 (Q1), U307.13, U310.2; also elsewhere on the board
DIGIT_INDEX_2: U302.12 (Q2), U310.13, U311.2, U311.4; also elsewhere on the board
DIGIT_UPPER: U311.6; also elsewhere on the board
DISPLAY_MODE: U307.9; also elsewhere on the board
DISPLAY_PREP: U312.3, U315.1; also elsewhere on the board
DISPLAY_ROTATE: U308.13, U309.5, U312.6, U312.12, U315.4, U316.1, U316.12
DISPLAY_SOURCE_0: U303.14 (D0); also elsewhere on the board
DISPLAY_SOURCE_1: U303.13 (D1); also elsewhere on the board
GND: C301.2, C302.2, C303.2, C304.2, C305.2, C306.2, C307.2, C308.2, C309.2, C310.2, C311.2, C312.2, C313.2, C314.2, C315.2, C316.2, C317.2, C318.2, C319.2, C320.2, U301.3 (D0), U301.4 (D1), U301.5 (D2), U301.6 (D3), U301.8 (GND), U302.3 (D0), U302.4 (D1), U302.5 (D2), U302.6 (D3), U302.8 (GND), U303.1 (Oe1), U303.2 (Oe2), U303.8 (GND), U303.10 (E2), U303.11 (D3), U303.12 (D2), U304.8 (GND), U304.15 (E), U305.1 (E), U305.8 (GND), U305.15 (E), U306.7 (GND), U307.7 (GND), U308.7 (GND), U309.7 (GND), U310.3, U310.4, U310.5, U310.7 (GND), U310.9, U310.10, U310.11, U311.7 (GND), U312.7 (GND), U313.7 (GND), U314.7 (GND), U315.7 (GND), U316.7 (GND), U317.3, U317.5, U317.7 (GND), U317.9, U317.11, U317.13, U318.4, U318.5, U318.7 (GND), U318.9, U318.10, U318.12, U318.13, U319.7 (GND), U319.9, U319.10, U319.12, U319.13, U320.7 (GND), U320.11 (C), U320.12 (D), U320.13 (~R); also elsewhere on the board
MAC_BANK_RESET: U320.2 (D); also elsewhere on the board
MAC_SHIFT_A: U315.9; also elsewhere on the board
MAC_SHIFT_B: U316.4; also elsewhere on the board
MAC_SHIFT_W: U319.1; also elsewhere on the board
MAC_WRITE_A: U315.12; also elsewhere on the board
MAC_WRITE_B: U316.9; also elsewhere on the board
MAC_WRITE_W: U319.4; also elsewhere on the board
MAC_X_0: U304.3 (I1a); also elsewhere on the board
MAC_X_1: U304.6 (I1b); also elsewhere on the board
MAC_Y_0: U304.10 (I1c), U304.11 (I0c); also elsewhere on the board
MAC_Y_1: U304.13 (I1d), U304.14 (I0d); also elsewhere on the board
POWER_RESET_N: U306.11, U307.1, U320.4 (~S); also elsewhere on the board
SAVED_SOURCE_0: U303.3 (Q0), U304.2 (I0a), U305.14 (A0)
SAVED_SOURCE_1: U303.4 (Q1), U304.5 (I0b), U305.13 (A1)
SEQUENCE_DONE: U308.8; also elsewhere on the board
STATE_ADVANCE: U308.1; also elsewhere on the board
WORD_MODE: U304.1 (S), U307.4, U315.13, U316.10, U319.5; also elsewhere on the board
WORD_PREP: U311.8; also elsewhere on the board
W_ROTATE_RIGHT: U318.3; also elsewhere on the board
W_SHIFT_LEFT: U319.3; also elsewhere on the board
W_WRITE_ALU: U319.6; also elsewhere on the board
X_SELECT_0: U304.4 (Za); also elsewhere on the board
X_SELECT_1: U304.7 (Zb); also elsewhere on the board
Y_SELECT_0: U304.9 (Zc); also elsewhere on the board
Y_SELECT_1: U304.12 (Zd); also elsewhere on the board

Notes on the sheet:
Phase counter
Eight internal digits
Hold display source through Clear
Adder / display bus selection
Close the display latch before clearing banks
Gate power and local decoupling

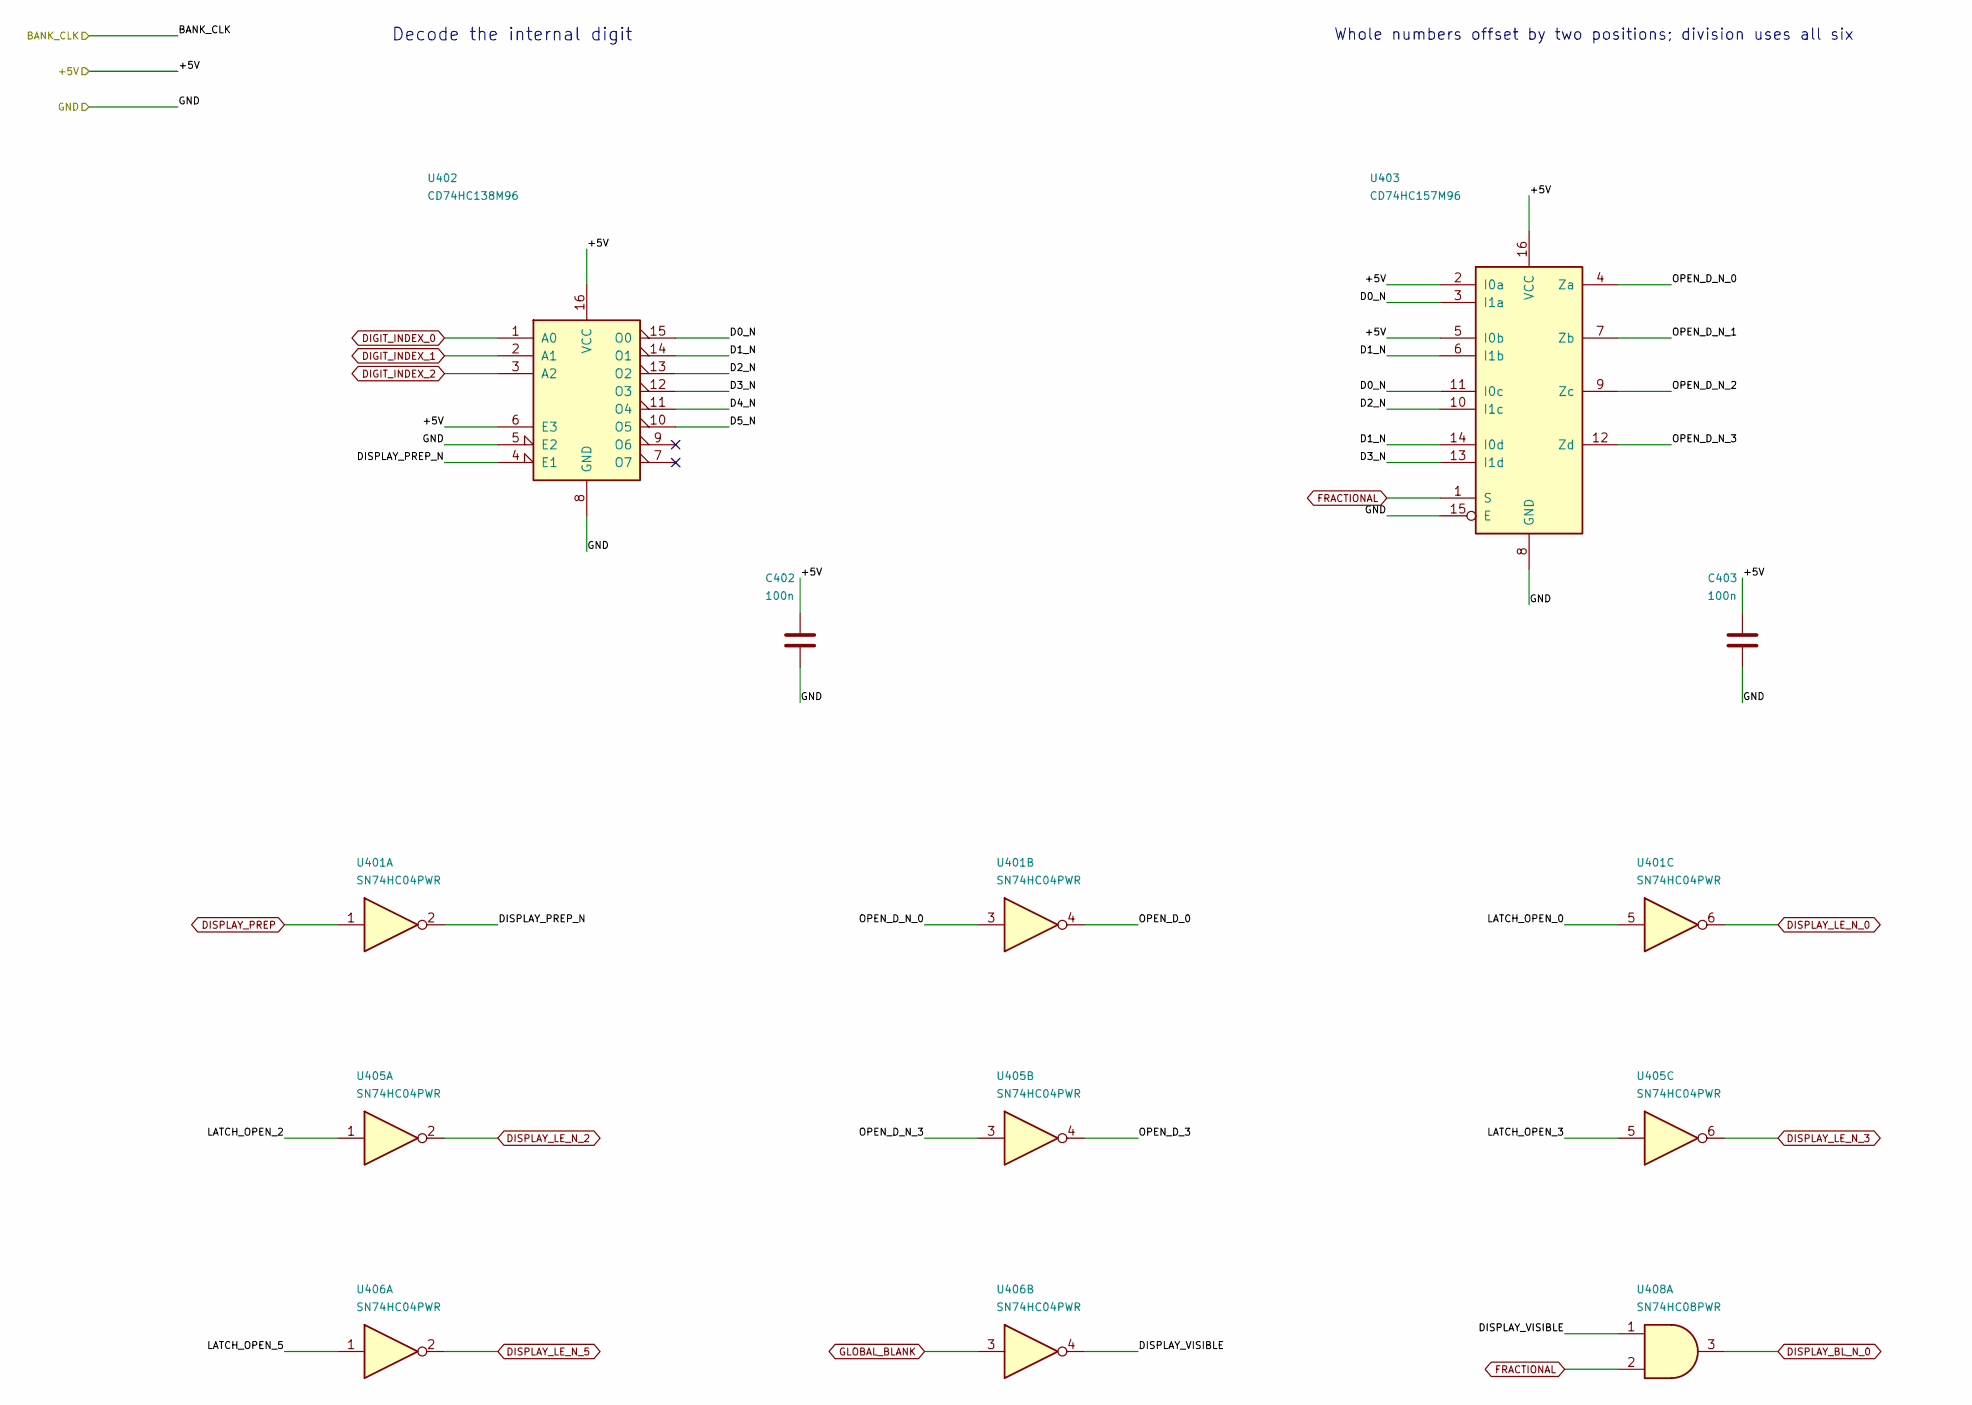
[picture p48: schematic display-transfer.kicad_sch, Calculator - display latch timing, part in row 1, column 1]

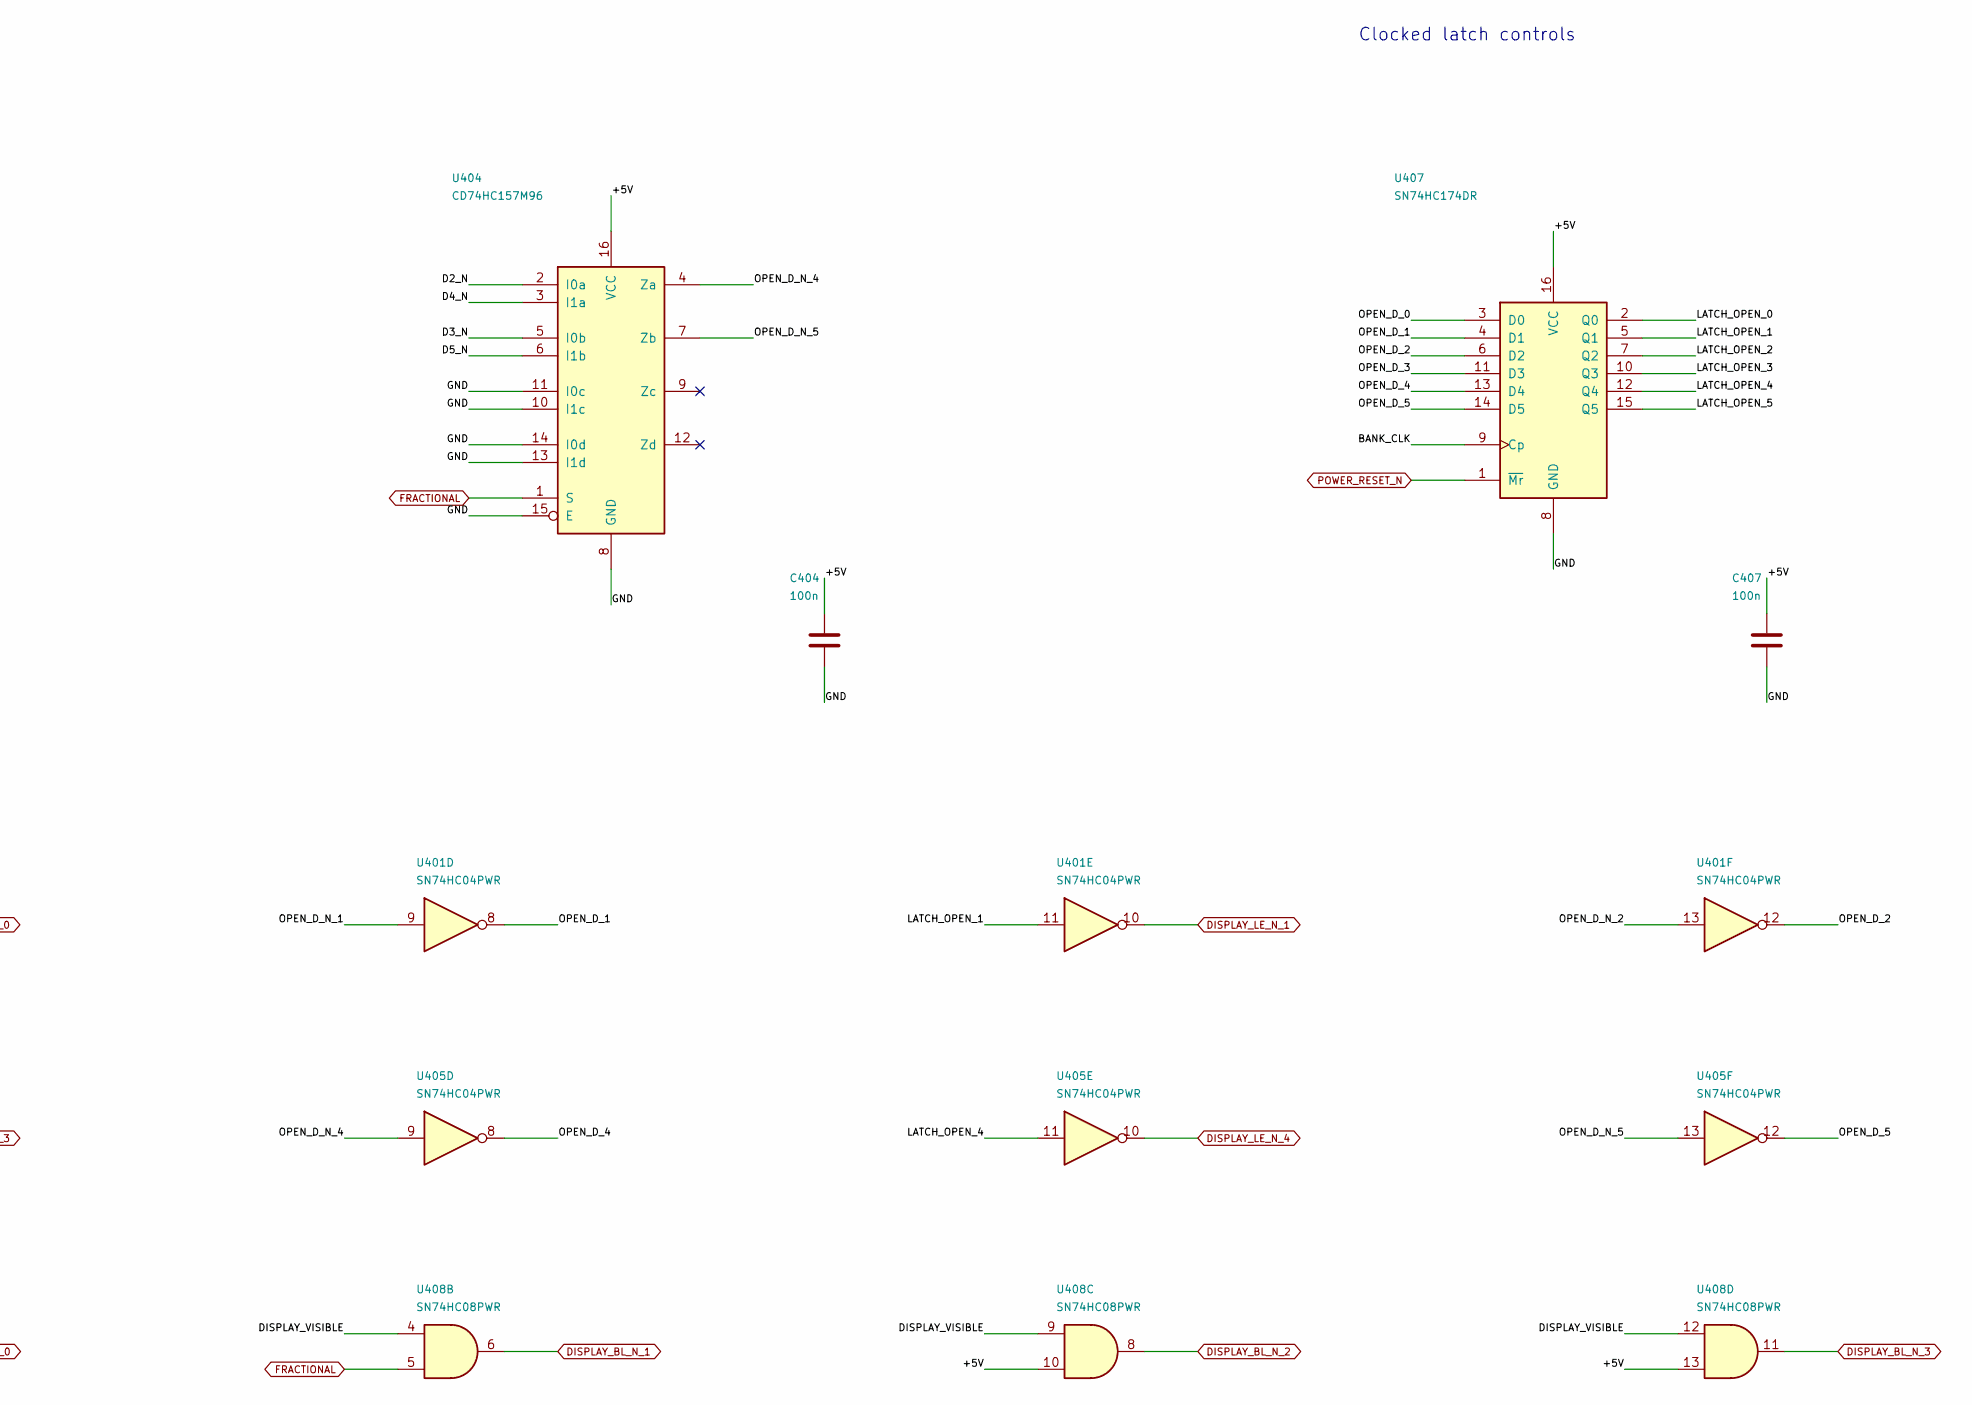
[picture p49: schematic display-transfer.kicad_sch, Calculator - display latch timing, part in row 1, column 2]

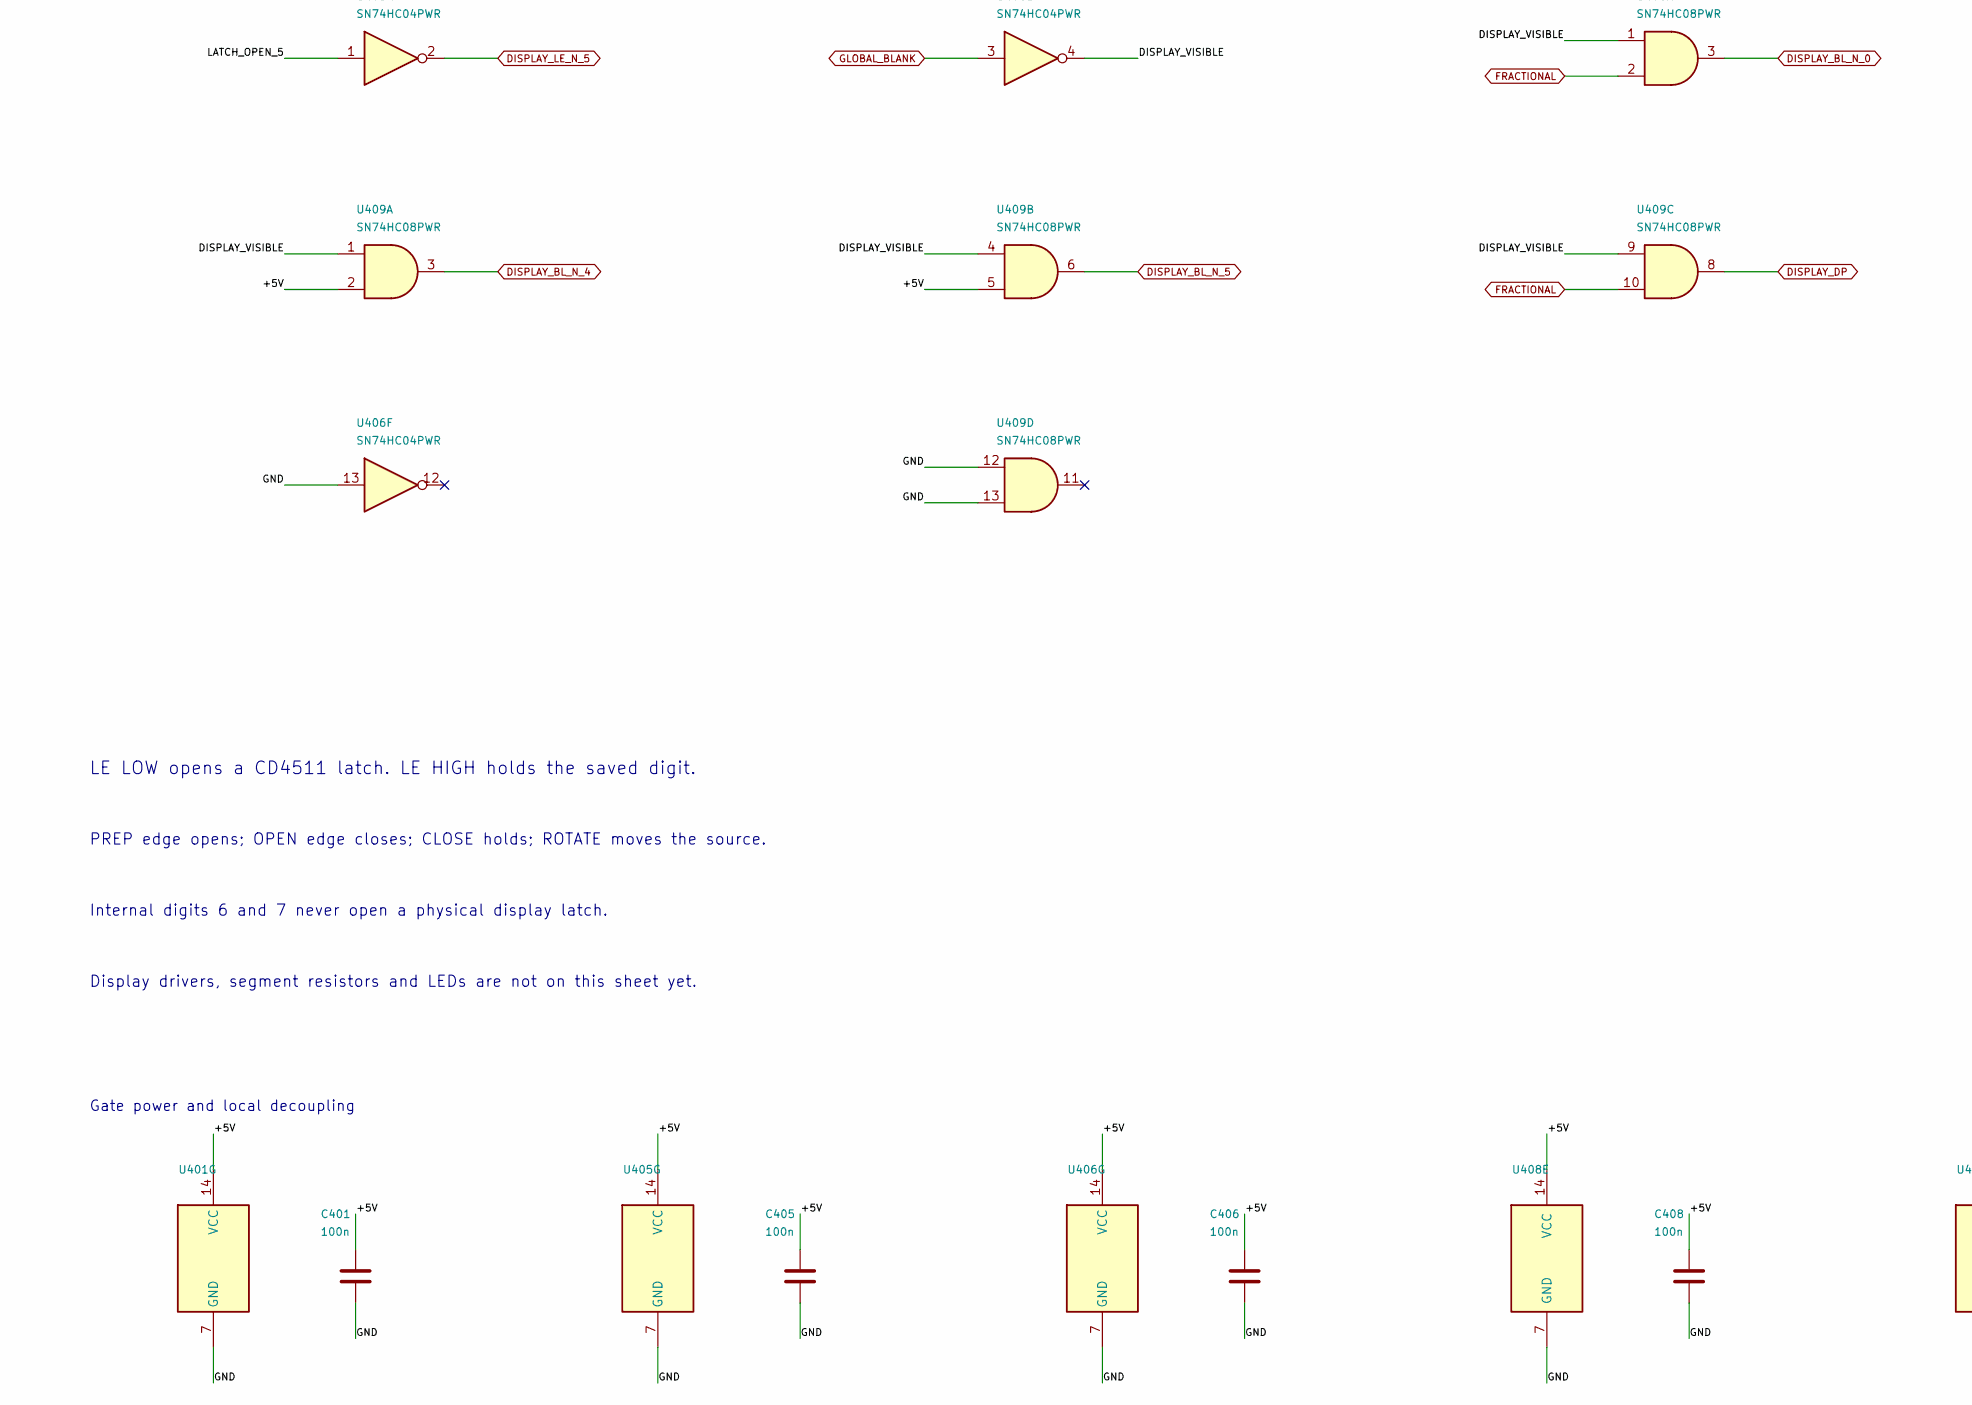
[picture p50: schematic display-transfer.kicad_sch, Calculator - display latch timing, part in row 2, column 1]

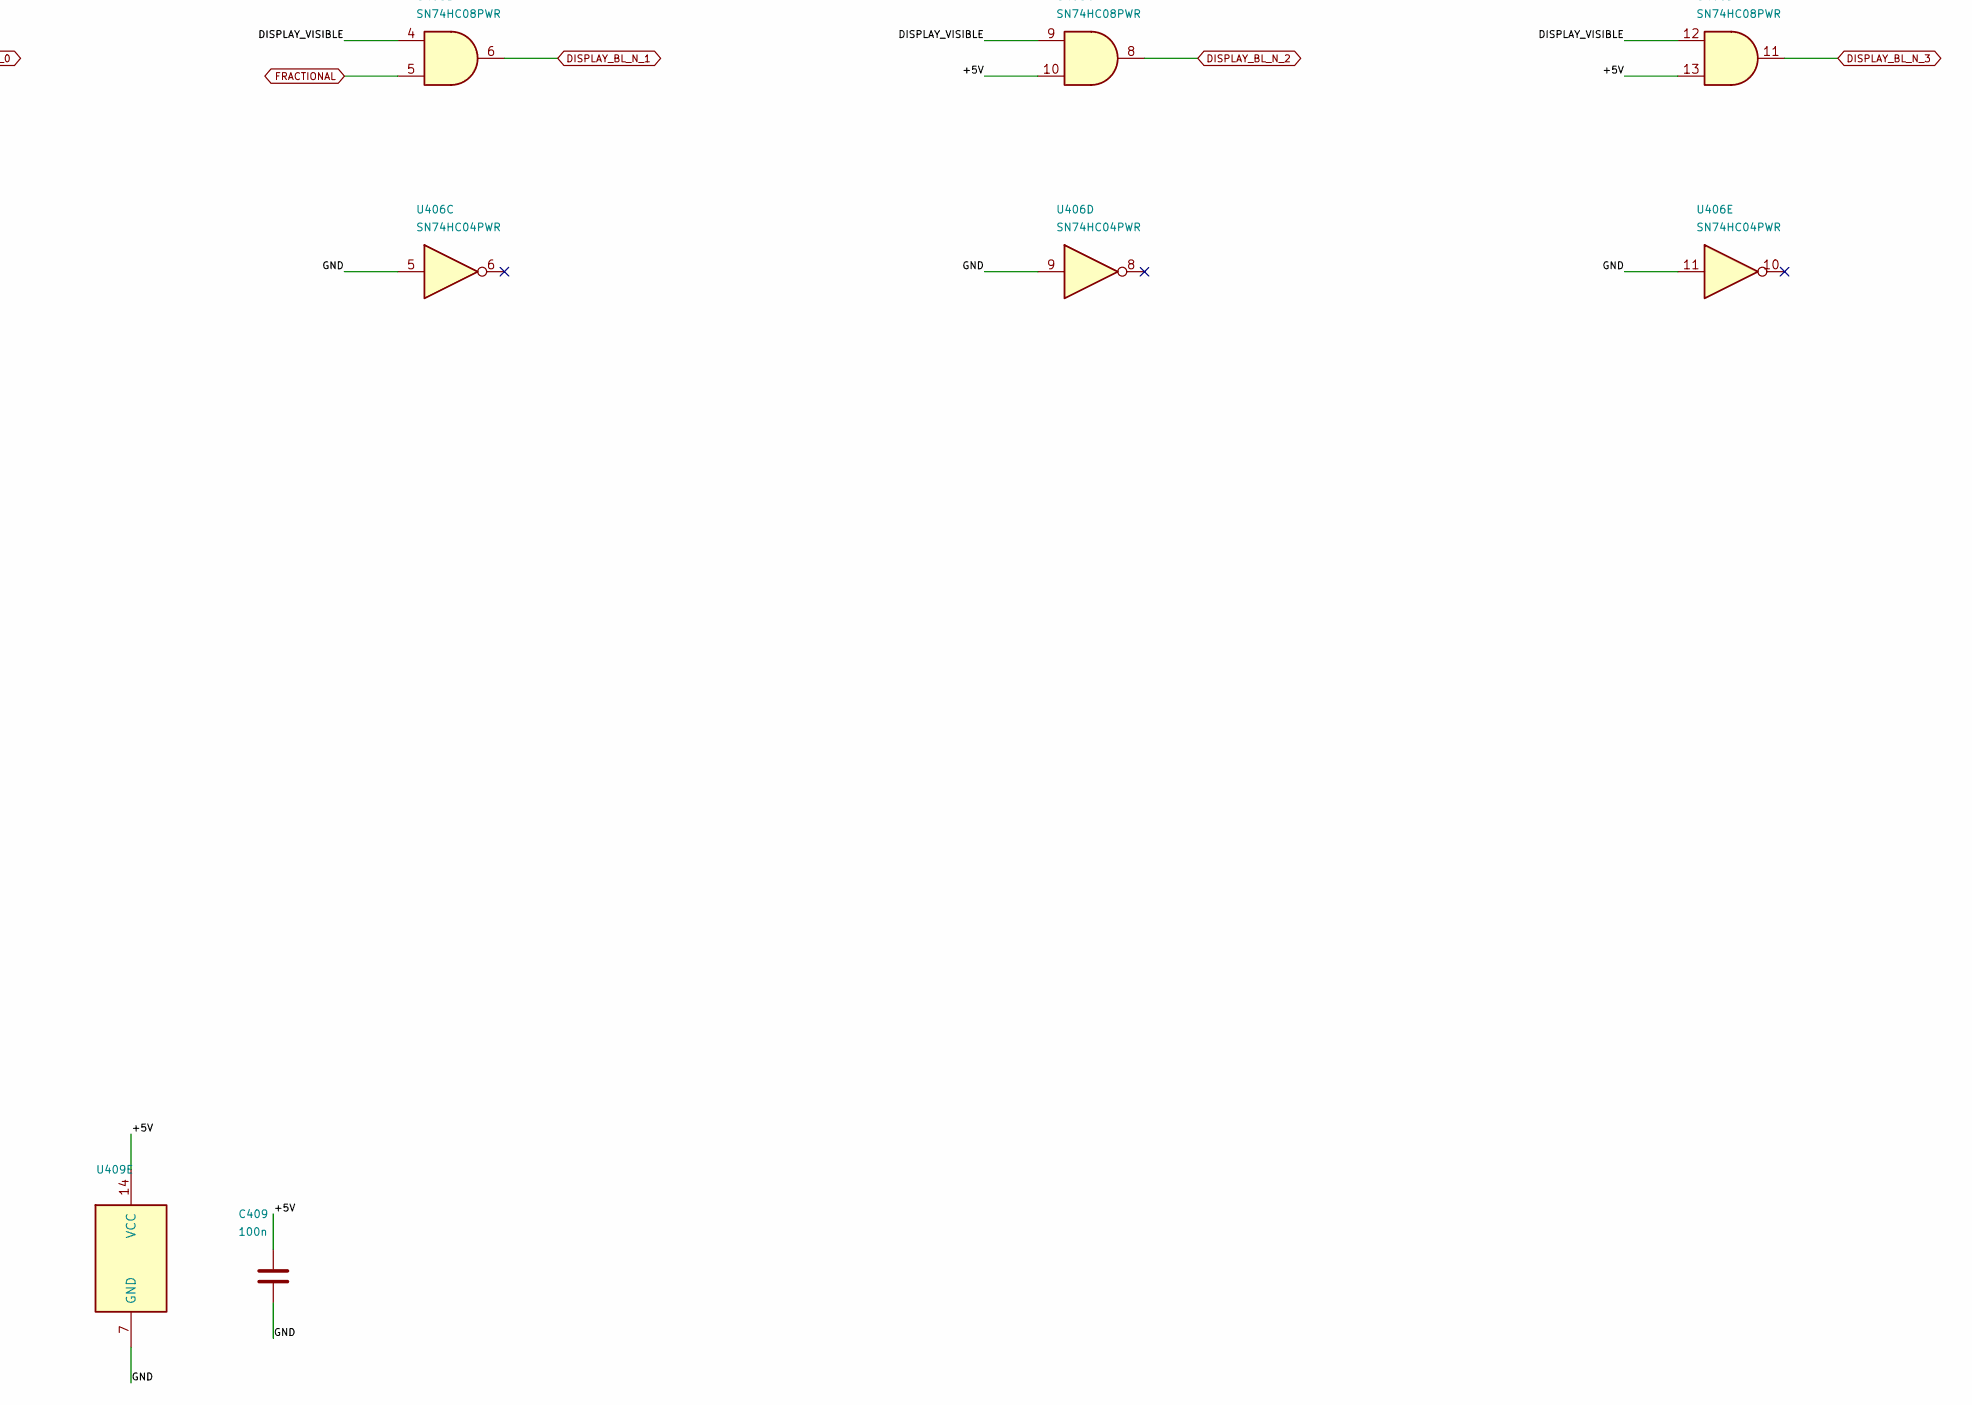
[picture p51: schematic display-transfer.kicad_sch, Calculator - display latch timing, part in row 2, column 2]

Parts:
C401, C402, C403, C404, C405, C406, C407, C408, C409: 100n; C_0603_1608Metric
U401, U405, U406: SN74HC04PWR; TSSOP-14_4.4x5mm_P0.65mm
U402: CD74HC138M96; SOIC-16_3.9x9.9mm_P1.27mm
U403, U404: CD74HC157M96; SOIC-16_3.9x9.9mm_P1.27mm
U407: SN74HC174DR; SOIC-16_3.9x9.9mm_P1.27mm
U408, U409: SN74HC08PWR; TSSOP-14_4.4x5mm_P0.65mm

Connections:
+5V: C401.1, C402.1, C403.1, C404.1, C405.1, C406.1, C407.1, C408.1, C409.1, U401.14 (VCC), U402.6 (E3), U402.16 (VCC), U403.2 (I0a), U403.5 (I0b), U403.16 (VCC), U404.16 (VCC), U405.14 (VCC), U406.14 (VCC), U407.16 (VCC), U408.10, U408.13, U408.14 (VCC), U409.2, U409.5, U409.14 (VCC); also elsewhere on the board
/Display timing/D0_N: U402.15 (O0), U403.3 (I1a), U403.11 (I0c)
/Display timing/D1_N: U402.14 (O1), U403.6 (I1b), U403.14 (I0d)
/Display timing/D2_N: U402.13 (O2), U403.10 (I1c), U404.2 (I0a)
/Display timing/D3_N: U402.12 (O3), U403.13 (I1d), U404.5 (I0b)
/Display timing/D4_N: U402.11 (O4), U404.3 (I1a)
/Display timing/D5_N: U402.10 (O5), U404.6 (I1b)
/Display timing/DISPLAY_PREP_N: U401.2, U402.4 (E1)
/Display timing/DISPLAY_VISIBLE: U406.4, U408.1, U408.4, U408.9, U408.12, U409.1, U409.4, U409.9
/Display timing/LATCH_OPEN_0: U401.5, U407.2 (Q0)
/Display timing/LATCH_OPEN_1: U401.11, U407.5 (Q1)
/Display timing/LATCH_OPEN_2: U405.1, U407.7 (Q2)
/Display timing/LATCH_OPEN_3: U405.5, U407.10 (Q3)
/Display timing/LATCH_OPEN_4: U405.11, U407.12 (Q4)
/Display timing/LATCH_OPEN_5: U406.1, U407.15 (Q5)
/Display timing/OPEN_D_0: U401.4, U407.3 (D0)
/Display timing/OPEN_D_1: U401.8, U407.4 (D1)
/Display timing/OPEN_D_2: U401.12, U407.6 (D2)
/Display timing/OPEN_D_3: U405.4, U407.11 (D3)
/Display timing/OPEN_D_4: U405.8, U407.13 (D4)
/Display timing/OPEN_D_5: U405.12, U407.14 (D5)
/Display timing/OPEN_D_N_0: U401.3, U403.4 (Za)
/Display timing/OPEN_D_N_1: U401.9, U403.7 (Zb)
/Display timing/OPEN_D_N_2: U401.13, U403.9 (Zc)
/Display timing/OPEN_D_N_3: U403.12 (Zd), U405.3
/Display timing/OPEN_D_N_4: U404.4 (Za), U405.9
/Display timing/OPEN_D_N_5: U404.7 (Zb), U405.13
BANK_CLK: U407.9 (Cp); also elsewhere on the board
DIGIT_INDEX_0: U402.1 (A0); also elsewhere on the board
DIGIT_INDEX_1: U402.2 (A1); also elsewhere on the board
DIGIT_INDEX_2: U402.3 (A2); also elsewhere on the board
DISPLAY_BL_N_0: U408.3; also elsewhere on the board
DISPLAY_BL_N_1: U408.6; also elsewhere on the board
DISPLAY_BL_N_2: U408.8; also elsewhere on the board
DISPLAY_BL_N_3: U408.11; also elsewhere on the board
DISPLAY_BL_N_4: U409.3; also elsewhere on the board
DISPLAY_BL_N_5: U409.6; also elsewhere on the board
DISPLAY_DP: U409.8; also elsewhere on the board
DISPLAY_LE_N_0: U401.6; also elsewhere on the board
DISPLAY_LE_N_1: U401.10; also elsewhere on the board
DISPLAY_LE_N_2: U405.2; also elsewhere on the board
DISPLAY_LE_N_3: U405.6; also elsewhere on the board
DISPLAY_LE_N_4: U405.10; also elsewhere on the board
DISPLAY_LE_N_5: U406.2; also elsewhere on the board
DISPLAY_PREP: U401.1; also elsewhere on the board
FRACTIONAL: U403.1 (S), U404.1 (S), U408.2, U408.5, U409.10; also elsewhere on the board
GLOBAL_BLANK: U406.3; also elsewhere on the board
GND: C401.2, C402.2, C403.2, C404.2, C405.2, C406.2, C407.2, C408.2, C409.2, U401.7 (GND), U402.5 (E2), U402.8 (GND), U403.8 (GND), U403.15 (E), U404.8 (GND), U404.10 (I1c), U404.11 (I0c), U404.13 (I1d), U404.14 (I0d), U404.15 (E), U405.7 (GND), U406.5, U406.7 (GND), U406.9, U406.11, U406.13, U407.8 (GND), U408.7 (GND), U409.7 (GND), U409.12, U409.13; also elsewhere on the board
POWER_RESET_N: U407.1 (~Mr); also elsewhere on the board

Notes on the sheet:
Decode the internal digit
Whole numbers offset by two positions; division uses all six
Clocked latch controls
LE LOW opens a CD4511 latch. LE HIGH holds the saved digit.
PREP edge opens; OPEN edge closes; CLOSE holds; ROTATE moves the source.
Internal digits 6 and 7 never open a physical display latch.
Display drivers, segment resistors and LEDs are not on this sheet yet.
Gate power and local decoupling

Schematic: controller.kicad_sch, Calculator - main state register and decode

Parts:
C501, C502, C503, C504, C505, C506, C507, C508, C509, C510: 100n; C_0603_1608Metric
U501, U502: SN74HC163DR; SOIC-16_3.9x9.9mm_P1.27mm
U503, U504, U505, U506, U507, U508, U509, U510: CD74HC138M96; SOIC-16_3.9x9.9mm_P1.27mm

Connections:
+5V: C501.1, C502.1, C503.1, C504.1, C505.1, C506.1, C507.1, C508.1, C509.1, C510.1, U501.1 (~MR), U501.10 (CET), U501.16 (VCC), U502.1 (~MR), U502.16 (VCC), U503.16 (VCC), U504.16 (VCC), U505.16 (VCC), U506.16 (VCC), U507.16 (VCC), U508.16 (VCC), U509.16 (VCC), U510.16 (VCC); also elsewhere on the board
/Main controller/STATE_GROUP_0_N: U503.15 (O0), U504.4 (E1)
/Main controller/STATE_GROUP_1_N: U503.14 (O1), U505.4 (E1)
/Main controller/STATE_GROUP_2_N: U503.13 (O2), U506.4 (E1)
/Main controller/STATE_GROUP_3_N: U503.12 (O3), U507.4 (E1)
/Main controller/STATE_GROUP_4_N: U503.11 (O4), U508.4 (E1)
/Main controller/STATE_GROUP_5_N: U503.10 (O5), U509.4 (E1)
/Main controller/STATE_GROUP_6_N: U503.9 (O6), U510.4 (E1)
BANK_CLK: U501.2 (CP), U502.2 (CP); also elsewhere on the board
GND: C501.2, C502.2, C503.2, C504.2, C505.2, C506.2, C507.2, C508.2, C509.2, C510.2, U501.8 (GND), U502.5 (D2), U502.6 (D3), U502.8 (GND), U503.4 (E1), U503.5 (E2), U503.8 (GND), U504.5 (E2), U504.8 (GND), U505.5 (E2), U505.8 (GND), U506.5 (E2), U506.8 (GND), U507.5 (E2), U507.8 (GND), U508.5 (E2), U508.8 (GND), U509.5 (E2), U509.8 (GND), U510.5 (E2), U510.8 (GND); also elsewhere on the board
MAIN_JUMP_0: U501.3 (D0); also elsewhere on the board
MAIN_JUMP_1: U501.4 (D1); also elsewhere on the board
MAIN_JUMP_2: U501.5 (D2); also elsewhere on the board
MAIN_JUMP_3: U501.6 (D3); also elsewhere on the board
MAIN_JUMP_4: U502.3 (D0); also elsewhere on the board
MAIN_JUMP_5: U502.4 (D1); also elsewhere on the board
MAIN_LOAD_N: U501.9 (~PE), U502.9 (~PE); also elsewhere on the board
MAIN_LOW_TC: U501.15 (TC), U502.10 (CET)
POWER_RESET_N: U503.6 (E3), U504.6 (E3), U505.6 (E3), U506.6 (E3), U507.6 (E3), U508.6 (E3), U509.6 (E3), U510.6 (E3); also elsewhere on the board
STATE_0: U501.14 (Q0), U504.1 (A0), U505.1 (A0), U506.1 (A0), U507.1 (A0), U508.1 (A0), U509.1 (A0), U510.1 (A0)
STATE_1: U501.13 (Q1), U504.2 (A1), U505.2 (A1), U506.2 (A1), U507.2 (A1), U508.2 (A1), U509.2 (A1), U510.2 (A1)
STATE_2: U501.12 (Q2), U504.3 (A2), U505.3 (A2), U506.3 (A2), U507.3 (A2), U508.3 (A2), U509.3 (A2), U510.3 (A2)
STATE_3: U501.11 (Q3), U503.1 (A0)
STATE_4: U502.14 (Q0), U503.2 (A1)
STATE_5: U502.13 (Q1), U503.3 (A2)
STATE_6: U502.12 (Q2); also elsewhere on the board
STATE_7: U502.11 (Q3); also elsewhere on the board
STATE_ADVANCE: U501.7 (CEP), U502.7 (CEP); also elsewhere on the board
STATE_GROUP_7_N: U503.7 (O7); also elsewhere on the board
S_ADD_CHECK_N: U504.13 (O2); also elsewhere on the board
S_ADD_N: U504.14 (O1); also elsewhere on the board
S_CLEAR_DISPLAY_N: U509.13 (O2); also elsewhere on the board
S_DIV_ZERO_N: U509.11 (O4); also elsewhere on the board
S_DONE_A_N: U509.14 (O1); also elsewhere on the board
S_DONE_W_N: U509.15 (O0); also elsewhere on the board
S_D_APPEND_N: U507.10 (O5); also elsewhere on the board
S_D_BORROW_N: U507.7 (O7); also elsewhere on the board
S_D_B_ZERO_N: U506.7 (O7); also elsewhere on the board
S_D_CLEAR_N: U507.13 (O2); also elsewhere on the board
S_D_DOUBLE_N: U508.11 (O4); also elsewhere on the board
S_D_INCREMENT_N: U508.7 (O7); also elsewhere on the board
S_D_Q_INC_N: U508.15 (O0); also elsewhere on the board
S_D_Q_RESET_N: U507.11 (O4); also elsewhere on the board
S_D_RESTORE_N: U508.14 (O1); also elsewhere on the board
S_D_ROUND_COMPARE_N: U508.10 (O5); also elsewhere on the board
S_D_ROUND_N: U508.9 (O6); also elsewhere on the board
S_D_SCALE_1_N: U507.15 (O0); also elsewhere on the board
S_D_SCALE_2_N: U507.14 (O1); also elsewhere on the board
S_D_STAGE_N: U508.12 (O3); also elsewhere on the board
S_D_START_N: U507.12 (O3); also elsewhere on the board
S_D_STORE_Q_N: U508.13 (O2); also elsewhere on the board
S_D_SUB_N: U507.9 (O6); also elsewhere on the board
S_D_TEST_B_N: U506.9 (O6); also elsewhere on the board
S_E_CLEAR_ASSERT_N: U510.14 (O1); also elsewhere on the board
S_E_CLEAR_WAIT_N: U510.13 (O2); also elsewhere on the board
S_E_DISPLAY_A_N: U509.7 (O7); also elsewhere on the board
S_E_DISPLAY_B_N: U510.15 (O0); also elsewhere on the board
S_E_NEW_CLEAR_N: U510.12 (O3); also elsewhere on the board
S_E_NEW_WAIT_N: U510.11 (O4); also elsewhere on the board
S_E_SHIFT_A_N: U509.10 (O5); also elsewhere on the board
S_E_SHIFT_B_N: U509.9 (O6); also elsewhere on the board
S_IDLE_N: U504.15 (O0); also elsewhere on the board
S_INVALID_53_N: U510.10 (O5); also elsewhere on the board
S_INVALID_54_N: U510.9 (O6); also elsewhere on the board
S_INVALID_55_N: U510.7 (O7); also elsewhere on the board
S_M_ADD_N: U506.14 (O1); also elsewhere on the board
S_M_AGAIN_N: U506.11 (O4); also elsewhere on the board
S_M_A_ZERO_N: U505.15 (O0); also elsewhere on the board
S_M_B_ZERO_N: U505.13 (O2); also elsewhere on the board
S_M_CLEAR_N: U506.15 (O0); also elsewhere on the board
S_M_COMPARE_N: U505.12 (O3); also elsewhere on the board
S_M_DEC_N: U506.12 (O3); also elsewhere on the board
S_M_LIMIT_N: U506.13 (O2); also elsewhere on the board
S_M_ORDER_N: U505.11 (O4); also elsewhere on the board
S_M_SAVE_N: U505.10 (O5); also elsewhere on the board
S_M_SWAP_A_N: U505.9 (O6); also elsewhere on the board
S_M_SWAP_B_N: U505.7 (O7); also elsewhere on the board
S_M_TEST_A_N: U504.7 (O7); also elsewhere on the board
S_M_TEST_B_N: U505.14 (O1); also elsewhere on the board
S_NEGATE_N: U504.10 (O5); also elsewhere on the board
S_OVERFLOW_N: U509.12 (O3); also elsewhere on the board
S_SET_MINUS_N: U504.9 (O6); also elsewhere on the board
S_SUB_CHECK_N: U504.11 (O4); also elsewhere on the board
S_SUB_N: U504.12 (O3); also elsewhere on the board
S_ZERO_W_N: U506.10 (O5); also elsewhere on the board

Notes on the sheet:
States 0 to 7
States 8 to 15
States 16 to 23
States 24 to 31
States 32 to 39
States 40 to 47
States 48 to 55
Count forward, or load a fixed branch target
Group decode
Clock and power reset are external. No control ROM.
