EwoudVV/calculator/calculator.kicad_pcb

## KiCad design calculator.kicad_pcb (continued)

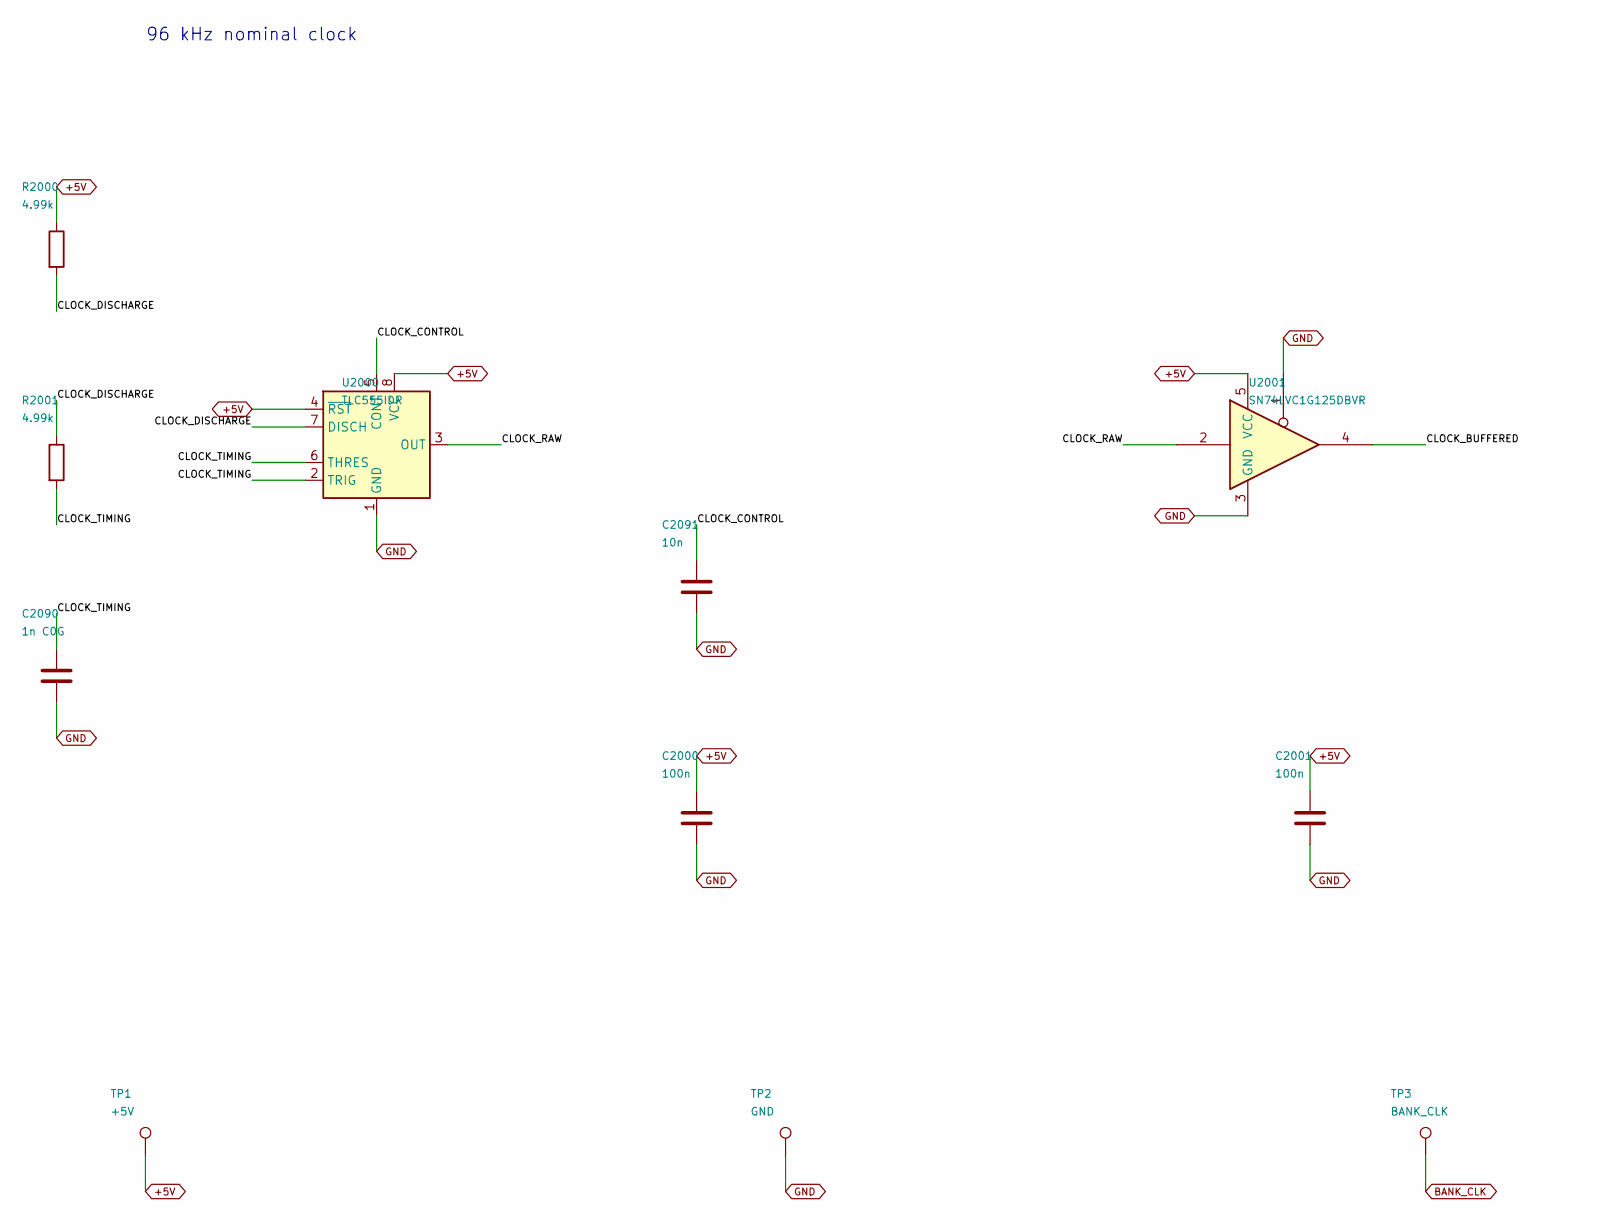
[picture p52: schematic power-clock.kicad_sch, Calculator - power and clock, part in row 1, column 1]

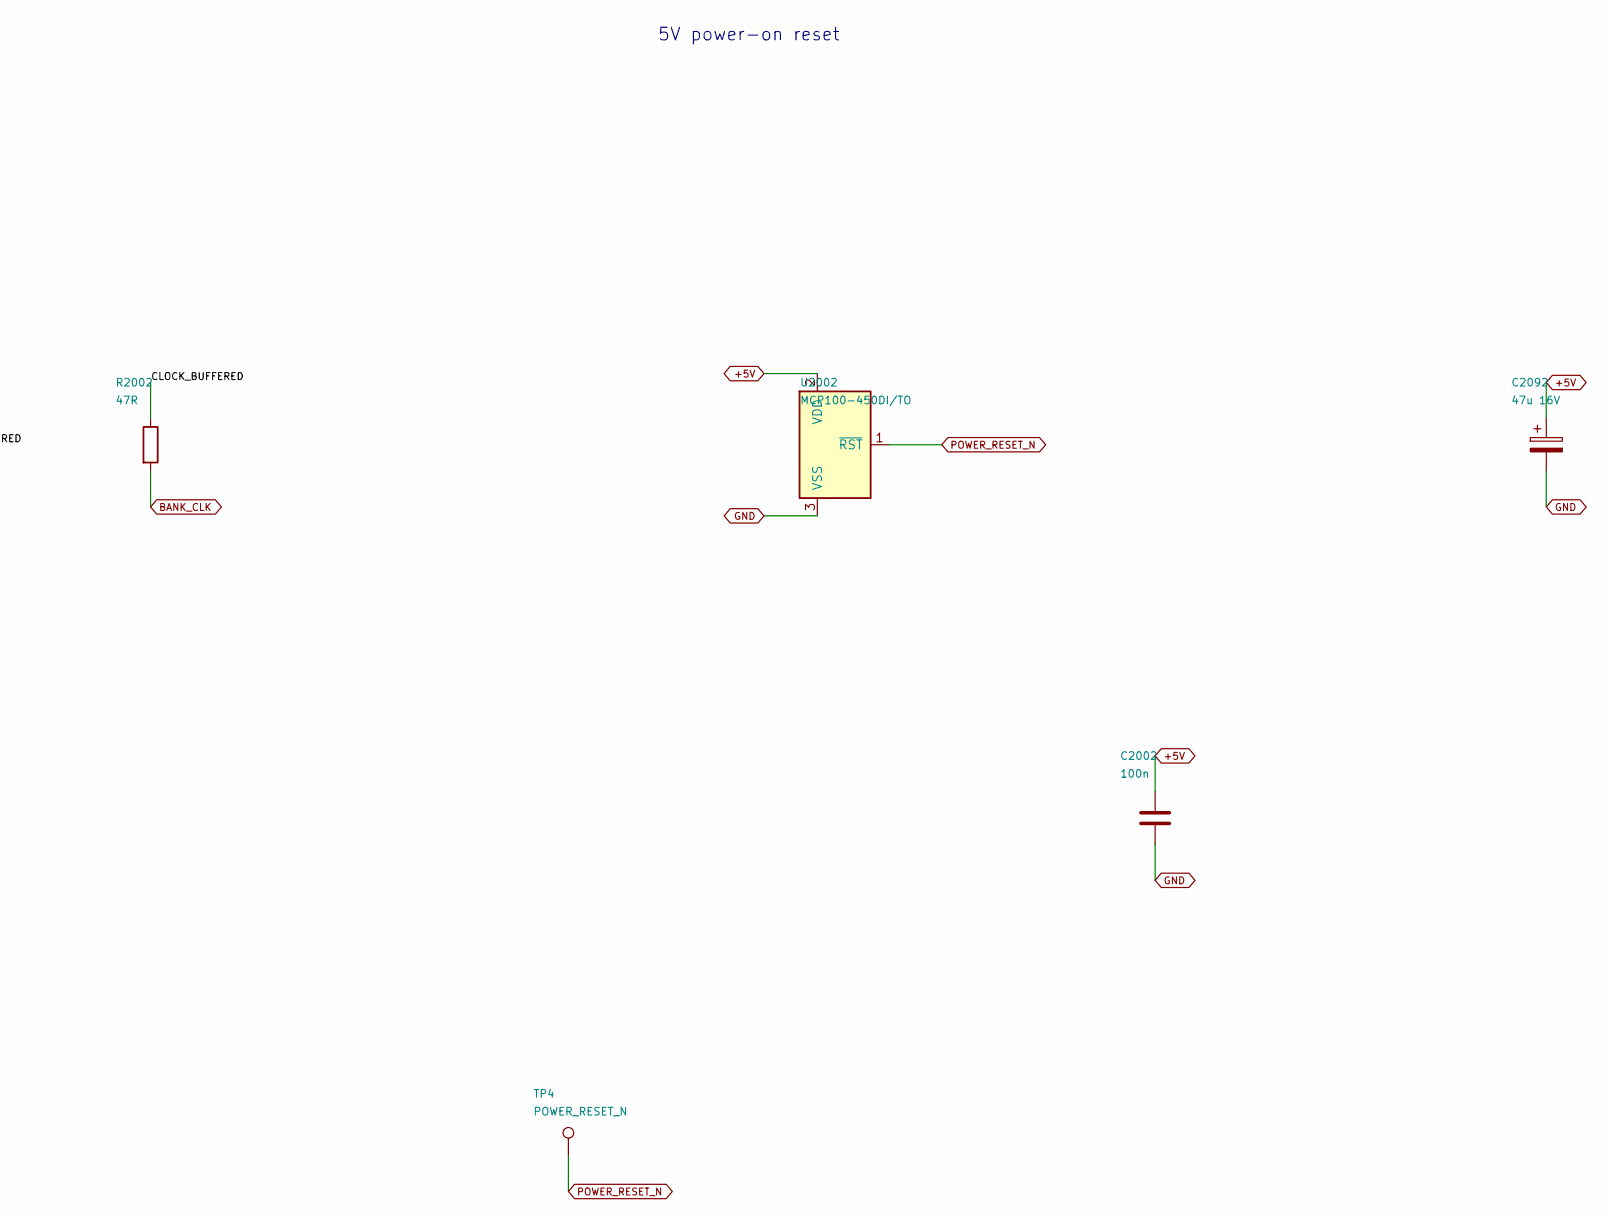
[picture p53: schematic power-clock.kicad_sch, Calculator - power and clock, part in row 1, column 2]

Parts:
C2000, C2001, C2002: 100n; C_0603_1608Metric
C2090: 1n C0G; C_0603_1608Metric
C2091: 10n; C_0603_1608Metric
C2092: 47u 16V; CP_Radial_D5.0mm_P2.00mm
R2000, R2001: 4.99k; R_0603_1608Metric
R2002: 47R; R_0603_1608Metric
TP1: +5V; TestPoint_Pad_D1.5mm
TP2: GND; TestPoint_Pad_D1.5mm
TP3: BANK_CLK; TestPoint_Pad_D1.5mm
TP4: POWER_RESET_N; TestPoint_Pad_D1.5mm
U2000: TLC555IDR; SOIC-8_3.9x4.9mm_P1.27mm
U2001: SN74LVC1G125DBVR; SOT-23-5
U2002: MCP100-450DI/TO; TO-92_Inline

Connections:
+5V: C2000.1, C2001.1, C2002.1, C2092.1, R2000.1, TP1.1, U2000.4 (~RST), U2000.8 (VCC), U2001.5 (VCC), U2002.2 (VDD); also elsewhere on the board
/Power and clock/CLOCK_BUFFERED: R2002.1, U2001.4
/Power and clock/CLOCK_CONTROL: C2091.1, U2000.5 (CONT)
/Power and clock/CLOCK_DISCHARGE: R2000.2, R2001.1, U2000.7 (DISCH)
/Power and clock/CLOCK_RAW: U2000.3 (OUT), U2001.2
/Power and clock/CLOCK_TIMING: C2090.1, R2001.2, U2000.2 (TRIG), U2000.6 (THRES)
BANK_CLK: R2002.2, TP3.1; also elsewhere on the board
GND: C2000.2, C2001.2, C2002.2, C2090.2, C2091.2, C2092.2, TP2.1, U2000.1 (GND), U2001.1, U2001.3 (GND), U2002.3 (VSS); also elsewhere on the board
POWER_RESET_N: TP4.1, U2002.1 (~RST); also elsewhere on the board

Notes on the sheet:
96 kHz nominal clock
5V power-on reset

Schematic: keypad.kicad_sch, Calculator - buttons and key encoding

Parts:
C2003, C2004: 100n; C_0603_1608Metric
D2004, D2009, D2012, D2013, D2018, D2020, D2022, D2025, D2026, D2028, D2029, D2030, D2035, D2036, D2039, D2041, D2043, D2044, D2045, D2047, D2050, D2051, D2052, D2054, D2055, D2057, D2058, D2059, D2060, D2061, D2062, D2063: BAT54HGWX; D_SOD-323
R2020, R2022, R2024, R2026, R2028, R2030, R2032, R2034, R2036, R2038, R2040, R2042, R2044, R2046, R2048, R2050: 3.3k 1%; R_0603_1608Metric
R2021, R2023, R2025, R2027, R2029, R2031, R2033, R2035, R2037, R2039, R2041, R2043, R2045, R2047, R2049, R2051, R2056: 1k 1%; R_0603_1608Metric
R2052, R2053, R2054, R2055, R2063, R2064: 10k; R_0603_1608Metric
R2057, R2058: 100k 1%; R_0603_1608Metric
R2059: 12k 1%; R_0603_1608Metric
R2060, R2061: 10k 1%; R_0603_1608Metric
R2062: 6.2k 1%; R_0603_1608Metric
SW1, SW2, SW3, SW4, SW5, SW6, SW7, SW8, SW9, SW10, SW11, SW12, SW13, SW14, SW15, SW16: PTS645SM43SMTR92 LFS; SW_SPST_PTS645Sx43SMTR92
U2003: LM393BDR; SOIC-8_3.9x4.9mm_P1.27mm
U2004: SN74HC14DR; SOIC-14_3.9x8.7mm_P1.27mm

Connections:
+5V: C2003.1, C2004.1, R2020.1, R2022.1, R2024.1, R2026.1, R2028.1, R2030.1, R2032.1, R2034.1, R2036.1, R2038.1, R2040.1, R2042.1, R2044.1, R2046.1, R2048.1, R2050.1, R2052.1, R2053.1, R2054.1, R2055.1, R2056.1, R2059.1, R2061.1, R2063.1, R2064.1, U2003.8 (V+), U2004.14 (VCC); also elsewhere on the board
/Keypad/BUTTON_0: R2020.2, R2021.1, SW1.1
/Keypad/BUTTON_1: D2004.1 (K), R2022.2, R2023.1, SW2.1
/Keypad/BUTTON_2: D2009.1 (K), R2024.2, R2025.1, SW3.1
/Keypad/BUTTON_3: D2012.1 (K), D2013.1 (K), R2026.2, R2027.1, SW4.1
/Keypad/BUTTON_4: D2018.1 (K), R2028.2, R2029.1, SW5.1
/Keypad/BUTTON_5: D2020.1 (K), D2022.1 (K), R2030.2, R2031.1, SW6.1
/Keypad/BUTTON_6: D2025.1 (K), D2026.1 (K), R2032.2, R2033.1, SW7.1
/Keypad/BUTTON_7: D2028.1 (K), D2029.1 (K), D2030.1 (K), R2034.2, R2035.1, SW8.1
/Keypad/BUTTON_8: D2035.1 (K), R2036.2, R2037.1, SW9.1
/Keypad/BUTTON_9: D2036.1 (K), D2039.1 (K), R2038.2, R2039.1, SW10.1
/Keypad/BUTTON_10: D2041.1 (K), D2043.1 (K), R2040.2, R2041.1, SW11.1
/Keypad/BUTTON_11: D2044.1 (K), D2045.1 (K), D2047.1 (K), R2042.2, R2043.1, SW12.1
/Keypad/BUTTON_12: D2050.1 (K), D2051.1 (K), R2044.2, R2045.1, SW13.1
/Keypad/BUTTON_13: D2052.1 (K), D2054.1 (K), D2055.1 (K), R2046.2, R2047.1, SW14.1
/Keypad/BUTTON_14: D2057.1 (K), D2058.1 (K), D2059.1 (K), R2048.2, R2049.1, SW15.1
/Keypad/BUTTON_15: D2060.1 (K), D2061.1 (K), D2062.1 (K), D2063.1 (K), R2050.2, R2051.1, SW16.1
/Keypad/KEY_ANY_N: R2063.2, U2003.1, U2004.11
/Keypad/KEY_ANY_REF: R2059.2, R2060.1, U2003.2 (-)
/Keypad/KEY_CODE_N_0: D2004.2 (A), D2012.2 (A), D2020.2 (A), D2028.2 (A), D2036.2 (A), D2044.2 (A), D2052.2 (A), D2060.2 (A), R2052.2, U2004.1
/Keypad/KEY_CODE_N_1: D2009.2 (A), D2013.2 (A), D2025.2 (A), D2029.2 (A), D2041.2 (A), D2045.2 (A), D2057.2 (A), D2061.2 (A), R2053.2, U2004.3
/Keypad/KEY_CODE_N_2: D2018.2 (A), D2022.2 (A), D2026.2 (A), D2030.2 (A), D2050.2 (A), D2054.2 (A), D2058.2 (A), D2062.2 (A), R2054.2, U2004.5
/Keypad/KEY_CODE_N_3: D2035.2 (A), D2039.2 (A), D2043.2 (A), D2047.2 (A), D2051.2 (A), D2055.2 (A), D2059.2 (A), D2063.2 (A), R2055.2, U2004.9
/Keypad/KEY_MULTI_N: R2064.2, U2003.7, U2004.13
/Keypad/KEY_MULTI_REF: R2061.2, R2062.1, U2003.6 (-)
/Keypad/KEY_SENSE: R2021.2, R2023.2, R2025.2, R2027.2, R2029.2, R2031.2, R2033.2, R2035.2, R2037.2, R2039.2, R2041.2, R2043.2, R2045.2, R2047.2, R2049.2, R2051.2, R2056.2, R2057.1
/Keypad/KEY_SENSE_HALF: R2057.2, R2058.1, U2003.3 (+), U2003.5 (+)
GND: C2003.2, C2004.2, R2058.2, R2060.2, R2062.2, SW1.2, SW2.2, SW3.2, SW4.2, SW5.2, SW6.2, SW7.2, SW8.2, SW9.2, SW10.2, SW11.2, SW12.2, SW13.2, SW14.2, SW15.2, SW16.2, U2003.4 (V-), U2004.7 (GND); also elsewhere on the board
KEY_RAW_0: U2004.2; also elsewhere on the board
KEY_RAW_1: U2004.4; also elsewhere on the board
KEY_RAW_2: U2004.6; also elsewhere on the board
KEY_RAW_3: U2004.8; also elsewhere on the board
KEY_RAW_4: U2004.10; also elsewhere on the board
KEY_RAW_5: U2004.12; also elsewhere on the board

Notes on the sheet:
Key 0
Key 1
Key 2
Key 3
Key 4
Key 5
Key 6
Key 7
Key 8
Key 9
Key +
Key -
Key *
Key /
Key =
Key C

Schematic: key-control.kicad_sch, Calculator - debounce and entry

Parts:
C2010, C2011, C2012, C2013, C2014, C2015, C2016, C2017, C2018, C2201, C2202, C2203, C2204, C2205, C2206, C2207, C2208, C2209, C2210, C2211, C2212, C2213, C2214, C2215, C2216, C2217, C2218, C2219, C2220, C2221, C2222: 100n; C_0603_1608Metric
U2010, U2011: SN74HC174DR; SOIC-16_3.9x9.9mm_P1.27mm
U2012: SN74HC688DWR; SOIC-20W_7.5x12.8mm_P1.27mm
U2013: SN74HC4040DR; SOIC-16_3.9x9.9mm_P1.27mm
U2014, U2015: SN74HC74DR; SOIC-14_3.9x8.7mm_P1.27mm
U2016: SN74HC163DR; SOIC-16_3.9x9.9mm_P1.27mm
U2017, U2018: CD74HC173M96; SOIC-16_3.9x9.9mm_P1.27mm
U2201, U2206, U2210, U2215, U2218, U2221: SN74HC04PWR; TSSOP-14_4.4x5mm_P0.65mm
U2202, U2207, U2214, U2220: SN74HC32PWR; TSSOP-14_4.4x5mm_P0.65mm
U2203, U2211, U2216, U2219: SN74HC10DR; SOIC-14_3.9x8.7mm_P1.27mm
U2204, U2213, U2217: SN74HC08PWR; TSSOP-14_4.4x5mm_P0.65mm
U2205, U2208: CD74HC30M96; SOIC-14_3.9x8.7mm_P1.27mm
U2209: CD74HC27M96; SOIC-14_3.9x8.7mm_P1.27mm
U2212: SN74HC20DR; SOIC-14_3.9x8.7mm_P1.27mm
U2222: SN74HC00PWR; TSSOP-14_4.4x5mm_P0.65mm

Connections:
+5V: C2010.1, C2011.1, C2012.1, C2013.1, C2014.1, C2015.1, C2016.1, C2017.1, C2018.1, C2201.1, C2202.1, C2203.1, C2204.1, C2205.1, C2206.1, C2207.1, C2208.1, C2209.1, C2210.1, C2211.1, C2212.1, C2213.1, C2214.1, C2215.1, C2216.1, C2217.1, C2218.1, C2219.1, C2220.1, C2221.1, C2222.1, U2010.16 (VCC), U2011.16 (VCC), U2012.20 (VCC), U2013.16 (VDD), U2014.4 (~S), U2014.10 (~S), U2014.14 (VCC), U2015.4 (~S), U2015.10 (~S), U2015.14 (VCC), U2016.6 (D3), U2016.10 (CET), U2016.16 (VCC), U2017.12 (D2), U2017.16 (VCC), U2018.16 (VCC), U2201.14 (VCC), U2202.14 (VCC), U2203.14 (VCC), U2204.14 (VCC), U2205.6, U2205.11, U2205.12, U2205.14 (VCC), U2206.14 (VCC), U2207.14 (VCC), U2208.6, U2208.11, U2208.12, U2208.14 (VCC), U2209.14 (VCC), U2210.14 (VCC), U2211.14 (VCC), U2212.14 (VCC), U2213.14 (VCC), U2214.14 (VCC), U2215.14 (VCC), U2216.14 (VCC), U2217.14 (VCC), U2218.14 (VCC), U2219.14 (VCC), U2220.14 (VCC), U2221.14 (VCC), U2222.14 (VCC); also elsewhere on the board
/Key control/APPEND_DIGIT: U2213.4, U2213.9, U2215.2, U2220.9
/Key control/DIGIT_LOW_RANGE: U2207.5, U2209.12
/Key control/ENTRY_COUNT_0: U2016.3 (D0), U2016.14 (Q0), U2207.12
/Key control/ENTRY_COUNT_1: U2016.4 (D1), U2016.13 (Q1), U2207.13
/Key control/ENTRY_COUNT_2: U2016.5 (D2), U2016.12 (Q2), U2210.13, U2214.2, U2216.13
/Key control/ENTRY_COUNT_INC: U2016.7 (CEP), U2222.3
/Key control/ENTRY_COUNT_RESET: U2220.6, U2221.3
/Key control/ENTRY_COUNT_RESET_N: U2016.1 (~MR), U2221.4
/Key control/ENTRY_HAS_DIGITS: U2212.13, U2213.12, U2214.3, U2215.9
/Key control/ENTRY_HAS_DIGITS_OR_37: U2207.11, U2214.1
/Key control/ENTRY_RESET: U2017.15 (Mr), U2214.11, U2220.4, U2221.1
/Key control/ENTRY_RESET_OR_66: U2214.8, U2214.12
/Key control/FIFTH_DIGIT_N: U2016.9 (~PE), U2216.12
/Key control/FIRST_OPERATOR: U2213.11, U2214.4
/Key control/IS_ADD_SUB: U2206.12, U2207.9
/Key control/IS_DIGIT: U2207.6, U2211.4, U2211.10, U2216.2
/Key control/IS_EQUALS: U2210.8, U2212.10
/Key control/IS_MUL_DIV: U2207.10, U2210.4
/Key control/IS_OPERATOR: U2207.8, U2216.4
/Key control/KEY_BLOCKED: U2015.5 (Q), U2201.13, U2207.1
/Key control/KEY_BLOCKED_D: U2015.2 (D), U2204.8
/Key control/KEY_DISARMED: U2014.9 (Q), U2201.11, U2202.12
/Key control/KEY_DISARMED_D: U2014.12 (D), U2204.6
/Key control/KEY_ENTRY_READY: U2211.3, U2212.9, U2213.3, U2216.1, U2216.3
/Key control/KEY_EQUAL_N: U2012.19 (P=R), U2201.1, U2202.1
/Key control/KEY_HOLD_BLOCKED: U2204.9, U2207.3
/Key control/KEY_HOLD_DISARMED: U2202.11, U2204.4
/Key control/KEY_MATCH: U2201.2, U2203.1
/Key control/KEY_OFFER: U2202.13, U2204.12, U2206.2, U2208.1
/Key control/KEY_READY: U2204.11, U2211.9, U2213.1
/Key control/KEY_RELEASE_N: U2203.6, U2204.5, U2204.10
/Key control/KEY_SAMPLE_0_0: U2010.2 (Q0), U2011.3 (D0), U2012.2 (P0)
/Key control/KEY_SAMPLE_0_1: U2010.5 (Q1), U2011.4 (D1), U2012.4 (P1)
/Key control/KEY_SAMPLE_0_2: U2010.7 (Q2), U2011.6 (D2), U2012.6 (P2)
/Key control/KEY_SAMPLE_0_3: U2010.10 (Q3), U2011.11 (D3), U2012.8 (P3)
/Key control/KEY_SAMPLE_0_4: U2010.12 (Q4), U2011.13 (D4), U2012.11 (P4)
/Key control/KEY_SAMPLE_0_5: U2010.15 (Q5), U2011.14 (D5), U2012.13 (P5)
/Key control/KEY_SAMPLE_1_0: U2011.2 (Q0), U2012.3 (R0), U2017.14 (D0), U2018.14 (D0), U2208.2, U2210.5
/Key control/KEY_SAMPLE_1_1: U2011.5 (Q1), U2012.5 (R1), U2018.13 (D1), U2203.11, U2208.3, U2209.2, U2210.1, U2212.4
/Key control/KEY_SAMPLE_1_2: U2011.7 (Q2), U2012.7 (R2), U2017.13 (D1), U2018.12 (D2), U2206.11, U2208.4, U2209.1, U2211.2, U2212.2
/Key control/KEY_SAMPLE_1_3: U2011.10 (Q3), U2012.9 (R3), U2018.11 (D3), U2203.9, U2206.9, U2208.5, U2211.1, U2212.1
/Key control/KEY_SAMPLE_1_4: U2011.12 (Q4), U2012.12 (R4), U2205.3, U2206.3
/Key control/KEY_SAMPLE_1_5: U2011.15 (Q5), U2012.14 (R5), U2201.5, U2202.2, U2207.2
/Key control/KEY_SAMPLE_VALID: U2201.8, U2203.3, U2204.2, U2205.1
/Key control/KEY_STABLE: U2014.5 (Q), U2202.9, U2203.4, U2205.2
/Key control/KEY_STABLE_D: U2014.2 (D), U2204.3
/Key control/KEY_STABLE_OR_TIME: U2202.8, U2204.1
/Key control/KEY_TIMER_RESET: U2013.11 (Reset), U2202.6
/Key control/KEY_TIMER_RESET_OR_2: U2202.3, U2202.4
/Key control/KEY_TIME_HIGH: U2013.1 (Q11), U2202.10
/Key control/N_APPEND_DIGIT: U2211.6, U2215.1
/Key control/N_CANCEL: U2206.5, U2208.8
/Key control/N_ENTRY_COUNT_2: U2210.12, U2211.5
/Key control/N_ENTRY_HAS_DIGITS: U2215.8, U2217.1
/Key control/N_ENTRY_RESET: U2217.5, U2221.2
/Key control/N_IS_ADD_SUB: U2203.8, U2206.13
/Key control/N_IS_EQUALS: U2210.9, U2212.6
/Key control/N_IS_MUL_DIV: U2210.3, U2211.12
/Key control/N_KEY_BLOCKED: U2201.12, U2205.5
/Key control/N_KEY_DISARMED: U2201.10, U2205.4
/Key control/N_KEY_OFFER: U2205.8, U2206.1
/Key control/N_KEY_SAMPLE_1_0: U2210.6, U2212.5
/Key control/N_KEY_SAMPLE_1_1: U2210.2, U2211.13
/Key control/N_KEY_SAMPLE_1_2: U2203.10, U2206.10
/Key control/N_KEY_SAMPLE_1_3: U2206.8, U2207.4
/Key control/N_KEY_SAMPLE_1_4: U2203.5, U2206.4
/Key control/N_KEY_SAMPLE_1_5: U2201.6, U2203.2
/Key control/N_KEY_SAMPLE_VALID: U2201.9, U2203.12
/Key control/N_NEW_ENTRY: U2211.8, U2215.5
/Key control/N_OP_ACCEPT: U2017.9 (E1), U2215.11, U2216.6
/Key control/N_OP_BIT_0: U2216.10, U2218.2, U2219.4
/Key control/N_OP_BIT_1: U2216.11, U2218.4, U2219.13
/Key control/N_OP_VALID: U2213.5, U2213.13, U2215.4
/Key control/N_POWER_RESET_N: U2018.15 (Mr), U2201.4, U2202.5, U2214.9
/Key control/N_RESULT_DONE: U2210.10, U2213.2
/Key control/N_SAVE_KEY_DIGIT: U2018.9 (E1), U2221.6
/Key control/N_START_ADD: U2216.8, U2218.5
/Key control/N_START_CALC: U2212.8, U2215.13
/Key control/N_START_DIV: U2218.13, U2219.8
/Key control/N_START_MUL: U2218.11, U2219.6
/Key control/N_START_SUB: U2218.9, U2219.12
/Key control/OP_ACCEPT: U2215.10, U2220.5
/Key control/OP_BIT_0: U2017.3 (Q0), U2218.1, U2219.2, U2219.10
/Key control/OP_BIT_1: U2017.4 (Q1), U2218.3, U2219.5, U2219.11
/Key control/OP_POSITION_OK: U2214.6, U2216.5
/Key control/OP_VALID: U2017.5 (Q2), U2212.12, U2213.10, U2215.3, U2217.2
/Key control/REPLACE_OPERATOR: U2214.5, U2217.3
/Key control/RESULT_DONE: U2015.9 (Q), U2210.11, U2211.11, U2220.1
/Key control/RESULT_DONE_D: U2015.12 (D), U2217.6
/Key control/RESULT_DONE_HOLD: U2217.4, U2220.3
/Key control/SAVE_KEY_DIGIT: U2220.8, U2221.5
/Key control/START_CALC: U2215.12, U2216.9, U2219.1, U2219.3, U2219.9
BANK_CLK: U2010.9 (Cp), U2011.9 (Cp), U2013.10 (CLK), U2014.3 (C), U2014.11 (C), U2015.3 (C), U2015.11 (C), U2016.2 (CP), U2017.7 (Cp), U2018.7 (Cp); also elsewhere on the board
CANCEL: U2206.6, U2214.10; also elsewhere on the board
ENTER_A: U2213.6; also elsewhere on the board
ENTER_B: U2213.8; also elsewhere on the board
GND: C2010.2, C2011.2, C2012.2, C2013.2, C2014.2, C2015.2, C2016.2, C2017.2, C2018.2, C2201.2, C2202.2, C2203.2, C2204.2, C2205.2, C2206.2, C2207.2, C2208.2, C2209.2, C2210.2, C2211.2, C2212.2, C2213.2, C2214.2, C2215.2, C2216.2, C2217.2, C2218.2, C2219.2, C2220.2, C2221.2, C2222.2, U2010.8 (GND), U2011.8 (GND), U2012.1 (G), U2012.10 (GND), U2012.15 (P6), U2012.16 (R6), U2012.17 (P7), U2012.18 (R7), U2013.8 (VSS), U2014.7 (GND), U2015.7 (GND), U2016.8 (GND), U2017.1 (Oe1), U2017.2 (Oe2), U2017.8 (GND), U2017.10 (E2), U2017.11 (D3), U2018.1 (Oe1), U2018.2 (Oe2), U2018.8 (GND), U2018.10 (E2), U2201.7 (GND), U2202.7 (GND), U2203.7 (GND), U2204.7 (GND), U2205.7 (GND), U2206.7 (GND), U2207.7 (GND), U2208.7 (GND), U2209.3, U2209.4, U2209.5, U2209.7 (GND), U2209.9, U2209.10, U2209.11, U2209.13, U2210.7 (GND), U2211.7 (GND), U2212.7 (GND), U2213.7 (GND), U2214.7 (GND), U2215.7 (GND), U2216.7 (GND), U2217.7 (GND), U2217.12, U2217.13, U2218.7 (GND), U2219.7 (GND), U2220.7 (GND), U2220.12, U2220.13, U2221.7 (GND), U2221.9, U2221.11, U2221.13, U2222.4, U2222.5, U2222.7 (GND), U2222.9, U2222.10, U2222.12, U2222.13; also elsewhere on the board
IDLE_READY: U2204.13; also elsewhere on the board
INPUT_FULL: U2016.11 (Q3); also elsewhere on the board
KEY_DIGIT_0: U2018.3 (Q0); also elsewhere on the board
KEY_DIGIT_1: U2018.4 (Q1); also elsewhere on the board
KEY_DIGIT_2: U2018.5 (Q2); also elsewhere on the board
KEY_DIGIT_3: U2018.6 (Q3); also elsewhere on the board
KEY_RAW_0: U2010.3 (D0); also elsewhere on the board
KEY_RAW_1: U2010.4 (D1); also elsewhere on the board
KEY_RAW_2: U2010.6 (D2); also elsewhere on the board
KEY_RAW_3: U2010.11 (D3); also elsewhere on the board
KEY_RAW_4: U2010.13 (D4); also elsewhere on the board
KEY_RAW_5: U2010.14 (D5); also elsewhere on the board
NEW_ENTRY: U2214.13, U2215.6, U2220.10; also elsewhere on the board
POWER_RESET_N: U2010.1 (~Mr), U2011.1 (~Mr), U2014.1 (~R), U2014.13 (~R), U2015.1 (~R), U2015.13 (~R), U2201.3, U2203.13; also elsewhere on the board
RESULT_FINISHED: U2220.2; also elsewhere on the board
START_ADD: U2218.6; also elsewhere on the board
START_DIV: U2218.12; also elsewhere on the board
START_MUL: U2218.10; also elsewhere on the board
START_SUB: U2218.8; also elsewhere on the board
S_E_SHIFT_A_N: U2222.1; also elsewhere on the board
S_E_SHIFT_B_N: U2222.2; also elsewhere on the board

Notes on the sheet:
Gate power and local decoupling

Schematic: display-panel.kicad_sch, Calculator - display and indicators

Parts:
C2050, C2051, C2052, C2053, C2054, C2055: 100n; C_0603_1608Metric
D2200, D2201, D2202: Red 3mm; LED_D3.0mm
DS1, DS2, DS3, DS4, DS5, DS6, DS7: FJ5161AH; 7SegmentLED_LTS6760_LTS6780
R2100, R2101, R2102, R2103, R2104, R2105, R2106, R2107, R2108, R2109, R2110, R2111, R2112, R2113, R2114, R2115, R2116, R2117, R2118, R2119, R2120, R2121, R2122, R2123, R2124, R2125, R2126, R2127, R2128, R2129, R2130, R2131, R2132, R2133, R2134, R2135, R2136, R2137, R2138, R2139, R2140, R2141, R2142, R2143, R2144, R2145, R2146: 1k; R_0603_1608Metric
U2050, U2051, U2052, U2053, U2054, U2055: CD74HC4511M96; SOIC-16_3.9x9.9mm_P1.27mm
U2217: SN74HC08PWR; TSSOP-14_4.4x5mm_P0.65mm

Connections:
+5V: C2050.1, C2051.1, C2052.1, C2053.1, C2054.1, C2055.1, U2050.3 (~LT), U2050.16 (Vdd), U2051.3 (~LT), U2051.16 (Vdd), U2052.3 (~LT), U2052.16 (Vdd), U2053.3 (~LT), U2053.16 (Vdd), U2054.3 (~LT), U2054.16 (Vdd), U2055.3 (~LT), U2055.16 (Vdd); also elsewhere on the board
/Display and indicators/DISPLAY_DP_LIMITED: DS3.5 (DP), R2142.2
/Display and indicators/MINUS_SEGMENT: DS7.10 (G), R2143.2
/Display and indicators/SEG_0_A: DS1.7 (A), R2100.2
/Display and indicators/SEG_0_A_DRIVE: R2100.1, U2050.13 (Qa)
/Display and indicators/SEG_0_B: DS1.6 (B), R2101.2
/Display and indicators/SEG_0_B_DRIVE: R2101.1, U2050.12 (Qb)
/Display and indicators/SEG_0_C: DS1.4 (C), R2102.2
/Display and indicators/SEG_0_C_DRIVE: R2102.1, U2050.11 (Qc)
/Display and indicators/SEG_0_D: DS1.2 (D), R2103.2
/Display and indicators/SEG_0_D_DRIVE: R2103.1, U2050.10 (Qd)
/Display and indicators/SEG_0_E: DS1.1 (E), R2104.2
/Display and indicators/SEG_0_E_DRIVE: R2104.1, U2050.9 (Qe)
/Display and indicators/SEG_0_F: DS1.9 (F), R2105.2
/Display and indicators/SEG_0_F_DRIVE: R2105.1, U2050.15 (Qf)
/Display and indicators/SEG_0_G: DS1.10 (G), R2106.2
/Display and indicators/SEG_0_G_DRIVE: R2106.1, U2050.14 (Qg)
/Display and indicators/SEG_1_A: DS2.7 (A), R2107.2
/Display and indicators/SEG_1_A_DRIVE: R2107.1, U2051.13 (Qa)
/Display and indicators/SEG_1_B: DS2.6 (B), R2108.2
/Display and indicators/SEG_1_B_DRIVE: R2108.1, U2051.12 (Qb)
/Display and indicators/SEG_1_C: DS2.4 (C), R2109.2
/Display and indicators/SEG_1_C_DRIVE: R2109.1, U2051.11 (Qc)
/Display and indicators/SEG_1_D: DS2.2 (D), R2110.2
/Display and indicators/SEG_1_D_DRIVE: R2110.1, U2051.10 (Qd)
/Display and indicators/SEG_1_E: DS2.1 (E), R2111.2
/Display and indicators/SEG_1_E_DRIVE: R2111.1, U2051.9 (Qe)
/Display and indicators/SEG_1_F: DS2.9 (F), R2112.2
/Display and indicators/SEG_1_F_DRIVE: R2112.1, U2051.15 (Qf)
/Display and indicators/SEG_1_G: DS2.10 (G), R2113.2
/Display and indicators/SEG_1_G_DRIVE: R2113.1, U2051.14 (Qg)
/Display and indicators/SEG_2_A: DS3.7 (A), R2114.2
/Display and indicators/SEG_2_A_DRIVE: R2114.1, U2052.13 (Qa)
/Display and indicators/SEG_2_B: DS3.6 (B), R2115.2
/Display and indicators/SEG_2_B_DRIVE: R2115.1, U2052.12 (Qb)
/Display and indicators/SEG_2_C: DS3.4 (C), R2116.2
/Display and indicators/SEG_2_C_DRIVE: R2116.1, U2052.11 (Qc)
/Display and indicators/SEG_2_D: DS3.2 (D), R2117.2
/Display and indicators/SEG_2_D_DRIVE: R2117.1, U2052.10 (Qd)
/Display and indicators/SEG_2_E: DS3.1 (E), R2118.2
/Display and indicators/SEG_2_E_DRIVE: R2118.1, U2052.9 (Qe)
/Display and indicators/SEG_2_F: DS3.9 (F), R2119.2
/Display and indicators/SEG_2_F_DRIVE: R2119.1, U2052.15 (Qf)
/Display and indicators/SEG_2_G: DS3.10 (G), R2120.2
/Display and indicators/SEG_2_G_DRIVE: R2120.1, U2052.14 (Qg)
/Display and indicators/SEG_3_A: DS4.7 (A), R2121.2
/Display and indicators/SEG_3_A_DRIVE: R2121.1, U2053.13 (Qa)
/Display and indicators/SEG_3_B: DS4.6 (B), R2122.2
/Display and indicators/SEG_3_B_DRIVE: R2122.1, U2053.12 (Qb)
/Display and indicators/SEG_3_C: DS4.4 (C), R2123.2
/Display and indicators/SEG_3_C_DRIVE: R2123.1, U2053.11 (Qc)
/Display and indicators/SEG_3_D: DS4.2 (D), R2124.2
/Display and indicators/SEG_3_D_DRIVE: R2124.1, U2053.10 (Qd)
/Display and indicators/SEG_3_E: DS4.1 (E), R2125.2
/Display and indicators/SEG_3_E_DRIVE: R2125.1, U2053.9 (Qe)
/Display and indicators/SEG_3_F: DS4.9 (F), R2126.2
/Display and indicators/SEG_3_F_DRIVE: R2126.1, U2053.15 (Qf)
/Display and indicators/SEG_3_G: DS4.10 (G), R2127.2
/Display and indicators/SEG_3_G_DRIVE: R2127.1, U2053.14 (Qg)
/Display and indicators/SEG_4_A: DS5.7 (A), R2128.2
/Display and indicators/SEG_4_A_DRIVE: R2128.1, U2054.13 (Qa)
/Display and indicators/SEG_4_B: DS5.6 (B), R2129.2
/Display and indicators/SEG_4_B_DRIVE: R2129.1, U2054.12 (Qb)
/Display and indicators/SEG_4_C: DS5.4 (C), R2130.2
/Display and indicators/SEG_4_C_DRIVE: R2130.1, U2054.11 (Qc)
/Display and indicators/SEG_4_D: DS5.2 (D), R2131.2
/Display and indicators/SEG_4_D_DRIVE: R2131.1, U2054.10 (Qd)
/Display and indicators/SEG_4_E: DS5.1 (E), R2132.2
/Display and indicators/SEG_4_E_DRIVE: R2132.1, U2054.9 (Qe)
/Display and indicators/SEG_4_F: DS5.9 (F), R2133.2
/Display and indicators/SEG_4_F_DRIVE: R2133.1, U2054.15 (Qf)
/Display and indicators/SEG_4_G: DS5.10 (G), R2134.2
/Display and indicators/SEG_4_G_DRIVE: R2134.1, U2054.14 (Qg)
/Display and indicators/SEG_5_A: DS6.7 (A), R2135.2
/Display and indicators/SEG_5_A_DRIVE: R2135.1, U2055.13 (Qa)
/Display and indicators/SEG_5_B: DS6.6 (B), R2136.2
/Display and indicators/SEG_5_B_DRIVE: R2136.1, U2055.12 (Qb)
/Display and indicators/SEG_5_C: DS6.4 (C), R2137.2
/Display and indicators/SEG_5_C_DRIVE: R2137.1, U2055.11 (Qc)
/Display and indicators/SEG_5_D: DS6.2 (D), R2138.2
/Display and indicators/SEG_5_D_DRIVE: R2138.1, U2055.10 (Qd)
/Display and indicators/SEG_5_E: DS6.1 (E), R2139.2
/Display and indicators/SEG_5_E_DRIVE: R2139.1, U2055.9 (Qe)
/Display and indicators/SEG_5_F: DS6.9 (F), R2140.2
/Display and indicators/SEG_5_F_DRIVE: R2140.1, U2055.15 (Qf)
/Display and indicators/SEG_5_G: DS6.10 (G), R2141.2
/Display and indicators/SEG_5_G_DRIVE: R2141.1, U2055.14 (Qg)
/Display and indicators/STATUS_LED_0: D2200.2 (A), R2144.2
/Display and indicators/STATUS_LED_1: D2201.2 (A), R2145.2
/Display and indicators/STATUS_LED_2: D2202.2 (A), R2146.2
DISPLAY_BL_N_0: U2050.4 (~BI); also elsewhere on the board
DISPLAY_BL_N_1: U2051.4 (~BI); also elsewhere on the board
DISPLAY_BL_N_2: U2052.4 (~BI); also elsewhere on the board
DISPLAY_BL_N_3: U2053.4 (~BI); also elsewhere on the board
DISPLAY_BL_N_4: U2054.4 (~BI); also elsewhere on the board
DISPLAY_BL_N_5: U2055.4 (~BI); also elsewhere on the board
DISPLAY_DATA_0: U2050.7 (DA), U2051.7 (DA), U2052.7 (DA), U2053.7 (DA), U2054.7 (DA), U2055.7 (DA); also elsewhere on the board
DISPLAY_DATA_1: U2050.1 (DB), U2051.1 (DB), U2052.1 (DB), U2053.1 (DB), U2054.1 (DB), U2055.1 (DB); also elsewhere on the board
DISPLAY_DATA_2: U2050.2 (DC), U2051.2 (DC), U2052.2 (DC), U2053.2 (DC), U2054.2 (DC), U2055.2 (DC); also elsewhere on the board
DISPLAY_DATA_3: U2050.6 (DD), U2051.6 (DD), U2052.6 (DD), U2053.6 (DD), U2054.6 (DD), U2055.6 (DD); also elsewhere on the board
DISPLAY_DP: R2142.1; also elsewhere on the board
DISPLAY_LE_N_0: U2050.5 (~EL); also elsewhere on the board
DISPLAY_LE_N_1: U2051.5 (~EL); also elsewhere on the board
DISPLAY_LE_N_2: U2052.5 (~EL); also elsewhere on the board
DISPLAY_LE_N_3: U2053.5 (~EL); also elsewhere on the board
DISPLAY_LE_N_4: U2054.5 (~EL); also elsewhere on the board
DISPLAY_LE_N_5: U2055.5 (~EL); also elsewhere on the board
DIV_ZERO_INDICATOR: R2145.1; also elsewhere on the board
GND: C2050.2, C2051.2, C2052.2, C2053.2, C2054.2, C2055.2, D2200.1 (K), D2201.1 (K), D2202.1 (K), DS1.3 (CC), DS1.8 (CC), DS2.3 (CC), DS2.8 (CC), DS3.3 (CC), DS3.8 (CC), DS4.3 (CC), DS4.8 (CC), DS5.3 (CC), DS5.8 (CC), DS6.3 (CC), DS6.8 (CC), DS7.3 (CC), DS7.8 (CC), U2050.8 (Vss), U2051.8 (Vss), U2052.8 (Vss), U2053.8 (Vss), U2054.8 (Vss), U2055.8 (Vss); also elsewhere on the board
INPUT_FULL: R2146.1; also elsewhere on the board
NEGATIVE_SEGMENT: R2143.1, U2217.8
OVERFLOW_INDICATOR: R2144.1; also elsewhere on the board
SIGN_FLAG: U2217.9; also elsewhere on the board
STATUS_VISIBLE: U2217.10; also elsewhere on the board
