EwoudVV/calculator/calculator.kicad_pcb

## KiCad design calculator.kicad_pcb (continued)

Schematic: controller-branches.kicad_sch, Calculator - next state and branch gates

Parts:
C1001, C1002, C1003, C1004, C1005, C1006, C1007, C1008, C1009, C1010, C1011, C1012, C1024, C1025, C1027, C1028, C1029, C1030, C1031, C1032, C1033, C1034: 100n; C_0603_1608Metric
U1001, U1004, U1023, U1028: SN74HC04PWR; TSSOP-14_4.4x5mm_P0.65mm
U1002, U1032: SN74HC08PWR; TSSOP-14_4.4x5mm_P0.65mm
U1003, U1007, U1008, U1009, U1010, U1012: SN74HC32PWR; TSSOP-14_4.4x5mm_P0.65mm
U1005, U1006, U1030: SN74HC00PWR; TSSOP-14_4.4x5mm_P0.65mm
U1011: CD74HC27M96; SOIC-14_3.9x8.7mm_P1.27mm
U1017: SN74HC10DR; SOIC-14_3.9x8.7mm_P1.27mm
U1024, U1025, U1033, U1034: CD74HC30M96; SOIC-14_3.9x8.7mm_P1.27mm
U1027, U1029, U1031: SN74HC20DR; SOIC-14_3.9x8.7mm_P1.27mm

Connections:
+5V: C1001.1, C1002.1, C1003.1, C1004.1, C1005.1, C1006.1, C1007.1, C1008.1, C1009.1, C1010.1, C1011.1, C1012.1, C1024.1, C1025.1, C1027.1, C1028.1, C1029.1, C1030.1, C1031.1, C1032.1, C1033.1, C1034.1, U1001.14 (VCC), U1002.14 (VCC), U1003.14 (VCC), U1004.14 (VCC), U1005.14 (VCC), U1006.14 (VCC), U1007.14 (VCC), U1008.14 (VCC), U1009.14 (VCC), U1010.14 (VCC), U1011.14 (VCC), U1012.14 (VCC), U1024.14 (VCC), U1025.12, U1025.14 (VCC), U1027.14 (VCC), U1028.14 (VCC), U1029.14 (VCC), U1030.14 (VCC), U1031.14 (VCC), U1032.2, U1032.14 (VCC), U1033.14 (VCC), U1034.12, U1034.14 (VCC); also elsewhere on the board
/Main controller/Branch decisions/ADVANCE_REQUEST: U1002.9, U1012.3
/Main controller/Branch decisions/ADVANCE_REQUEST_OR_36: U1010.6, U1010.12
/Main controller/Branch decisions/ADVANCE_REQUEST_OR_37: U1010.8, U1010.13
/Main controller/Branch decisions/ADVANCE_REQUEST_OR_38: U1010.11, U1012.1
/Main controller/Branch decisions/ANY_COMMAND: U1010.9, U1031.6
/Main controller/Branch decisions/CONTROLLER_POWER_RESET: U1001.10, U1003.9
/Main controller/Branch decisions/FORCE_CLEAR_OR_9: U1003.8, U1003.12
/Main controller/Branch decisions/INVALID_CODE_OR_7: U1003.3, U1003.4
/Main controller/Branch decisions/INVALID_LOW_CODE: U1003.1, U1029.8
/Main controller/Branch decisions/JUMP_SELECTED: U1002.12, U1030.6
/Main controller/Branch decisions/JUMP_SELECTED_GROUP_0: U1028.11, U1033.8
/Main controller/Branch decisions/JUMP_SELECTED_GROUP_1: U1028.13, U1034.8
/Main controller/Branch decisions/LOAD_BRANCH: U1002.11, U1012.5
/Main controller/Branch decisions/LOAD_REQUEST: U1004.9, U1012.6
/Main controller/Branch decisions/N_CANCEL: U1001.12, U1002.2
/Main controller/Branch decisions/N_CARRY_FLAG: U1001.2, U1007.10, U1008.5
/Main controller/Branch decisions/N_DIV_STAGE_LAST: U1001.8
/Main controller/Branch decisions/N_JUMP_SELECTED_GROUP_0: U1028.10, U1030.4
/Main controller/Branch decisions/N_JUMP_SELECTED_GROUP_1: U1028.12, U1030.5
/Main controller/Branch decisions/N_SHARED_PRODUCT_1_N_GROUP_0: U1006.12, U1023.4
/Main controller/Branch decisions/N_SHARED_PRODUCT_1_N_GROUP_1: U1006.13, U1023.6
/Main controller/Branch decisions/N_S_IDLE_N: U1002.4, U1004.4, U1011.13
/Main controller/Branch decisions/N_UPPER_FLAG: U1001.6, U1007.2, U1008.10
/Main controller/Branch decisions/N_ZERO_FLAG: U1001.4, U1007.13, U1008.2, U1008.13, U1009.5
/Main controller/Branch decisions/SHARED_PRODUCT_1_N_GROUP_0: U1023.3, U1024.8
/Main controller/Branch decisions/SHARED_PRODUCT_1_N_GROUP_1: U1023.5, U1025.8
/Main controller/Branch decisions/SINGLE_CLOCK_STATE: U1010.4, U1011.12
ACCEPT_ENTER_A_N: U1006.3, U1024.1, U1031.1; also elsewhere on the board
ACCEPT_ENTER_B_N: U1006.6, U1024.2, U1031.2; also elsewhere on the board
ACCEPT_NEW_ENTRY_N: U1006.8, U1017.9, U1031.4; also elsewhere on the board
ACCEPT_START_ADD_N: U1005.3, U1029.1, U1033.1; also elsewhere on the board
ACCEPT_START_DIV_N: U1004.5, U1005.11, U1017.10, U1029.2; also elsewhere on the board
ACCEPT_START_MUL_N: U1005.8, U1027.1, U1029.4; also elsewhere on the board
ACCEPT_START_SUB_N: U1005.6, U1029.5, U1033.2; also elsewhere on the board
ACTION_ALLOWED_CTRL: U1002.3, U1002.5; also elsewhere on the board
BRANCH_ADD_CHECK_0_N: U1007.6, U1024.3
BRANCH_ADD_CHECK_1_N: U1007.3, U1024.4; also elsewhere on the board
BRANCH_D_BORROW_0_N: U1009.8, U1033.3; also elsewhere on the board
BRANCH_D_B_ZERO_1_N: U1009.6, U1024.5; also elsewhere on the board
BRANCH_D_ROUND_0_N: U1010.3, U1024.6; also elsewhere on the board
BRANCH_D_STAGE_0_N: U1009.11, U1027.2; also elsewhere on the board
BRANCH_M_AGAIN_0_N: U1009.3, U1033.4; also elsewhere on the board
BRANCH_M_AGAIN_1_N: U1008.11, U1024.11
BRANCH_M_A_ZERO_1_N: U1007.11, U1027.4; also elsewhere on the board
BRANCH_M_B_ZERO_1_N: U1008.3, U1027.5; also elsewhere on the board
BRANCH_M_LIMIT_1_N: U1008.8, U1024.12; also elsewhere on the board
BRANCH_M_ORDER_1_N: U1008.6, U1033.5; also elsewhere on the board
BRANCH_SUB_CHECK_1_N: U1007.8, U1025.1
CALC_STARTED: U1032.3; also elsewhere on the board
CANCEL: U1001.13, U1003.10, U1010.10; also elsewhere on the board
CARRY_FLAG: U1001.1, U1009.10, U1010.2; also elsewhere on the board
DISPLAY_MODE: U1011.2; also elsewhere on the board
DIV_STAGE_LAST: U1001.9, U1009.13; also elsewhere on the board
DIV_STARTED: U1004.6; also elsewhere on the board
ENTER_A: U1006.2; also elsewhere on the board
ENTER_B: U1006.5; also elsewhere on the board
FORCE_CLEAR: U1003.11, U1004.1, U1012.4; also elsewhere on the board
GND: C1001.2, C1002.2, C1003.2, C1004.2, C1005.2, C1006.2, C1007.2, C1008.2, C1009.2, C1010.2, C1011.2, C1012.2, C1024.2, C1025.2, C1027.2, C1028.2, C1029.2, C1030.2, C1031.2, C1032.2, C1033.2, C1034.2, U1001.7 (GND), U1002.7 (GND), U1003.7 (GND), U1004.7 (GND), U1005.7 (GND), U1006.7 (GND), U1007.7 (GND), U1008.7 (GND), U1009.7 (GND), U1010.7 (GND), U1011.3, U1011.4, U1011.5, U1011.7 (GND), U1011.9, U1011.10, U1011.11, U1012.7 (GND), U1024.7 (GND), U1025.7 (GND), U1027.7 (GND), U1028.7 (GND), U1029.7 (GND), U1030.7 (GND), U1031.7 (GND), U1032.4, U1032.5, U1032.7 (GND), U1032.9, U1032.10, U1032.12, U1032.13, U1033.7 (GND), U1034.7 (GND); also elsewhere on the board
IDLE_READY: U1002.6, U1005.1, U1005.4, U1005.9, U1005.12, U1006.1, U1006.4, U1006.9; also elsewhere on the board
INVALID_CODE: U1003.6, U1003.13, U1012.2
MAIN_LOAD_N: U1004.8; also elsewhere on the board
NEW_ENTRY: U1006.10; also elsewhere on the board
NORMAL_BRANCH_ALLOWED: U1004.2; also elsewhere on the board
POWER_RESET_N: U1001.11, U1002.1, U1002.10; also elsewhere on the board
SEQUENCE_DONE: U1010.5; also elsewhere on the board
SHARED_PRODUCT_1: U1023.8, U1033.6; also elsewhere on the board
SHARED_PRODUCT_1_N: U1006.11, U1023.9
SHARED_PRODUCT_3: U1023.12, U1033.11; also elsewhere on the board
SHARED_PRODUCT_3_N: U1017.8, U1023.13
SHARED_PRODUCT_4: U1028.2, U1033.12; also elsewhere on the board
SHARED_PRODUCT_4_N: U1027.6, U1028.1
SHARED_PRODUCT_6: U1028.6, U1031.5
SHARED_PRODUCT_6_N: U1028.5, U1029.6, U1032.1
SHARED_PRODUCT_7: U1028.8, U1034.1; also elsewhere on the board
SHARED_PRODUCT_7_N: U1028.9, U1030.3
START_ADD: U1005.2; also elsewhere on the board
START_DIV: U1005.13; also elsewhere on the board
START_MUL: U1005.10; also elsewhere on the board
START_SUB: U1005.5; also elsewhere on the board
STATE_6: U1003.2; also elsewhere on the board
STATE_7: U1003.5; also elsewhere on the board
STATE_ADVANCE: U1002.8, U1002.13; also elsewhere on the board
STATE_GROUP_7_N: U1029.9; also elsewhere on the board
S_ADD_CHECK_N: U1007.1, U1007.4; also elsewhere on the board
S_CLEAR_DISPLAY_N: U1030.1; also elsewhere on the board
S_DIV_ZERO_N: U1034.2; also elsewhere on the board
S_DONE_A_N: U1034.3; also elsewhere on the board
S_DONE_W_N: U1030.2; also elsewhere on the board
S_D_BORROW_N: U1009.9; also elsewhere on the board
S_D_B_ZERO_N: U1009.4; also elsewhere on the board
S_D_INCREMENT_N: U1025.2; also elsewhere on the board
S_D_Q_INC_N: U1017.11; also elsewhere on the board
S_D_ROUND_N: U1010.1; also elsewhere on the board
S_D_STAGE_N: U1009.12; also elsewhere on the board
S_E_CLEAR_WAIT_N: U1025.3; also elsewhere on the board
S_E_DISPLAY_A_N: U1034.4; also elsewhere on the board
S_E_DISPLAY_B_N: U1034.5; also elsewhere on the board
S_E_NEW_WAIT_N: U1025.4; also elsewhere on the board
S_E_SHIFT_A_N: U1025.5; also elsewhere on the board
S_E_SHIFT_B_N: U1034.6; also elsewhere on the board
S_IDLE_N: U1004.3; also elsewhere on the board
S_INVALID_53_N: U1029.10; also elsewhere on the board
S_INVALID_54_N: U1029.12; also elsewhere on the board
S_INVALID_55_N: U1029.13; also elsewhere on the board
S_M_AGAIN_N: U1008.12, U1009.1; also elsewhere on the board
S_M_A_ZERO_N: U1007.12; also elsewhere on the board
S_M_B_ZERO_N: U1008.1; also elsewhere on the board
S_M_LIMIT_N: U1008.9; also elsewhere on the board
S_M_ORDER_N: U1008.4; also elsewhere on the board
S_OVERFLOW_N: U1034.11; also elsewhere on the board
S_SET_MINUS_N: U1025.6; also elsewhere on the board
S_SUB_CHECK_N: U1007.9; also elsewhere on the board
S_ZERO_W_N: U1025.11; also elsewhere on the board
UPPER_FLAG: U1001.5, U1007.5; also elsewhere on the board
WORD_MODE: U1011.1; also elsewhere on the board
ZERO_FLAG: U1001.3, U1009.2; also elsewhere on the board

Notes on the sheet:
Gate power and local decoupling

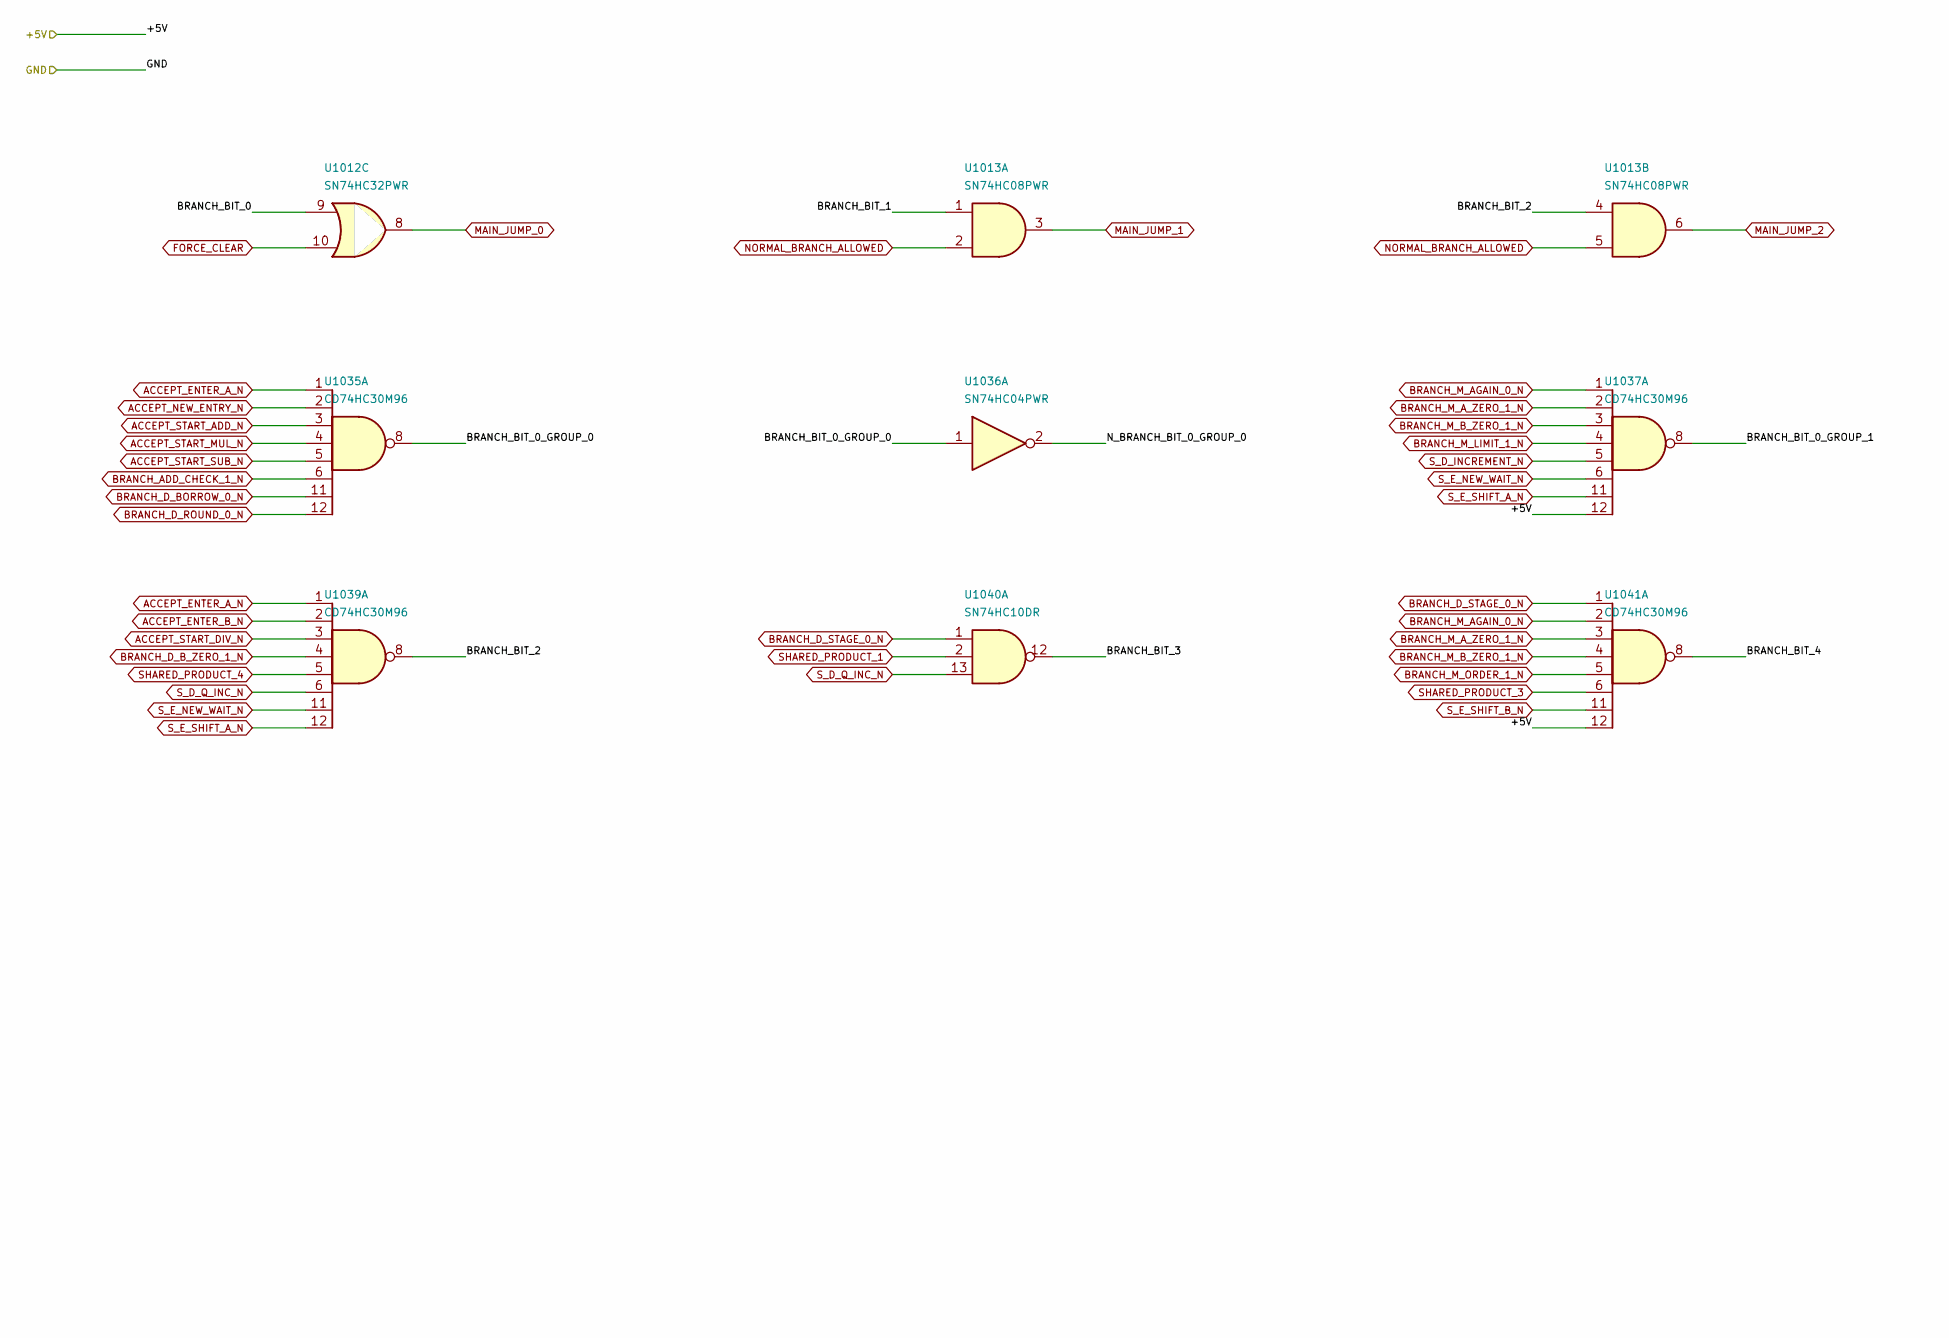
[picture p54: schematic controller-targets.kicad_sch, Calculator - branch destination bits, part in row 1, column 1]

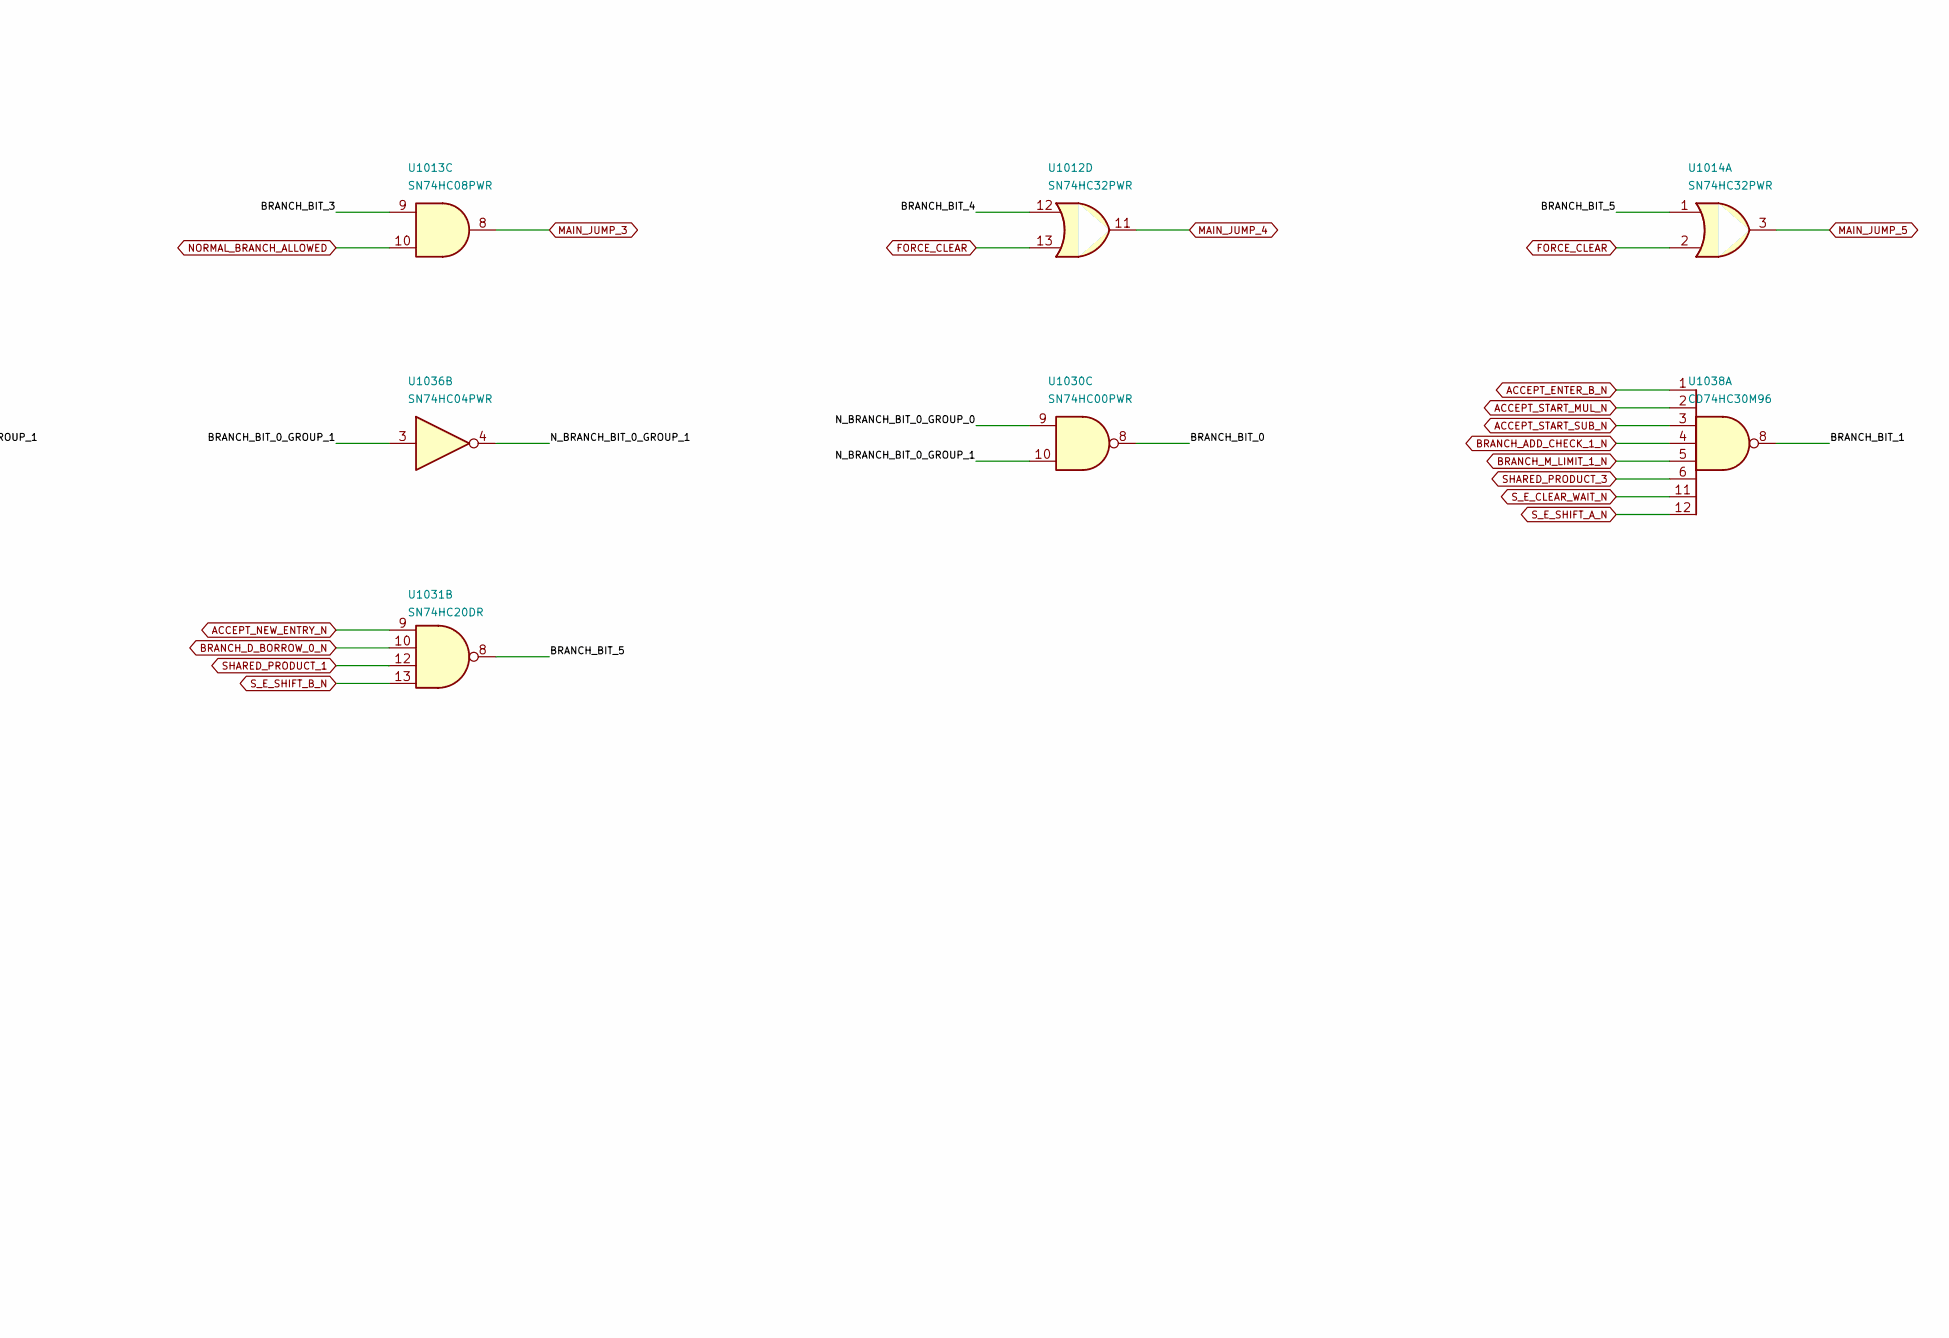
[picture p55: schematic controller-targets.kicad_sch, Calculator - branch destination bits, part in row 1, column 2]

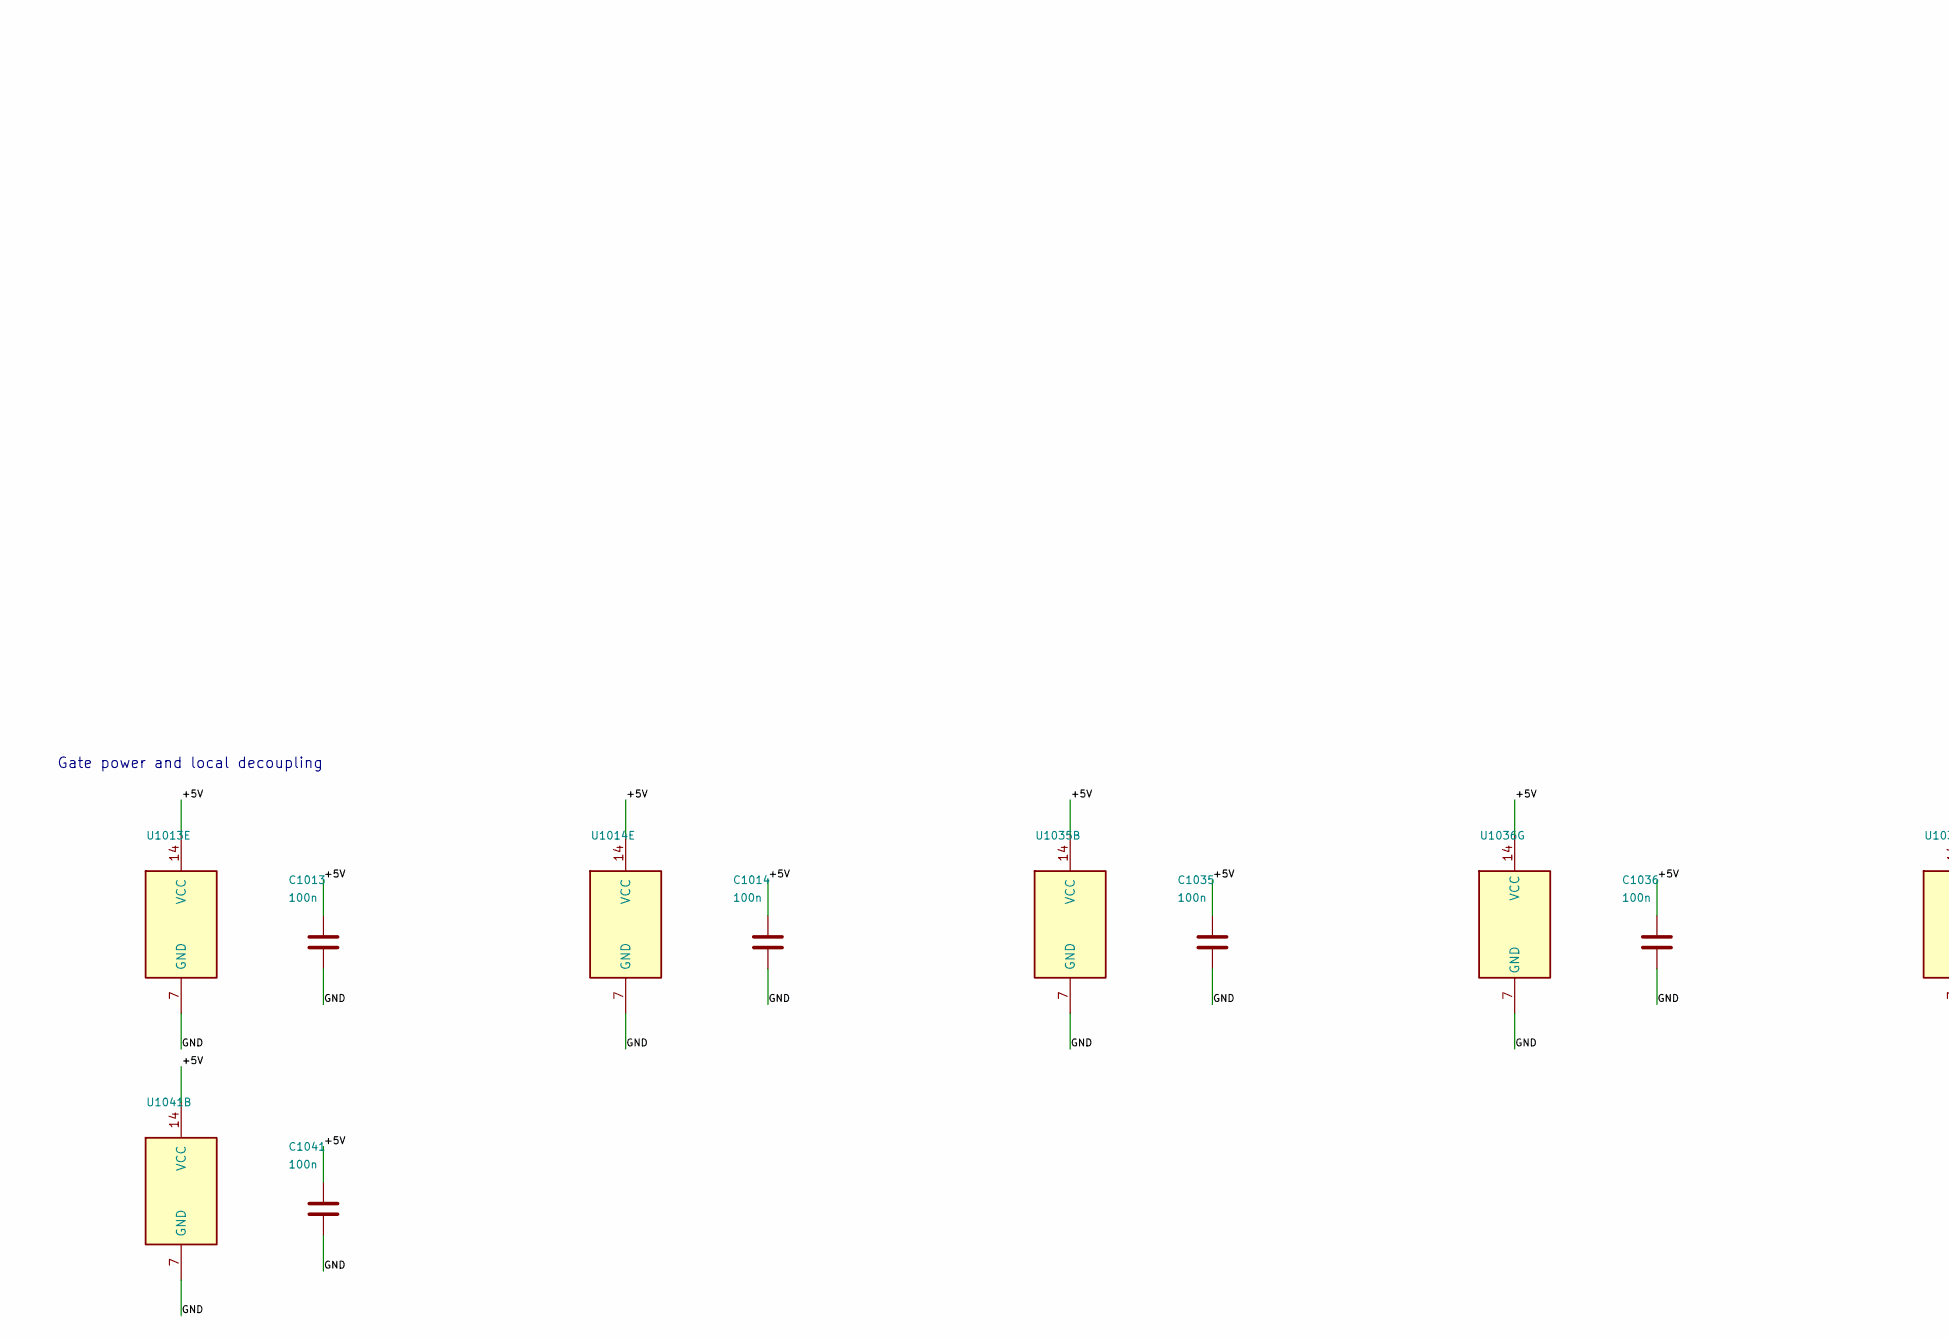
[picture p56: schematic controller-targets.kicad_sch, Calculator - branch destination bits, part in row 2, column 1]

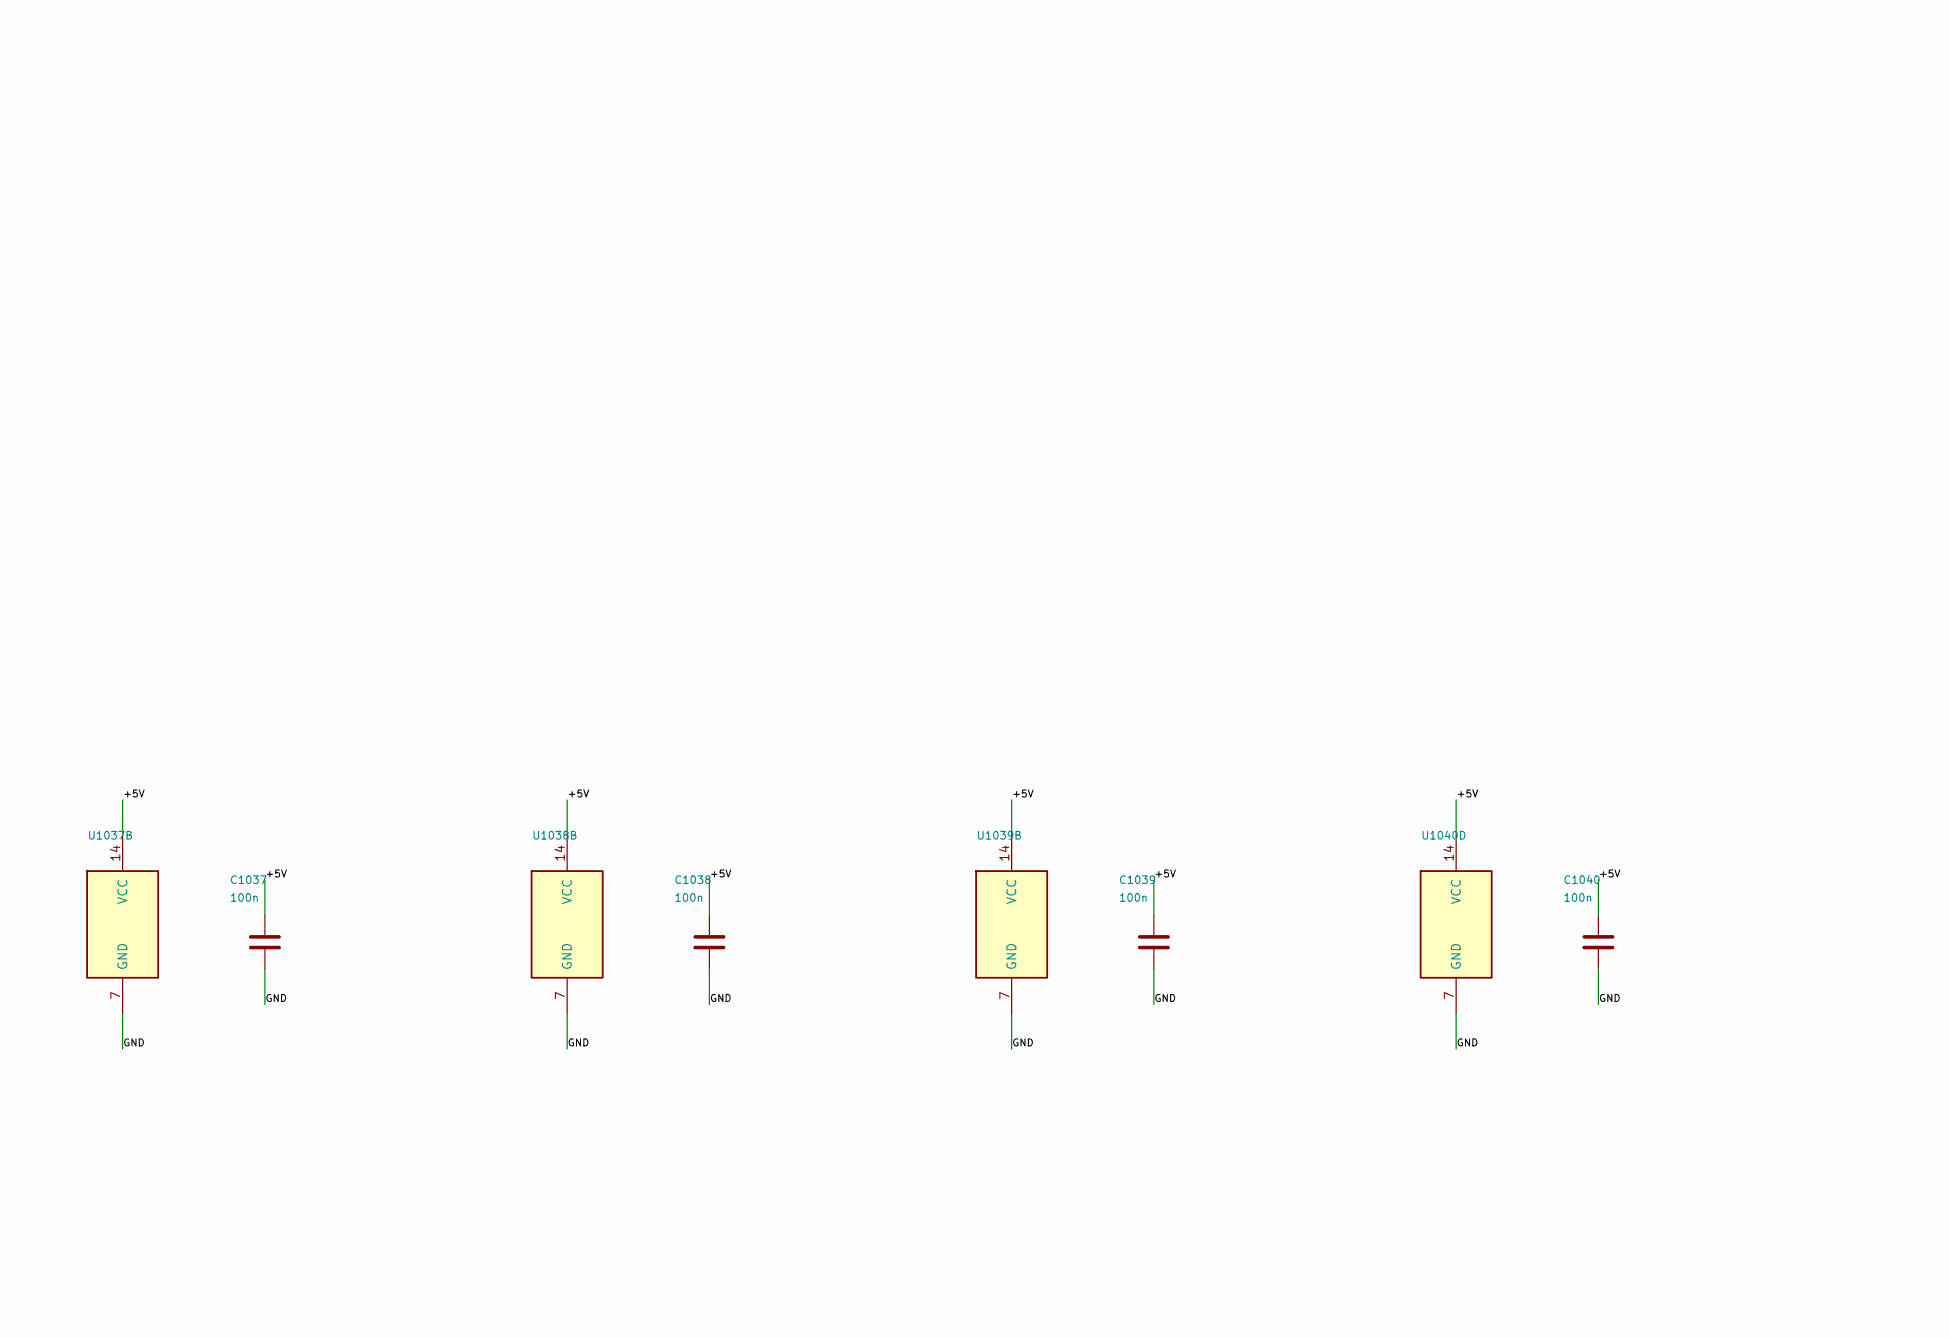
[picture p57: schematic controller-targets.kicad_sch, Calculator - branch destination bits, part in row 2, column 2]

Parts:
C1013, C1014, C1035, C1036, C1037, C1038, C1039, C1040, C1041: 100n; C_0603_1608Metric
U1012, U1014: SN74HC32PWR; TSSOP-14_4.4x5mm_P0.65mm
U1013: SN74HC08PWR; TSSOP-14_4.4x5mm_P0.65mm
U1030: SN74HC00PWR; TSSOP-14_4.4x5mm_P0.65mm
U1031: SN74HC20DR; SOIC-14_3.9x8.7mm_P1.27mm
U1035, U1037, U1038, U1039, U1041: CD74HC30M96; SOIC-14_3.9x8.7mm_P1.27mm
U1036: SN74HC04PWR; TSSOP-14_4.4x5mm_P0.65mm
U1040: SN74HC10DR; SOIC-14_3.9x8.7mm_P1.27mm

Connections:
+5V: C1013.1, C1014.1, C1035.1, C1036.1, C1037.1, C1038.1, C1039.1, C1040.1, C1041.1, U1013.14 (VCC), U1014.14 (VCC), U1035.14 (VCC), U1036.14 (VCC), U1037.12, U1037.14 (VCC), U1038.14 (VCC), U1039.14 (VCC), U1040.14 (VCC), U1041.12, U1041.14 (VCC); also elsewhere on the board
/Main controller/Branch destinations/BRANCH_BIT_0: U1012.9, U1030.8
/Main controller/Branch destinations/BRANCH_BIT_0_GROUP_0: U1035.8, U1036.1
/Main controller/Branch destinations/BRANCH_BIT_0_GROUP_1: U1036.3, U1037.8
/Main controller/Branch destinations/BRANCH_BIT_1: U1013.1, U1038.8
/Main controller/Branch destinations/BRANCH_BIT_2: U1013.4, U1039.8
/Main controller/Branch destinations/BRANCH_BIT_3: U1013.9, U1040.12
/Main controller/Branch destinations/BRANCH_BIT_4: U1012.12, U1041.8
/Main controller/Branch destinations/BRANCH_BIT_5: U1014.1, U1031.8
/Main controller/Branch destinations/N_BRANCH_BIT_0_GROUP_0: U1030.9, U1036.2
/Main controller/Branch destinations/N_BRANCH_BIT_0_GROUP_1: U1030.10, U1036.4
ACCEPT_ENTER_A_N: U1035.1, U1039.1; also elsewhere on the board
ACCEPT_ENTER_B_N: U1038.1, U1039.2; also elsewhere on the board
ACCEPT_NEW_ENTRY_N: U1031.9, U1035.2; also elsewhere on the board
ACCEPT_START_ADD_N: U1035.3; also elsewhere on the board
ACCEPT_START_DIV_N: U1039.3; also elsewhere on the board
ACCEPT_START_MUL_N: U1035.4, U1038.2; also elsewhere on the board
ACCEPT_START_SUB_N: U1035.5, U1038.3; also elsewhere on the board
BRANCH_ADD_CHECK_1_N: U1035.6, U1038.4; also elsewhere on the board
BRANCH_D_BORROW_0_N: U1031.10, U1035.11; also elsewhere on the board
BRANCH_D_B_ZERO_1_N: U1039.4; also elsewhere on the board
BRANCH_D_ROUND_0_N: U1035.12; also elsewhere on the board
BRANCH_D_STAGE_0_N: U1040.1, U1041.1; also elsewhere on the board
BRANCH_M_AGAIN_0_N: U1037.1, U1041.2; also elsewhere on the board
BRANCH_M_A_ZERO_1_N: U1037.2, U1041.3; also elsewhere on the board
BRANCH_M_B_ZERO_1_N: U1037.3, U1041.4; also elsewhere on the board
BRANCH_M_LIMIT_1_N: U1037.4, U1038.5; also elsewhere on the board
BRANCH_M_ORDER_1_N: U1041.5; also elsewhere on the board
FORCE_CLEAR: U1012.10, U1012.13, U1014.2; also elsewhere on the board
GND: C1013.2, C1014.2, C1035.2, C1036.2, C1037.2, C1038.2, C1039.2, C1040.2, C1041.2, U1013.7 (GND), U1014.7 (GND), U1035.7 (GND), U1036.7 (GND), U1037.7 (GND), U1038.7 (GND), U1039.7 (GND), U1040.7 (GND), U1041.7 (GND); also elsewhere on the board
MAIN_JUMP_0: U1012.8; also elsewhere on the board
MAIN_JUMP_1: U1013.3; also elsewhere on the board
MAIN_JUMP_2: U1013.6; also elsewhere on the board
MAIN_JUMP_3: U1013.8; also elsewhere on the board
MAIN_JUMP_4: U1012.11; also elsewhere on the board
MAIN_JUMP_5: U1014.3; also elsewhere on the board
NORMAL_BRANCH_ALLOWED: U1013.2, U1013.5, U1013.10; also elsewhere on the board
SHARED_PRODUCT_1: U1031.12, U1040.2; also elsewhere on the board
SHARED_PRODUCT_3: U1038.6, U1041.6; also elsewhere on the board
SHARED_PRODUCT_4: U1039.5; also elsewhere on the board
S_D_INCREMENT_N: U1037.5; also elsewhere on the board
S_D_Q_INC_N: U1039.6, U1040.13; also elsewhere on the board
S_E_CLEAR_WAIT_N: U1038.11; also elsewhere on the board
S_E_NEW_WAIT_N: U1037.6, U1039.11; also elsewhere on the board
S_E_SHIFT_A_N: U1037.11, U1038.12, U1039.12; also elsewhere on the board
S_E_SHIFT_B_N: U1031.13, U1041.11; also elsewhere on the board

Notes on the sheet:
Gate power and local decoupling

Schematic: controller-outputs.kicad_sch, Calculator - state to datapath controls

Parts:
C1015, C1016, C1017, C1018, C1026, C1042, C1043, C1044, C1045, C1046, C1047, C1048, C1049, C1050, C1051: 100n; C_0603_1608Metric
U1004, U1016, U1023, U1028, U1036, U1048, U1051: SN74HC04PWR; TSSOP-14_4.4x5mm_P0.65mm
U1013, U1015, U1018: SN74HC08PWR; TSSOP-14_4.4x5mm_P0.65mm
U1014: SN74HC32PWR; TSSOP-14_4.4x5mm_P0.65mm
U1017, U1040, U1049: SN74HC10DR; SOIC-14_3.9x8.7mm_P1.27mm
U1026, U1042, U1043, U1047: CD74HC30M96; SOIC-14_3.9x8.7mm_P1.27mm
U1027, U1044, U1046: SN74HC20DR; SOIC-14_3.9x8.7mm_P1.27mm
U1030, U1045, U1050: SN74HC00PWR; TSSOP-14_4.4x5mm_P0.65mm

Connections:
+5V: C1015.1, C1016.1, C1017.1, C1018.1, C1026.1, C1042.1, C1043.1, C1044.1, C1045.1, C1046.1, C1047.1, C1048.1, C1049.1, C1050.1, C1051.1, U1015.14 (VCC), U1016.14 (VCC), U1017.14 (VCC), U1018.14 (VCC), U1026.14 (VCC), U1042.14 (VCC), U1043.6, U1043.11, U1043.12, U1043.14 (VCC), U1044.14 (VCC), U1045.14 (VCC), U1046.14 (VCC), U1047.14 (VCC), U1048.14 (VCC), U1049.14 (VCC), U1050.14 (VCC), U1051.14 (VCC); also elsewhere on the board
/Main controller/Datapath controls/N_DIV_STAGE_LAST: U1016.2, U1017.2
/Main controller/Datapath controls/N_STAGE_INC: U1016.3, U1017.12
/Main controller/Datapath controls/N_WORD_MODE_GROUP_0: U1030.12, U1036.6
/Main controller/Datapath controls/N_WORD_MODE_GROUP_1: U1030.13, U1036.8
/Main controller/Datapath controls/OPPOSITE_MAC_Y_0: U1004.11, U1040.8
/Main controller/Datapath controls/OPPOSITE_MAC_Y_1: U1004.13, U1046.8
/Main controller/Datapath controls/RAW_MAC_BANK_RESET: U1015.1, U1050.3
/Main controller/Datapath controls/RAW_Q_INC: U1015.9, U1048.10
/Main controller/Datapath controls/RAW_Q_RESET: U1015.4, U1048.8
/Main controller/Datapath controls/RAW_SIGN_SET: U1013.12, U1048.6
/Main controller/Datapath controls/RAW_STAGE_INC: U1017.1, U1051.2
/Main controller/Datapath controls/RAW_STAGE_RESET: U1015.12, U1048.12
/Main controller/Datapath controls/RESULT_DISPLAY: U1018.4, U1050.6
/Main controller/Datapath controls/RESULT_DISPLAY_FINISHED: U1014.4, U1018.6
/Main controller/Datapath controls/RESULT_ERROR: U1014.5, U1050.8
/Main controller/Datapath controls/WORD_MODE_GROUP_0: U1036.5, U1042.8
/Main controller/Datapath controls/WORD_MODE_GROUP_1: U1036.9, U1043.8
ACTION_ALLOWED_CTRL: U1013.13, U1015.2, U1015.5, U1015.10, U1015.13, U1017.13; also elsewhere on the board
CONST_ONE: U1045.8; also elsewhere on the board
DISPLAY_FINISHED: U1018.3; also elsewhere on the board
DISPLAY_MODE: U1018.1, U1044.6; also elsewhere on the board
DISPLAY_SOURCE_0: U1048.2; also elsewhere on the board
DISPLAY_SOURCE_1: U1048.4; also elsewhere on the board
DIV_STAGE_LAST: U1016.1; also elsewhere on the board
GND: C1015.2, C1016.2, C1017.2, C1018.2, C1026.2, C1042.2, C1043.2, C1044.2, C1045.2, C1046.2, C1047.2, C1048.2, C1049.2, C1050.2, C1051.2, U1015.7 (GND), U1016.7 (GND), U1017.7 (GND), U1018.7 (GND), U1026.7 (GND), U1042.7 (GND), U1043.7 (GND), U1044.7 (GND), U1045.7 (GND), U1046.7 (GND), U1047.7 (GND), U1048.7 (GND), U1049.7 (GND), U1049.9, U1049.10, U1049.11, U1050.7 (GND), U1050.12, U1050.13, U1051.3, U1051.5, U1051.7 (GND), U1051.9, U1051.11, U1051.13; also elsewhere on the board
LEFT_SELECT_0: U1049.6; also elsewhere on the board
LEFT_SELECT_1: U1045.11; also elsewhere on the board
MAC_BANK_RESET: U1015.3; also elsewhere on the board
MAC_SHIFT_A: U1044.8; also elsewhere on the board
MAC_SHIFT_B: U1036.10; also elsewhere on the board
MAC_SHIFT_W: U1036.12; also elsewhere on the board
MAC_WRITE_A: U1045.3; also elsewhere on the board
MAC_WRITE_B: U1045.6; also elsewhere on the board
MAC_WRITE_W: U1046.6; also elsewhere on the board
MAC_X_0: U1047.8; also elsewhere on the board
MAC_X_1: U1040.6; also elsewhere on the board
MAC_Y_0: U1004.10; also elsewhere on the board
MAC_Y_1: U1004.12; also elsewhere on the board
Q_INC: U1015.8; also elsewhere on the board
Q_RESET: U1015.6; also elsewhere on the board
RESULT_FINISHED: U1014.6; also elsewhere on the board
SEQUENCE_DONE: U1018.2, U1018.5; also elsewhere on the board
SHARED_PRODUCT_2: U1023.10, U1040.3, U1042.1, U1046.1
SHARED_PRODUCT_2_N: U1023.11, U1026.8
SHARED_PRODUCT_5: U1028.4, U1046.9, U1049.1
SHARED_PRODUCT_5_N: U1027.8, U1028.3
SHARED_PRODUCT_7: U1044.1, U1048.3; also elsewhere on the board
SIGN_SET: U1013.11; also elsewhere on the board
STAGE_INC: U1016.4; also elsewhere on the board
STAGE_RESET: U1015.11; also elsewhere on the board
SUBTRACT: U1049.12; also elsewhere on the board
S_ADD_N: U1042.2, U1046.2, U1046.10; also elsewhere on the board
S_DIV_ZERO_N: U1050.9; also elsewhere on the board
S_DONE_A_N: U1044.2, U1050.4; also elsewhere on the board
S_DONE_W_N: U1050.5; also elsewhere on the board
S_D_APPEND_N: U1036.13, U1045.12, U1049.3; also elsewhere on the board
S_D_CLEAR_N: U1026.1, U1047.1; also elsewhere on the board
S_D_DOUBLE_N: U1026.2, U1040.9; also elsewhere on the board
S_D_INCREMENT_N: U1042.3, U1045.1, U1045.9; also elsewhere on the board
S_D_Q_INC_N: U1048.11; also elsewhere on the board
S_D_Q_RESET_N: U1048.9; also elsewhere on the board
S_D_RESTORE_N: U1026.3, U1046.12; also elsewhere on the board
S_D_ROUND_COMPARE_N: U1027.9, U1040.4, U1042.4; also elsewhere on the board
S_D_SCALE_1_N: U1044.9; also elsewhere on the board
S_D_SCALE_2_N: U1044.10; also elsewhere on the board
S_D_STAGE_N: U1051.1; also elsewhere on the board
S_D_START_N: U1048.13; also elsewhere on the board
S_D_STORE_Q_N: U1044.12, U1045.13; also elsewhere on the board
S_D_SUB_N: U1026.4, U1027.10; also elsewhere on the board
S_D_TEST_B_N: U1042.5, U1047.2; also elsewhere on the board
S_E_CLEAR_ASSERT_N: U1050.1; also elsewhere on the board
S_E_DISPLAY_A_N: U1044.4; also elsewhere on the board
S_E_DISPLAY_B_N: U1044.5, U1048.1; also elsewhere on the board
S_E_NEW_CLEAR_N: U1050.2; also elsewhere on the board
S_E_SHIFT_A_N: U1044.13, U1049.4; also elsewhere on the board
S_E_SHIFT_B_N: U1036.11, U1049.5; also elsewhere on the board
S_M_ADD_N: U1026.5, U1040.10, U1046.13; also elsewhere on the board
S_M_CLEAR_N: U1026.6, U1047.3; also elsewhere on the board
S_M_COMPARE_N: U1027.12, U1042.6; also elsewhere on the board
S_M_DEC_N: U1042.11, U1045.4, U1045.10, U1047.4, U1049.2; also elsewhere on the board
S_M_SAVE_N: U1042.12, U1046.4; also elsewhere on the board
S_M_SWAP_A_N: U1043.1, U1045.2, U1047.5; also elsewhere on the board
S_M_SWAP_B_N: U1040.5, U1043.2, U1045.5; also elsewhere on the board
S_M_TEST_A_N: U1043.3; also elsewhere on the board
S_M_TEST_B_N: U1043.4, U1047.6; also elsewhere on the board
S_NEGATE_N: U1026.11, U1040.11, U1047.11, U1049.13; also elsewhere on the board
S_OVERFLOW_N: U1050.10; also elsewhere on the board
S_SET_MINUS_N: U1048.5; also elsewhere on the board
S_SUB_N: U1027.13, U1043.5, U1046.5; also elsewhere on the board
S_ZERO_W_N: U1026.12, U1047.12; also elsewhere on the board
WORD_MODE: U1030.11; also elsewhere on the board

Notes on the sheet:
Gate power and local decoupling
