EwoudVV/calculator/calculator.kicad_pcb

## KiCad design calculator.kicad_pcb (continued)

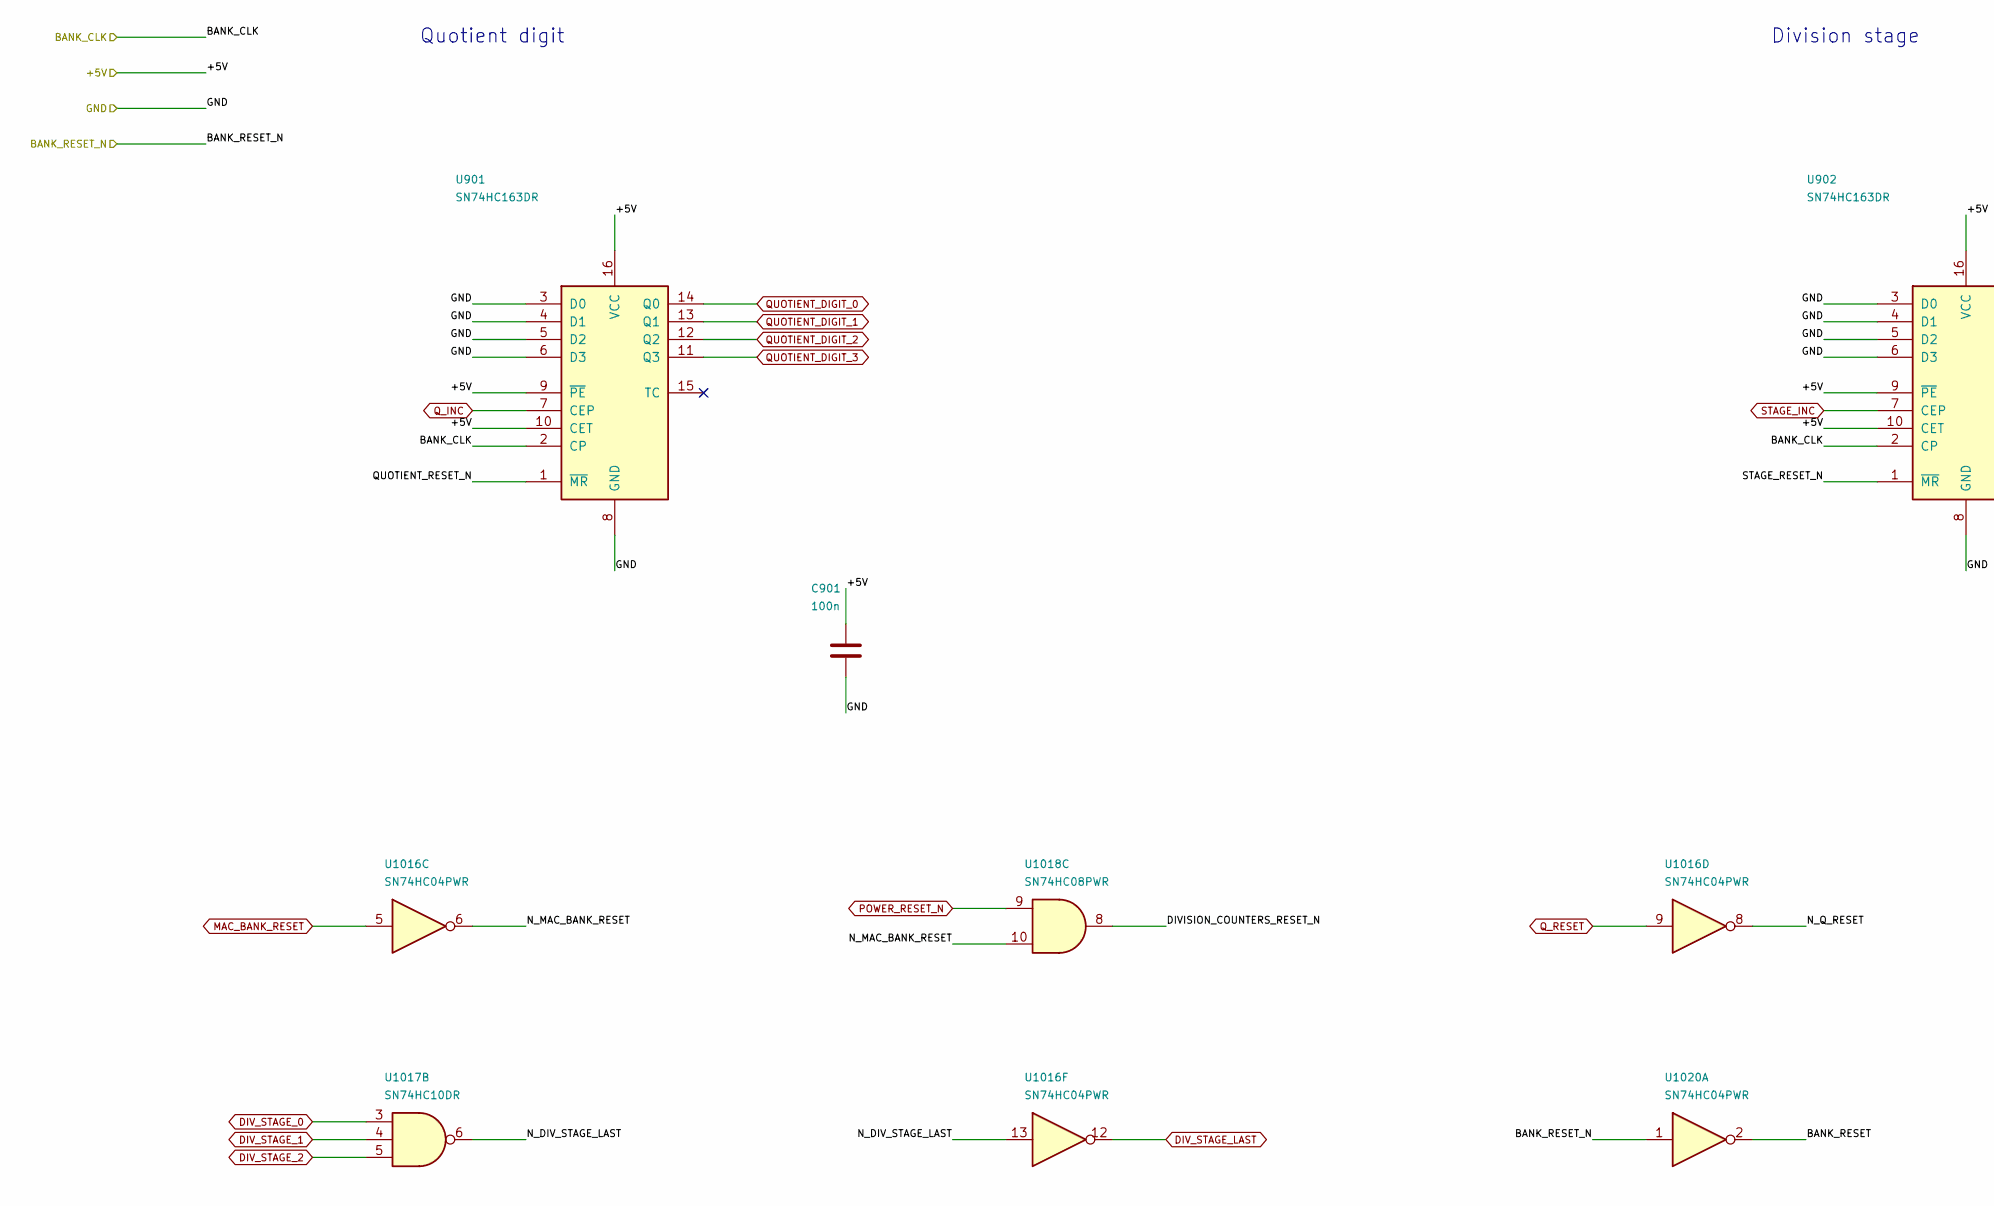
[picture p58: schematic division-status.kicad_sch, Calculator - division counters and display status, part in row 1, column 1]

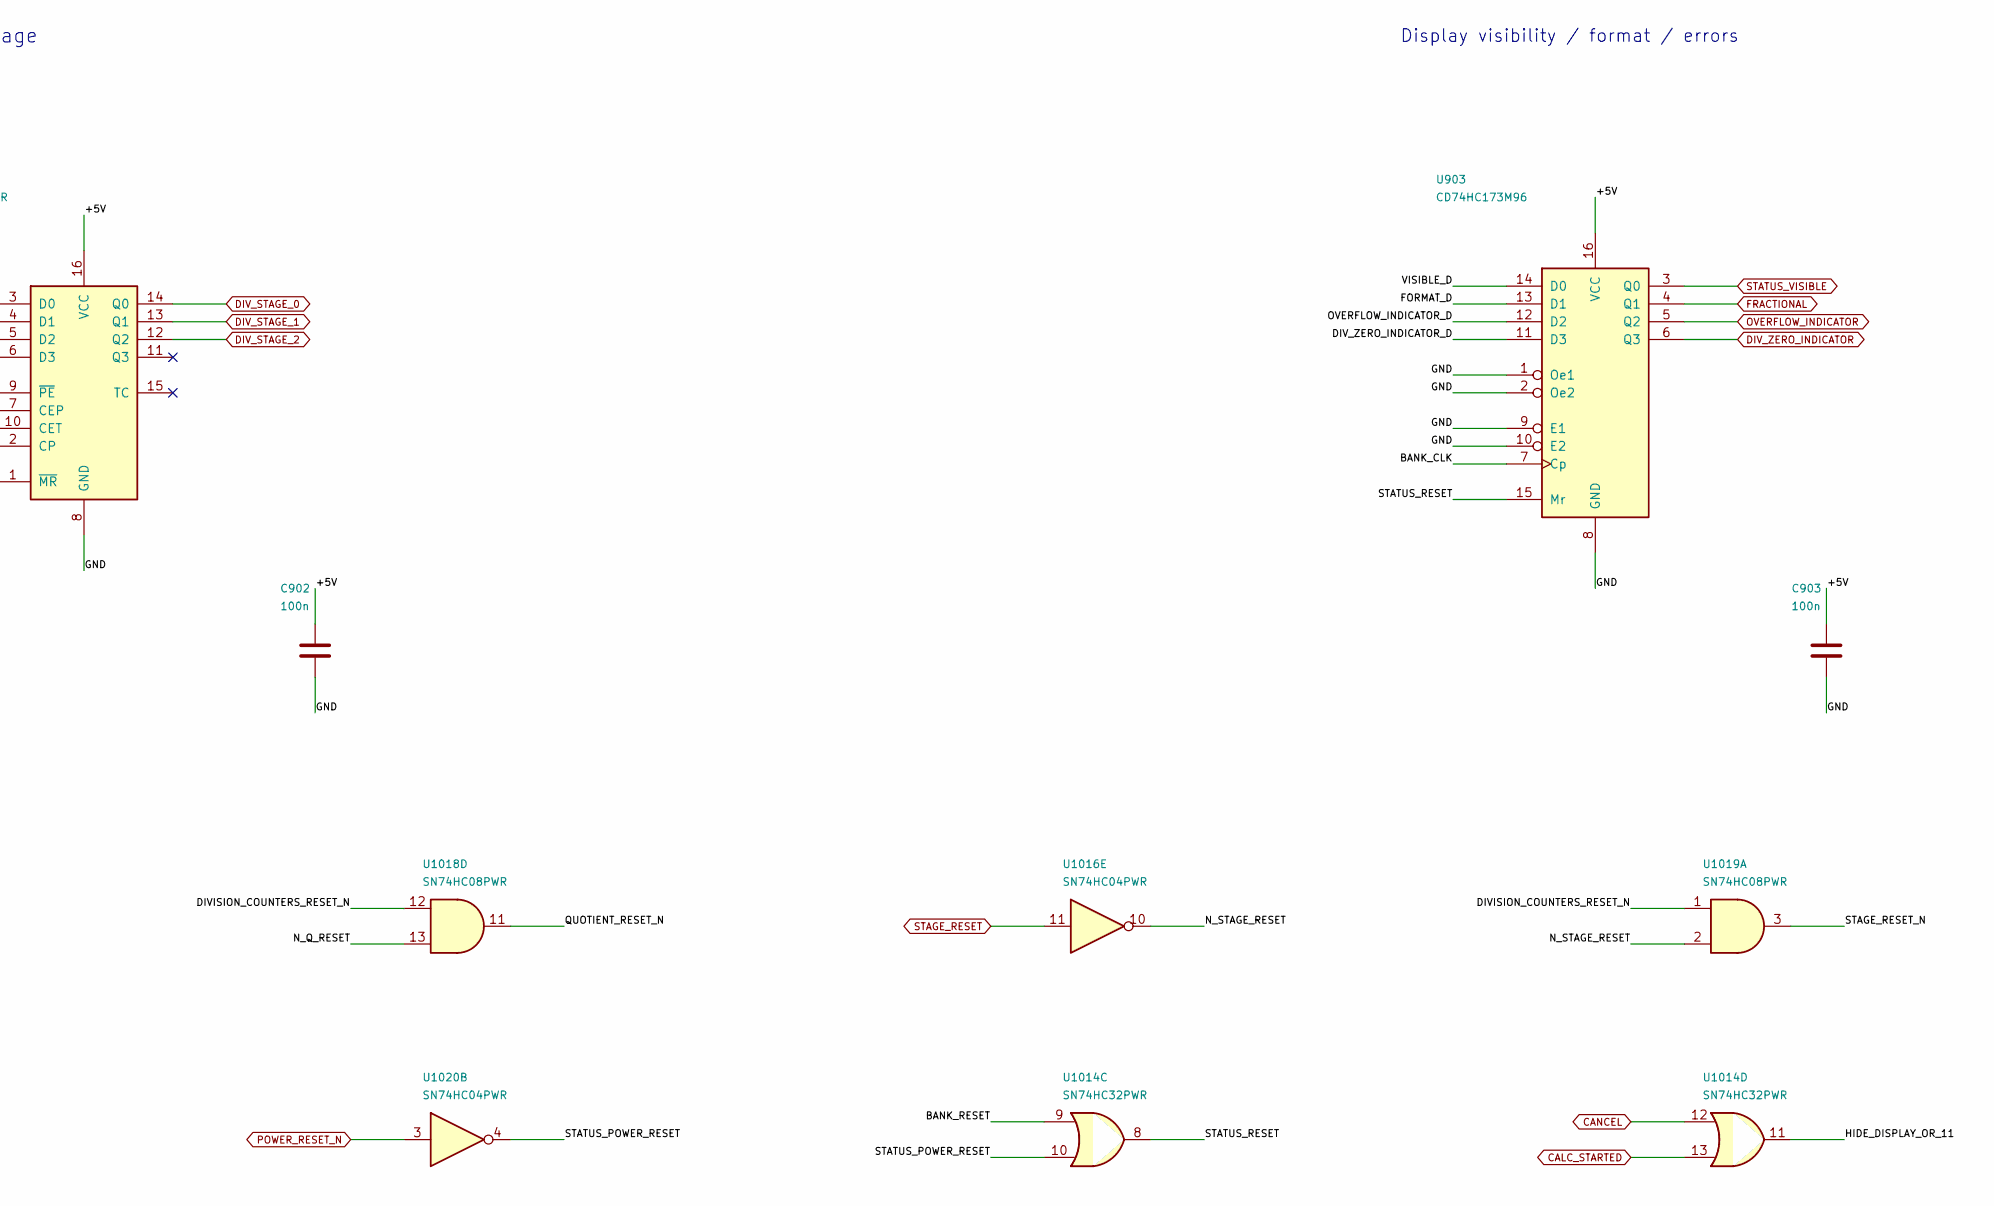
[picture p59: schematic division-status.kicad_sch, Calculator - division counters and display status, part in row 1, column 2]

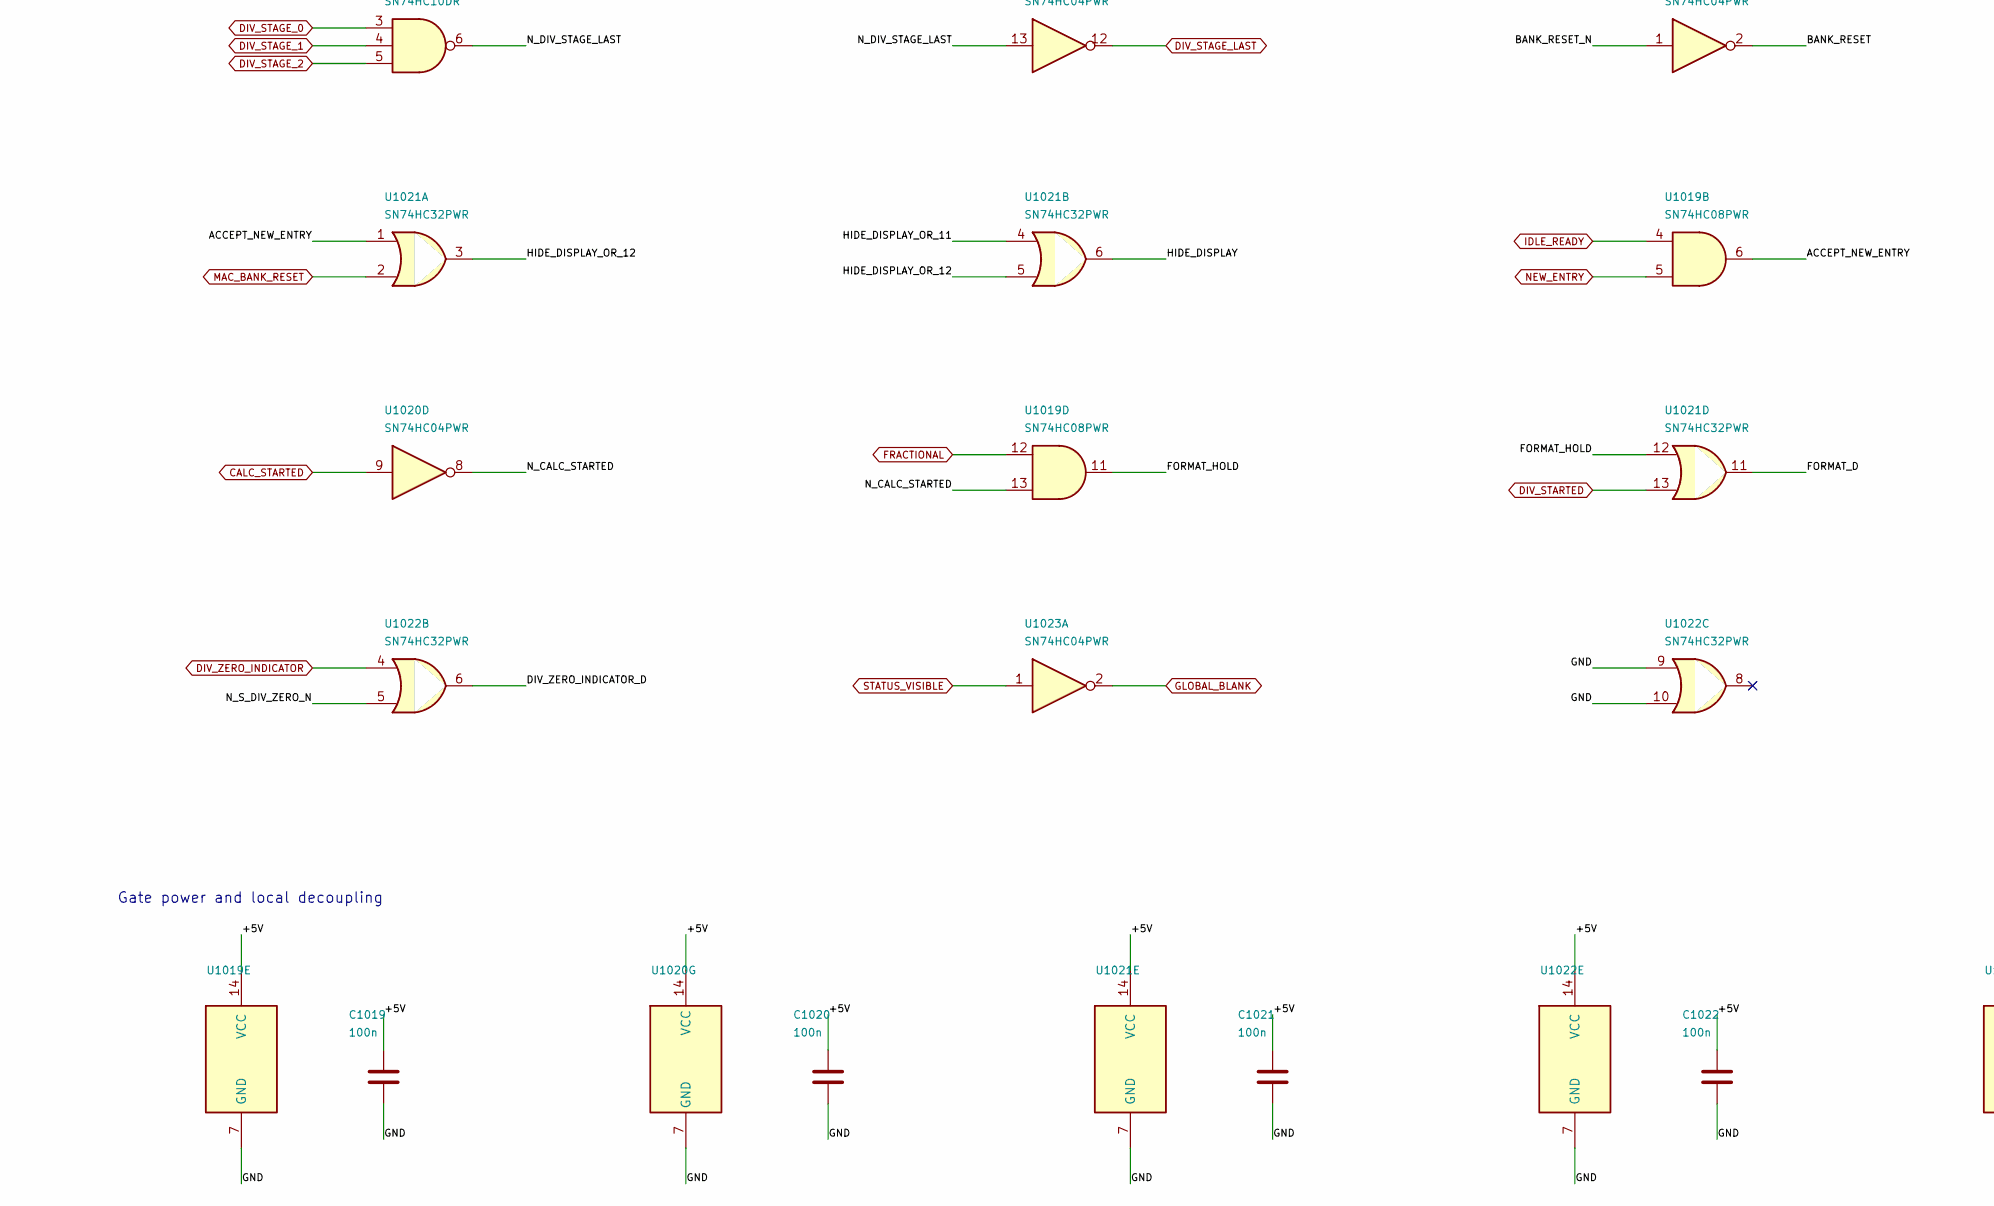
[picture p60: schematic division-status.kicad_sch, Calculator - division counters and display status, part in row 2, column 1]

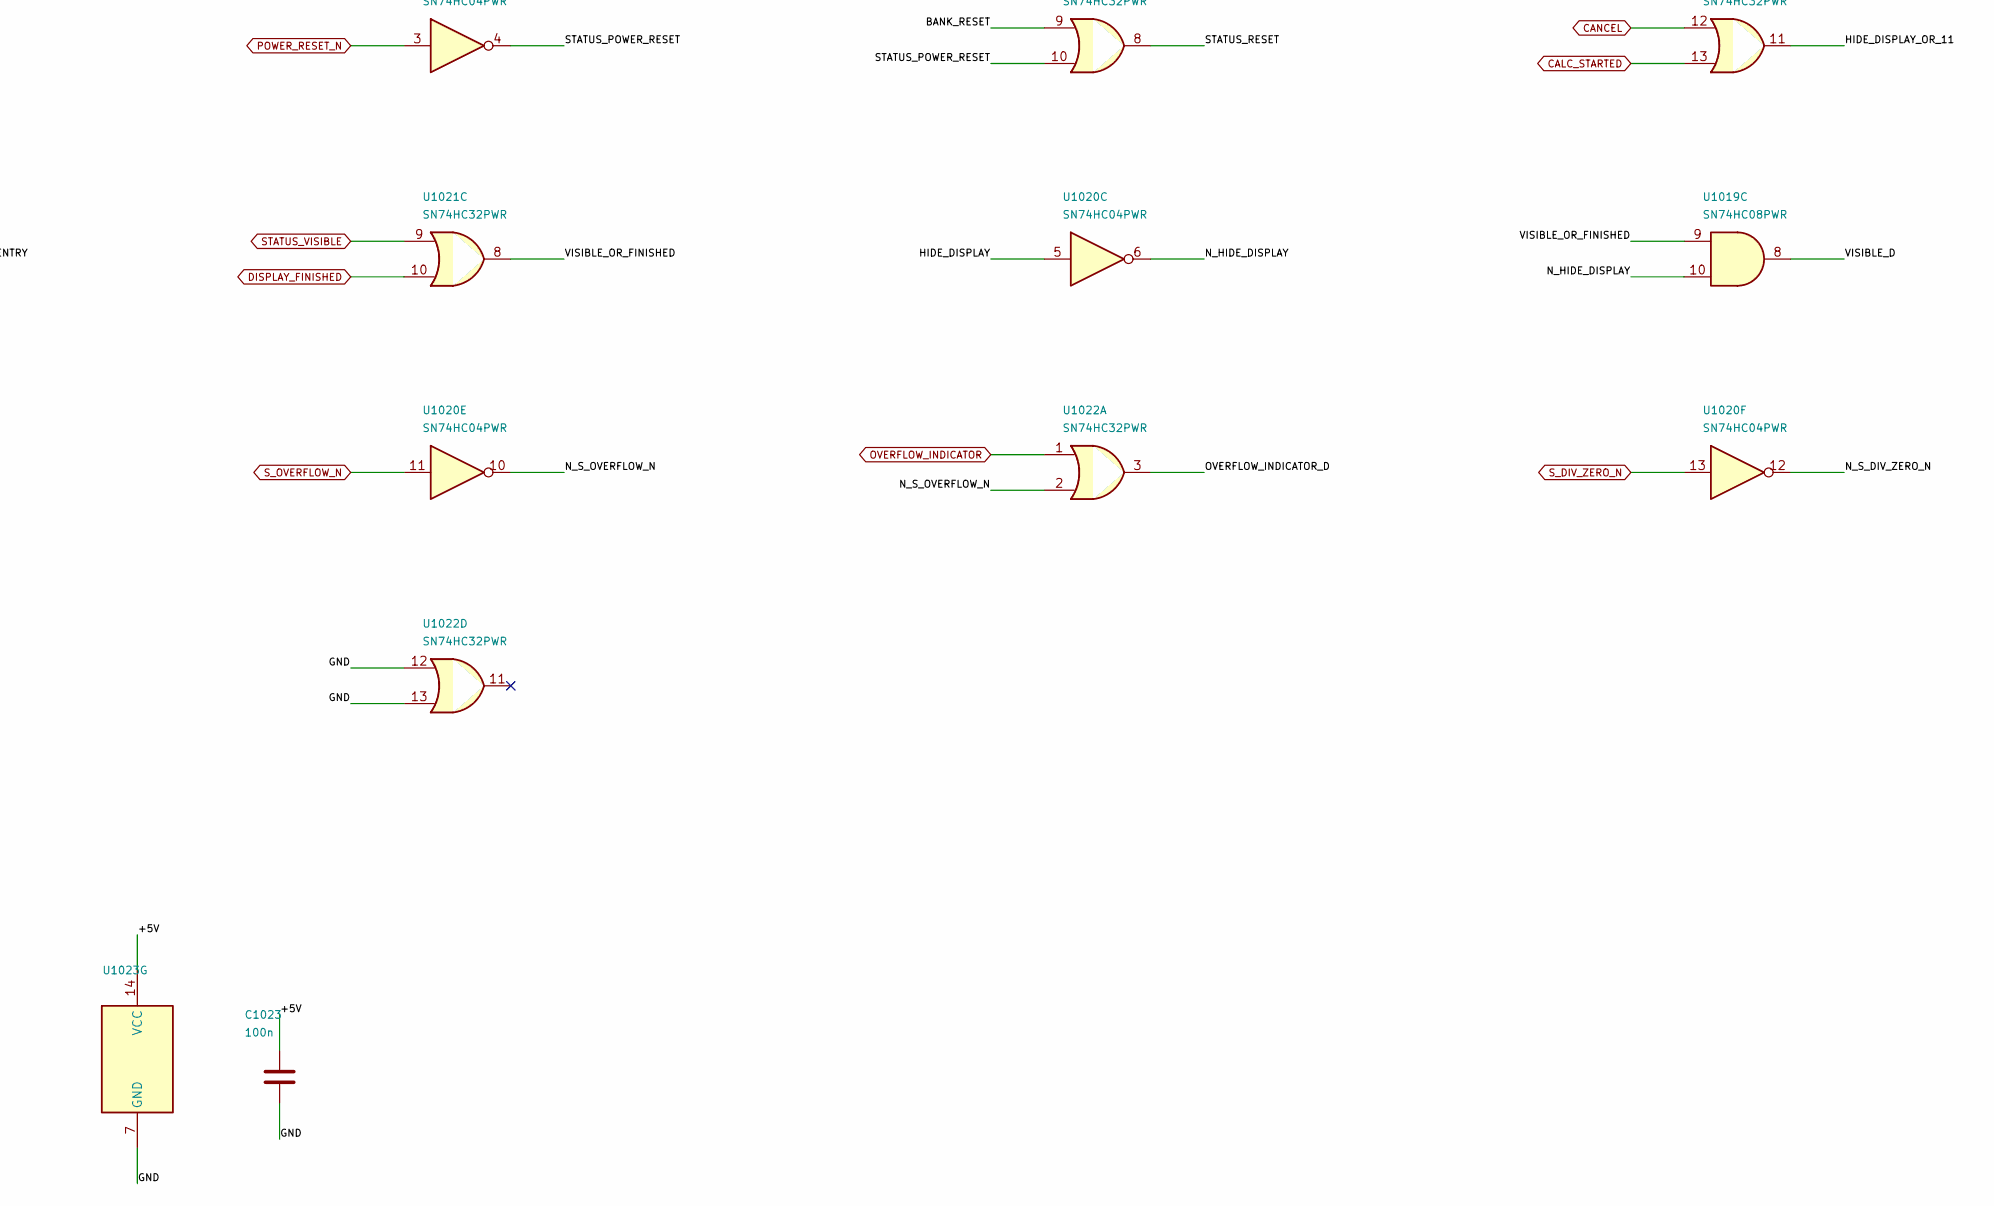
[picture p61: schematic division-status.kicad_sch, Calculator - division counters and display status, part in row 2, column 2]

Parts:
C901, C902, C903, C1019, C1020, C1021, C1022, C1023: 100n; C_0603_1608Metric
U901, U902: SN74HC163DR; SOIC-16_3.9x9.9mm_P1.27mm
U903: CD74HC173M96; SOIC-16_3.9x9.9mm_P1.27mm
U1014, U1021, U1022: SN74HC32PWR; TSSOP-14_4.4x5mm_P0.65mm
U1016, U1020, U1023: SN74HC04PWR; TSSOP-14_4.4x5mm_P0.65mm
U1017: SN74HC10DR; SOIC-14_3.9x8.7mm_P1.27mm
U1018, U1019: SN74HC08PWR; TSSOP-14_4.4x5mm_P0.65mm

Connections:
+5V: C901.1, C902.1, C903.1, C1019.1, C1020.1, C1021.1, C1022.1, C1023.1, U901.9 (~PE), U901.10 (CET), U901.16 (VCC), U902.9 (~PE), U902.10 (CET), U902.16 (VCC), U903.16 (VCC), U1019.14 (VCC), U1020.14 (VCC), U1021.14 (VCC), U1022.14 (VCC), U1023.14 (VCC); also elsewhere on the board
/BANK_RESET_N: U1020.1; also elsewhere on the board
/Main controller/Division and status/ACCEPT_NEW_ENTRY: U1019.6, U1021.1
/Main controller/Division and status/BANK_RESET: U1014.9, U1020.2
/Main controller/Division and status/DIVISION_COUNTERS_RESET_N: U1018.8, U1018.12, U1019.1
/Main controller/Division and status/DIV_ZERO_INDICATOR_D: U903.11 (D3), U1022.6
/Main controller/Division and status/FORMAT_D: U903.13 (D1), U1021.11
/Main controller/Division and status/FORMAT_HOLD: U1019.11, U1021.12
/Main controller/Division and status/HIDE_DISPLAY: U1020.5, U1021.6
/Main controller/Division and status/HIDE_DISPLAY_OR_11: U1014.11, U1021.4
/Main controller/Division and status/HIDE_DISPLAY_OR_12: U1021.3, U1021.5
/Main controller/Division and status/N_CALC_STARTED: U1019.13, U1020.8
/Main controller/Division and status/N_DIV_STAGE_LAST: U1016.13, U1017.6
/Main controller/Division and status/N_HIDE_DISPLAY: U1019.10, U1020.6
/Main controller/Division and status/N_MAC_BANK_RESET: U1016.6, U1018.10
/Main controller/Division and status/N_Q_RESET: U1016.8, U1018.13
/Main controller/Division and status/N_STAGE_RESET: U1016.10, U1019.2
/Main controller/Division and status/N_S_DIV_ZERO_N: U1020.12, U1022.5
/Main controller/Division and status/N_S_OVERFLOW_N: U1020.10, U1022.2
/Main controller/Division and status/OVERFLOW_INDICATOR_D: U903.12 (D2), U1022.3
/Main controller/Division and status/QUOTIENT_RESET_N: U901.1 (~MR), U1018.11
/Main controller/Division and status/STAGE_RESET_N: U902.1 (~MR), U1019.3
/Main controller/Division and status/STATUS_POWER_RESET: U1014.10, U1020.4
/Main controller/Division and status/STATUS_RESET: U903.15 (Mr), U1014.8
/Main controller/Division and status/VISIBLE_D: U903.14 (D0), U1019.8
/Main controller/Division and status/VISIBLE_OR_FINISHED: U1019.9, U1021.8
BANK_CLK: U901.2 (CP), U902.2 (CP), U903.7 (Cp); also elsewhere on the board
CALC_STARTED: U1014.13, U1020.9; also elsewhere on the board
CANCEL: U1014.12; also elsewhere on the board
DISPLAY_FINISHED: U1021.10; also elsewhere on the board
DIV_STAGE_0: U902.14 (Q0), U1017.3
DIV_STAGE_1: U902.13 (Q1), U1017.4
DIV_STAGE_2: U902.12 (Q2), U1017.5
DIV_STAGE_LAST: U1016.12; also elsewhere on the board
DIV_STARTED: U1021.13; also elsewhere on the board
DIV_ZERO_INDICATOR: U903.6 (Q3), U1022.4; also elsewhere on the board
FRACTIONAL: U903.4 (Q1), U1019.12; also elsewhere on the board
GLOBAL_BLANK: U1023.2; also elsewhere on the board
GND: C901.2, C902.2, C903.2, C1019.2, C1020.2, C1021.2, C1022.2, C1023.2, U901.3 (D0), U901.4 (D1), U901.5 (D2), U901.6 (D3), U901.8 (GND), U902.3 (D0), U902.4 (D1), U902.5 (D2), U902.6 (D3), U902.8 (GND), U903.1 (Oe1), U903.2 (Oe2), U903.8 (GND), U903.9 (E1), U903.10 (E2), U1019.7 (GND), U1020.7 (GND), U1021.7 (GND), U1022.7 (GND), U1022.9, U1022.10, U1022.12, U1022.13, U1023.7 (GND); also elsewhere on the board
IDLE_READY: U1019.4; also elsewhere on the board
MAC_BANK_RESET: U1016.5, U1021.2; also elsewhere on the board
NEW_ENTRY: U1019.5; also elsewhere on the board
OVERFLOW_INDICATOR: U903.5 (Q2), U1022.1; also elsewhere on the board
POWER_RESET_N: U1018.9, U1020.3; also elsewhere on the board
QUOTIENT_DIGIT_0: U901.14 (Q0); also elsewhere on the board
QUOTIENT_DIGIT_1: U901.13 (Q1); also elsewhere on the board
QUOTIENT_DIGIT_2: U901.12 (Q2); also elsewhere on the board
QUOTIENT_DIGIT_3: U901.11 (Q3); also elsewhere on the board
Q_INC: U901.7 (CEP); also elsewhere on the board
Q_RESET: U1016.9; also elsewhere on the board
STAGE_INC: U902.7 (CEP); also elsewhere on the board
STAGE_RESET: U1016.11; also elsewhere on the board
STATUS_VISIBLE: U903.3 (Q0), U1021.9, U1023.1; also elsewhere on the board
S_DIV_ZERO_N: U1020.13; also elsewhere on the board
S_OVERFLOW_N: U1020.11; also elsewhere on the board

Notes on the sheet:
Quotient digit
Division stage
Display visibility / format / errors
Gate power and local decoupling

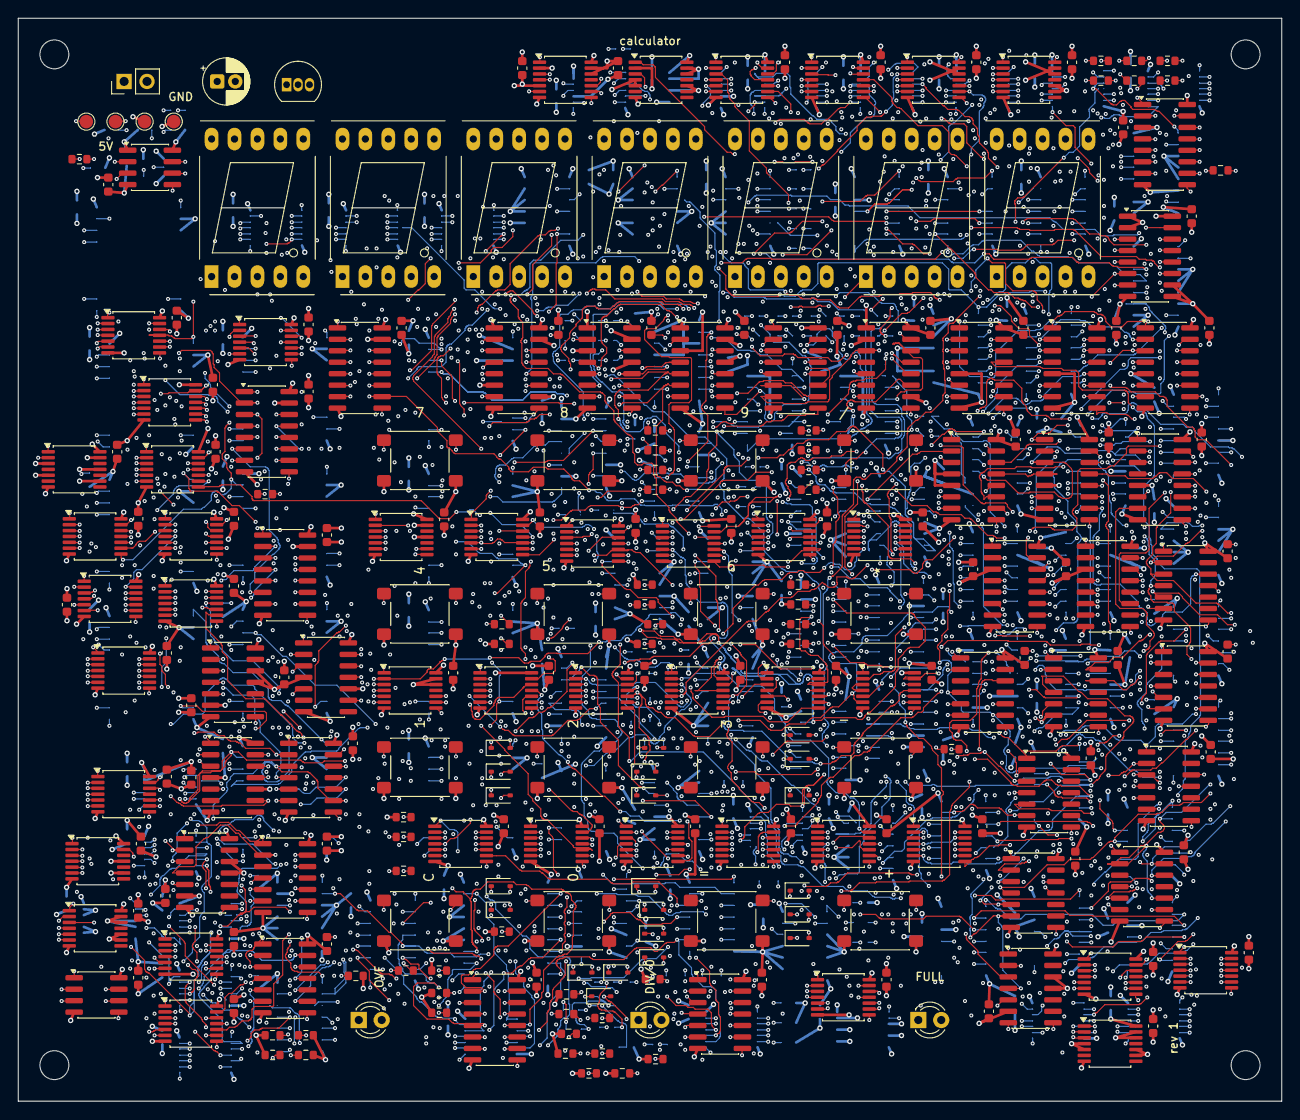
[picture p62: board calculator.kicad_pcb from above]

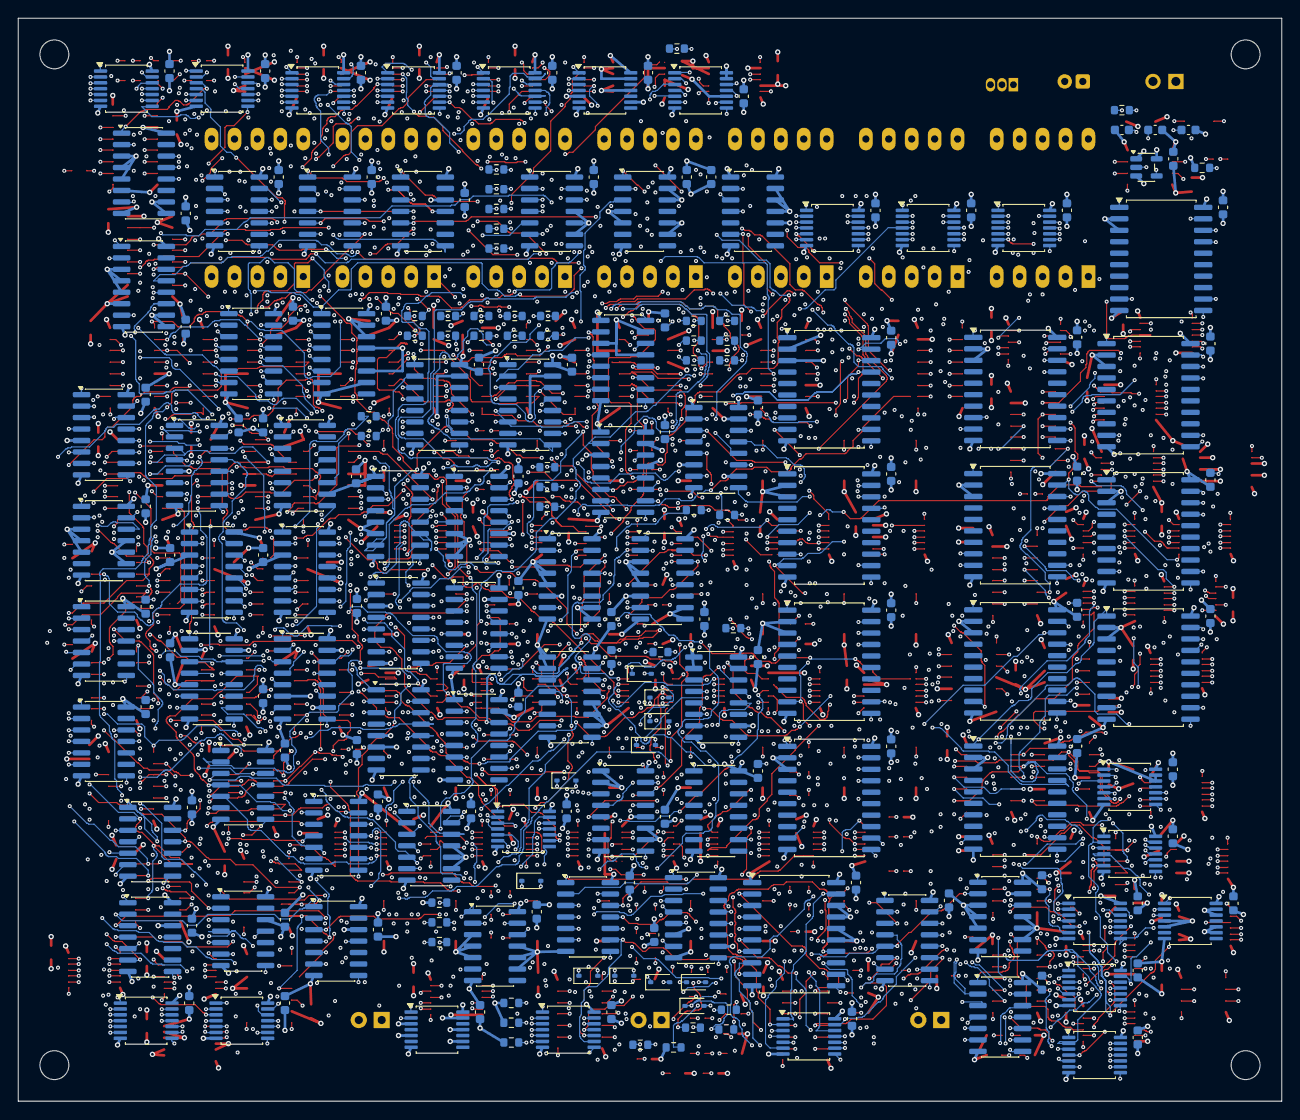
[picture p63: board calculator.kicad_pcb from below]

Board: 16 copper layers, 140.0 x 120.0 mm, 501 parts (230 on the bottom side), 664 nets.

Other parts of the board:
H1, H2, H3, H4: M3; MountingHole_3.2mm_M3
