EwoudVV/calculator/(commit log)

2026-11-01 start calculator
    [calculator.kicad_pcb, calculator.kicad_sch]
2026-11-02 draw the number registers
    [calculator.kicad_sch]
2026-11-03 draw the shared decimal adder
    [arithmetic.kicad_sch, calculator.kicad_sch]
2026-11-04 draw the digit sequencer and display controls
    [calculator.kicad_sch, display-transfer.kicad_sch, sequencer.kicad_sch]
2026-11-04 draw the main controller and division counters
    [calculator.kicad_sch, controller-branches.kicad_sch, controller-outputs.kicad_sch, controller-targets.kicad_sch, controller.kicad_sch, division-status.kicad_sch]
2026-11-04 share controller gates and check the build size
    [controller-branches.kicad_sch, controller-outputs.kicad_sch, controller-targets.kicad_sch, controller.kicad_sch, division-status.kicad_sch, parts-estimate.csv]
2026-11-05 keep the build to 14 boards and $100
2026-11-05 move the calculator to a pcb
    [arithmetic.kicad_sch, calculator.kicad_pcb, calculator.kicad_sch, controller-branches.kicad_sch, controller-outputs.kicad_sch, controller-targets.kicad_sch, controller.kicad_sch, display-panel.kicad_sch]
2026-11-06 route power and control on the pcb
    [calculator.kicad_pcb]
2026-11-08 finish routing
    goog
    [calculator.kicad_pcb]
2026-11-08 Sync Calculator from Half Life
    [BOM.csv]
